bigtreetech/BIGTREETECH-OCTOPUS-V1.0/README.md

## BigTreeTech Octopus

### review
　You can find a complete review with detailed features of our electronics in [Spanish](https://3dwork.io/btt-octopus) and [English](https://3dwork.io/en/btt-octopus/) on [3dwork.io](https://3dwork.io/).
