bigtreetech/BIGTREETECH-OCTOPUS-V1.0/Hardware/readme.txt

### The latest version of the pin map
FB BTT  group provide:

https://www.facebook.com/download/526817998687953/BIGTREETECH%20Octopus%20V1.0%20%20-%20PIN.pdf

* The schematic diagrams of V1.0 & V1.1 are the same. Compared with V1.0, V1.1 only fixes the wrong silk screen(fan, spi3, uart2) on the motherboard and has changed the packaging of the power supply IC
