bigtreetech/BIGTREETECH-OCTOPUS-V1.0/Firmware/README.md

Octopus/Pro work with Firmware | Marlin | Klipper | RepRapFirmware
-- | -- | -- | -- 
STM32F446ZE | 💚good  | 💚good | ⚠️[custom by BTT](https://github.com/bigtreetech/BIGTREETECH-OCTOPUS-V1.0/tree/master/Firmware/RepRapFirmware/F446-OctoPus)
STM32F429ZG | 💚good  | 💚good  | 💚[good](https://github.com/gloomyandy/RepRapFirmware/releases)
STM32F407ZE | 💚good  | 💚good  |  :x: 512KB flash not enough & there is no customized version yet
STM32FH723ZE | 💚good  | 💚good  |  :x: 512KB flash not enough & there is no customized version yet
