bigtreetech/BIGTREETECH-OCTOPUS-V1.0/Octopus works on Voron v2.4/Firmware/Klipper/Images/menuconfig.png

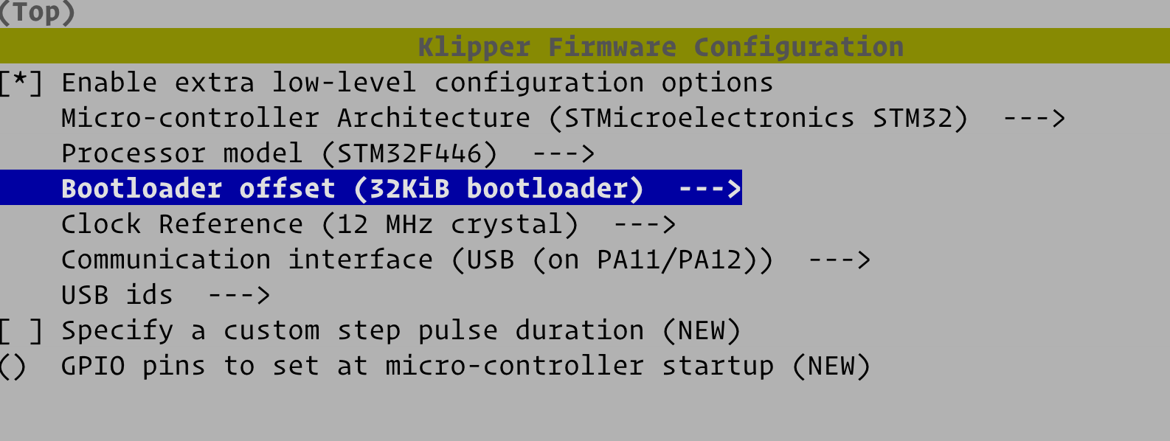
Octopus works on Voron v2.4/Firmware/Klipper/Images/menuconfig.png
