bigtreetech/BIGTREETECH-OCTOPUS-V1.0/Octopus works on Voron v2.4/Mainboard holder/Octopus stand  Horizontal.STEP

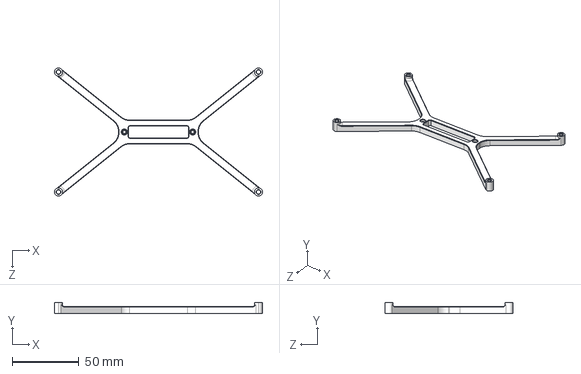
[picture p72: CAD file, 2021-07-01]
Octopus works on Voron v2.4/Mainboard holder/Octopus stand Horizontal.STEP
156.0 x 8.00 x 96.0 mm
