bigtreetech/BIGTREETECH-OCTOPUS-V1.0/Octopus works on Voron v2.4/Mainboard holder/Octopus stand   Vertical.STEP

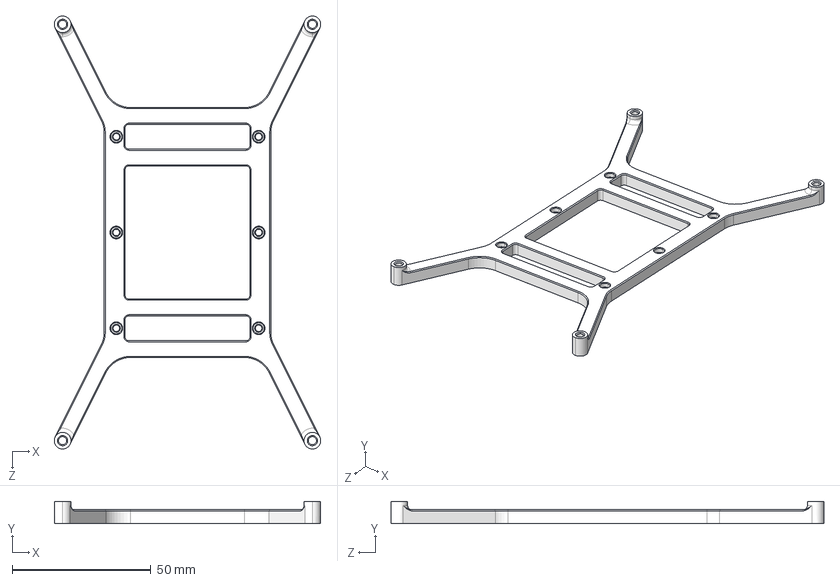
[picture p73: CAD file, 2021-07-01]
Octopus works on Voron v2.4/Mainboard holder/Octopus stand Vertical.STEP
96.0 x 8.00 x 156.0 mm
