bigtreetech/BIGTREETECH-OCTOPUS-V1.0/Octopus works on Voron v2.4/Mainboard holder/Snaps.STEP

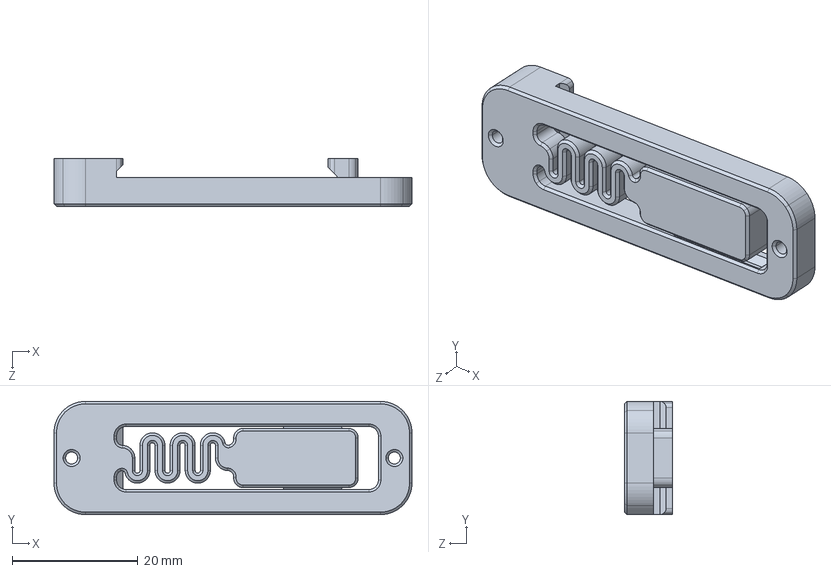
[picture p74: CAD file, 2021-07-01]
Octopus works on Voron v2.4/Mainboard holder/Snaps.STEP
56.9 x 18.0 x 7.60 mm
