bigtreetech/BIGTREETECH-OCTOPUS-V1.0/(list of files, cad)

Other CAD files:
Octopus works on Voron v2.4/Mainboard holder/Octopus stand Vertical.STL
Octopus works on Voron v2.4/Mainboard holder/Octopus stand Horizontal.STL
Octopus works on Voron v2.4/Mainboard holder/Snaps.STL
