bigtreetech/BIGTREETECH-OCTOPUS-V1.0/Firmware/RepRapFirmware/RRFBuild-SourceCode/README.md

RepRap Firmware LPC/STM32F4 Port unified build
==================================

This repository contains the build system for the LPC and STM32F4 port of RRF V3.3 and later.

To build RRF you will require additional repositories. These should be cloned into the RRFBuild directory. To create a specific version of RRF please checkout the various branches using the associated tags.
* RepRapFirmware - the main RRF source code https://github.com/gloomyandy/RepRapFirmware/tree/v3.3-dev
* RRFLibraries - Support libraries for RRF https://github.com/gloomyandy/RRFLibraries/tree/v3.3-dev
* CoreN2G - MCU specific support for LPC and STM32F4 builds https://github.com/gloomyandy/CoreN2G/tree/v3.3-dev
* FreeRTOS - RTOS support package https://github.com/gloomyandy/FreeRTOS/tree/v3.3-dev
* DuetWifiSocketServer - WiFi interface https://github.com/gloomyandy/DuetWiFiSocketServer
