bigtreetech/BIGTREETECH-OCTOPUS-V1.0/Firmware/RepRapFirmware/RRFBuild-SourceCode/CoreN2G/src/STM32F4/system/Drivers/STM32YYxx_HAL_Driver_version.md

# STM32YYxx HAL Drivers version:

  * STM32F0: 1.7.2
  * STM32F1: 1.1.4
  * STM32F2: 1.2.3
  * STM32F3: 1.5.2
  * STM32F4: 1.7.6
  * STM32F7: 1.2.7
  * STM32G0: 1.3.0
  * STM32G4: 1.1.0
  * STM32H7: 1.6.0
  * STM32L0: 1.10.2
  * STM32L1: 1.4.0
  * STM32L4: 1.10.0
  * STM32WB: 1.2.0

Release notes of each STM32YYxx HAL Drivers available here:

`system/Drivers/STM32YYxx_HAL_Driver/Release_Notes.html`

Where 'YY' is the STM32 MCU series.
