bigtreetech/BIGTREETECH-OCTOPUS-V1.0/(threads)

Thread 2 (2021-05-13):

(Q) PWM pinout

DrumClock, 2021-05-13:
Hi,
Is it possible to define PB3 and PB4 pins on J74/SPI3 conector as PWM for servo control use?

```
#define SERVO1_PIN                          PB3
#define SERVO2_PIN                          PB4
```

Thanks

bigtreetech, 2021-05-22:
Yes, you can customize

bigtreetech, 2021-05-22:
@DrumClock

Closed 2021-05-22.

Thread 4 (2021-05-16):

Motor Power in

Runklestiltskin, 2021-05-16:
Will this board support a higher voltage on motor power in?

bigtreetech, 2021-05-22:
Motor power supply is affected by capacitance, no more than 35V, main board power supply no more than 28V

bigtreetech, 2021-05-22:
@Runklestiltskin

sims-60, 2021-05-24:
@bigtreetech can i also use 12V?

looxonline, 2024-02-20:
> @bigtreetech can i also use 12V?

Yes

Thread 5 (2021-05-21):

Where is the schematic diagram?

GadgetAngel, 2021-05-21:
I hope you post the schematic diagram

cbc02009, 2021-06-19:
Please release the schematic like you have for your other boards. It's really helpful for troubleshooting issues.

HairingX, 2022-02-23:
The schematics would be very helpful indeed, please upload

GadgetAngel, 2022-02-23:
> The schematics would be very helpful indeed, please upload

The schematic has been posted.  It is just named "BIGTREETECH Octopus.pdf ". You can find it at https://github.com/bigtreetech/BIGTREETECH-OCTOPUS-V1.0/blob/master/Hardware/BIGTREETECH%20Octopus.pdf

Thread 7 (2021-05-23):

3D Step file incomplete & errors.

NAPCAL, 2021-05-23:
Step issues:
BLtouch connector has no pins.
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

5V-V_bus header; only one pin showing, and it is not through the board.
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

Also, the Daig & Boot0 connection headers are missing a pin and not through the board.
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

Power inputs and Bed output terminals are not taking up space on the board; it should start near F1 and be down to near R63.
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

Heater connections; only showing two sets of terminals when it should be four sets.
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

thisiskeithb, 2021-05-25:
Fixed in https://github.com/bigtreetech/BIGTREETECH-OCTOPUS-V1.0/commit/ec4a590edc5a7125455eeadd3bc3961491575fb9:

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

MakerJinn, 2021-06-15:
hi, I couldn't download the 3D step file listed. when I try to download it, it will open another window with codes like this
(i assume its the geometry of the parts)

how can I download this file?
Thanks a lot.

DATA;
#10=CURVE_STYLE('',#272,POSITIVE_LENGTH_MEASURE(0.1),#15793);
#11=CURVE_STYLE('',#273,POSITIVE_LENGTH_MEASURE(0.1),#17518);
#12=CURVE_STYLE('',#274,POSITIVE_LENGTH_MEASURE(0.1),#17519);
#13=CURVE_STYLE('',#275,POSITIVE_LENGTH_MEASURE(0.1),#17520);
#14=CURVE_STYLE('',#276,POSITIVE_LENGTH_MEASURE(0.1),#17521);
#15=CURVE_STYLE('',#277,POSITIVE_LENGTH_MEASURE(0.1),#42384);
#16=CURVE_STYLE('',#278,POSITIVE_LENGTH_MEASURE(0.1),#42384);
#17=CURVE_STYLE('',#279,POSITIVE_LENGTH_MEASURE(0.1),#42384);
#18=CURVE_STYLE('',#280,POSITIVE_LENGTH_MEASURE(0.1),#42384);
#19=CURVE_STYLE('',#281,POSITIVE_LENGTH_MEASURE(0.1),#42384);
#20=CURVE_STYLE('',#282,POSITIVE_LENGTH_MEASURE(0.1),#42384);
#21=CURVE_STYLE('',#283,POSITIVE_LENGTH_MEASURE(0.1),#42384);
#22=CURVE_STYLE('',#284,POSITIVE_LENGTH_MEASURE(0.1),#42384);
#23=CURVE_STYLE('',#285,POSITIVE_LENGTH_MEASURE(0.1),#42384);
#24=CURVE_STYLE('',#286,POSITIVE_LENGTH_MEASURE(0.1),#42384);
#25=CURVE_STYLE('',#287,POSITIVE_LENGTH_MEASURE(0.1),#42384);
#26=CURVE_STYLE('',#288,POSITIVE_LENGTH_MEASURE(0.1),#42384);
#27=CURVE_STYLE('',#289,POSITIVE_LENGTH_MEASURE(0.1),#42384);
#28=CURVE_STYLE('',#290,POSITIVE_LENGTH_MEASURE(0.1),#42384);
#29=CURVE_STYLE('',#291,POSITIVE_LENGTH_MEASURE(0.1),#42384);
#30=CURVE_STYLE('',#292,POSITIVE_LENGTH_MEASURE(0.1),#42384);
#31=CURVE_STYLE('',#293,POSITIVE_LENGTH_MEASURE(0.1),#42384);
#32=CURVE_STYLE('',#294,POSITIVE_LENGTH_MEASURE(0.1),#42384);

tregnier, 2021-06-22:
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

I use github desktop to download step file. There is way to do it through web interface directly, but much easier with github desktop

Pixeltrace-GER, 2021-07-16:
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

Just press the Download Button or clone the Repo

Thread 17 (2021-05-31):

Cant get Connection with USB-C

dazkit, 2021-05-31:
I can't get a connection via USB-C. If I set the jumper for Boot0, then I get the Octopus displayed as Stm32 Bootloader. The jumper next to the power LED is also set for USB-C. What can I do? Is my Board broken?

dazkit, 2021-05-31:
I solved it. My SD card reader was the problem. I used a different card reader and a different SD card to transfer the firmware.bin. And now it works.

Closed 2021-05-31.

Thread 18 (2021-05-31):

Uart / PINOUT

DJames2682, 2021-05-31:
The uart pin in klipper refers to Expansion pins in the pinout. Which is correct?

Jasonpenman, 2021-06-01:
For stepper drivers use the cs pin from the driver section of the pin diagram, I set mine up over the weekend and needed to get them working. My bad if it wasnt driver uarts you where after, if it was this should help

DJames2682, 2021-06-02:
Thank you . It was very confusing because the sample klipper config pointed
to expansion pins as uart pins for the 2208s.

Thank you.

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

Jasonpenman, 2021-06-02:
Glad to help, i was super careful setting klipper up for it. Seems a really good board so far

Thread 19 (2021-06-01):

dual z stepping motors  with Z_MULTI_ENDSTOPS,compling error

sunnypiggggy, 2021-06-01:
here is my sets in Configuration_adv.h
```
//
// For Z set the number of stepper drivers
//
#define NUM_Z_STEPPER_DRIVERS 2   // (1-4) Z options change based on how many

#if NUM_Z_STEPPER_DRIVERS > 1
  // Enable if Z motor direction signals are the opposite of Z1
  //#define INVERT_Z2_VS_Z_DIR
  //#define INVERT_Z3_VS_Z_DIR
  //#define INVERT_Z4_VS_Z_DIR

  #define Z_MULTI_ENDSTOPS
  #if ENABLED(Z_MULTI_ENDSTOPS)
    #define Z2_USE_ENDSTOP          _XMAX_
    #define Z2_ENDSTOP_ADJUSTMENT   0
    #if NUM_Z_STEPPER_DRIVERS >= 3
      #define Z3_USE_ENDSTOP        _YMAX_
      #define Z3_ENDSTOP_ADJUSTMENT 0
    #endif
    #if NUM_Z_STEPPER_DRIVERS >= 4
      #define Z4_USE_ENDSTOP        _ZMAX_
      #define Z4_ENDSTOP_ADJUSTMENT 0
    #endif
  #endif
#endif
```

stepper drivers
```/**
 * Stepper Drivers
 *
 * These settings allow Marlin to tune stepper driver timing and enable advanced options for
 * stepper drivers that support them. You may also override timing options in Configuration_adv.h.
 *
 * A4988 is assumed for unspecified drivers.
 *
 * Use TMC2208/TMC2208_STANDALONE for TMC2225 drivers and TMC2209/TMC2209_STANDALONE for TMC2226 drivers.
 *
 * Options: A4988, A5984, DRV8825, LV8729, L6470, L6474, POWERSTEP01,
 *          TB6560, TB6600, TMC2100,
 *          TMC2130, TMC2130_STANDALONE, TMC2160, TMC2160_STANDALONE,
 *          TMC2208, TMC2208_STANDALONE, TMC2209, TMC2209_STANDALONE,
 *          TMC26X,  TMC26X_STANDALONE,  TMC2660, TMC2660_STANDALONE,
 *          TMC5130, TMC5130_STANDALONE, TMC5160, TMC5160_STANDALONE
 * :['A4988', 'A5984', 'DRV8825', 'LV8729', 'L6470', 'L6474', 'POWERSTEP01', 'TB6560', 'TB6600', 'TMC2100', 'TMC2130', 'TMC2130_STANDALONE', 'TMC2160', 'TMC2160_STANDALONE', 'TMC2208', 'TMC2208_STANDALONE', 'TMC2209', 'TMC2209_STANDALONE', 'TMC26X', 'TMC26X_STANDALONE', 'TMC2660', 'TMC2660_STANDALONE', 'TMC5130', 'TMC5130_STANDALONE', 'TMC5160', 'TMC5160_STANDALONE']
 */
#define X_DRIVER_TYPE  TMC2209
#define Y_DRIVER_TYPE  TMC2209
#define Z_DRIVER_TYPE  TMC2209
//#define X2_DRIVER_TYPE TMC2209
//#define Y2_DRIVER_TYPE TMC2209
#define Z2_DRIVER_TYPE TMC2209
//#define Z3_DRIVER_TYPE TMC2209
//#define Z4_DRIVER_TYPE TMC2209
#define E0_DRIVER_TYPE TMC2209
//#define E1_DRIVER_TYPE TMC2209
//#define E2_DRIVER_TYPE TMC2209
//#define E3_DRIVER_TYPE TMC2209
//#define E4_DRIVER_TYPE TMC2209
//#define E5_DRIVER_TYPE TMC2209
//#define E6_DRIVER_TYPE TMC2209
//#define E7_DRIVER_TYPE TMC2209
```

and

`#define SENSORLESS_PROBING
`

the error messages are

`                 from Marlin\src\HAL\STM32\tft\gt911.cpp:24:
Marlin\src\HAL\STM32\tft\../../../inc/SanityCheck.h:2138:6: error: #error "Z2_USE_ENDSTOP must be set with Z_MULTI_ENDSTOPS."
 2138 |     #error "Z2_USE_ENDSTOP must be set with Z_MULTI_ENDSTOPS."
      |      ^~~~~
*** [.pio\build\BIGTREE_OCTOPUS_V1_0\src\src\HAL\STM32\tft\gt911.cpp.o] Error 1`

[configs.zip](https://github.com/bigtreetech/BIGTREETECH-OCTOPUS-V1.0/files/6577421/configs.zip)

Closed 2021-06-03.

Thread 21 (2021-06-04):

pinout description missing/wrong in Hardware/BIGTREETECH Octopus V1.0 - PIN.pdf

kw3-research, 2021-06-04:
missing description for
J16  (diag0)
J17 (diag1)
J18 (diag2)
J19 (diag3)
J20 (diag4)
J21 (diag5)
J22 (diag6)
J23 (diag7)

as indicated on user manual:
4.2STALLGUARD JUMPER SETTINGSThe  “diag” jumpers which  are  used  to  connect  the  diagnostic output  pin  to  the  endstop inputs  for drivers which  support  the  stallguard feature  (TMC2209/TMC2226)  can  be  found in the location shown in the image below.The exact diag numbering can be found by looking at the pins file or the silkscreen beneath the board.

and mention 'diag n." incorrectly assigned to endstops connectors (instead "stop n.")

jwestmoreland, 2025-01-06:
Hello,
Can you please post this:
https://www.facebook.com/download/526817998687953/BIGTREETECH%20Octopus%20V1.0%20%20-%20PIN.pdf
- somewhere besides facebook?  We all don't have facebook accounts - not a great assumption IMHO.  When I
tried to download - it said I had to have a facebook account to download - maybe that wasn't the case when this was originally posted.

Thanks,
John

Thread 22 (2021-06-08):

Octopus not detected

sims-60, 2021-06-08:
I connected the octopus to my pc and then on the octopus the leds also light up but the pc don't detect the octopus board

dazkit, 2021-06-08:
try that https://github.com/bigtreetech/BIGTREETECH-OCTOPUS-V1.0/issues/17

sims-60, 2021-06-08:
ok

dazkit, 2021-06-08:
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
you have to put this jumper to connect via usb

sims-60, 2021-06-08:
but when it is the sd card reader why the pc then can't connect to the board

dazkit, 2021-06-08:
do you use an external power supply or do you only connect it with usb? If you only connect it with USB you have to set the jumper next to the Power LED

sims-60, 2021-06-08:
i use usb and i have set the jumper and the leds also light up

dazkit, 2021-06-08:
Try to set the Jumper at Boot0. Did  you get a USB connection?

sims-60, 2021-06-08:
yes

dazkit, 2021-06-08:
I had the same Problem after i installed the firmware.bin then i get a connection. Its not a Problem from the SD Card reader. Try to reinstall the firmware.bin

sims-60, 2021-06-08:
what do you mean with reinstall the firmware.bin

dazkit, 2021-06-08:
Firmware is marlin or klipper. Which one do you want to use?

sims-60, 2021-06-08:
klipper

dazkit, 2021-06-08:
https://github.com/bigtreetech/BIGTREETECH-OCTOPUS-V1.0/blob/main/BIGTREETECH_Octopus_EN.pdf

here on page 20. You have to create a firmware.bin and insert it into the board with a MicroSD card and transfer it

sims-60, 2021-06-08:
i know

sims-60, 2021-06-08:
have you discord? because i cant send my firmware on github github not support .bin files

dazkit, 2021-06-08:
sorry i have no discord. I had the same Problem after i create the firmware.bin and transfer it with a sd card my board was not recognized with USB. Than i used a different SD Card and now it works. I think you have the Same Problem as me. If that's not the problem, then your board is probably broken

sims-60, 2021-06-08:
do you use klipper?

sims-60, 2021-06-08:
and  i have the exat same problem

sims-60, 2021-06-08:
can you send me your firmware.bin?

sims-60, 2021-06-08:
here is my email

sims-60, 2021-06-08:
fkp00065@zwoho.com
its a trash mail which only exist for 10 minutes

dazkit, 2021-06-08:
okay

sims-60, 2021-06-08:
thank you

sims-60, 2021-06-08:
I WORKS

sims-60, 2021-06-08:
i think i had an error im my firmware

dazkit, 2021-06-08:
Ok then close this thread and have fun :)

sims-60, 2021-06-08:
thank you

lowtolerance, 2021-06-13:
Can I have this magic firmware.bin? I can't seem to get this board to recognize my binary off of the SD card, and IDK if it's the binary of the board. A known-good klipper binary would be a big help, and I'm not sure why BTT doesn't give publish one themselves.

sims-60, 2021-06-13:
hi  can you send a mail to this mail : sqf86920@eoopy.com?
then i will send you the firmware

sims-60, 2021-06-13:
because i can't send a .bin file with github

lowtolerance, 2021-06-13:
I actually managed to sort this out myself, I don't think your firmware
would have helped. I jumped two of the wrong pins for sensorless homing and
I think it was putting the bootloader into an error state.

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

sims-60, 2021-06-13:
oh ok in this moment i wanted to send you the email XDDDD

Voodoobrew101, 2021-09-30:
I dont use klipper, but in Marlin these sound like the types of issues you get when you use the wrong
#define SERIAL_PORT           1  // TFT
#define SERIAL_PORT_2      -1  // USB
#define SERIAL_PORT_3       2  // RPI, Raspberry Pi
settings. In my experience the order is also important. My settings are as above, which are the defaults in this github.

drelich, 2022-09-07:
I know this is a year old topic, and I hate to resurrect it, but just was dealing with the same thing. For two hours I was pulling my hair because I couldn't see any response to either `lsusb` nor `ls /dev/serial/by-id/*`

Turned out I accidentally compiled Klipper FW with the wrong MCU frequency. My board is model 429 with MCU freq. of 8MHz but I compiled the FW for the other version with 12MHz. Once I realised my mistake and recompiled FW with the correct frequency, the board indeed came back to life and I could see meaningful output to both the `lsusb` and `ls /dev/serial/by-id/*` commands.

Just thought I'd share in case somebody made the same mistake :)

whatder1, 2025-01-01:
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

How did you get the updated firmware installed?  Using the SD?  I ask because I think I may have bricked mine but I can't seem to update the firmware using the SD card (downloaded a stock firmware file from BTT's GitHub, renamed it to firmware.bin and inserted into the Octopus).  the firmware file hasn't been renamed so I suspect that it isn't flashing...

Closed 2021-06-08.

Thread 24 (2021-06-10):

Klipper UART

DJames2682, 2021-06-10:
It appears the uart pins for 2208's are labled as expansion pins.
Is this correct ?
for example PE8 is labled as Motor uart pin but also labled as an expansion pin EXP1_1.

dazkit, 2021-06-11:
You have to adjust it. These are the uart pins. The ones marked in red. For uart you only need the #uart_pin. You can delete the #tx_pin reference.

this is from the new Pin.pdf
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

tregnier, 2021-06-22:
that worked for me like this too.

Don't follow the config file for klipper configuration from this github, just set the jumper as shown on the manual, and then set UART_pin based on CS column mention here. nothing else needed
Thanks dazkit

Thread 25 (2021-06-13):

Entering DFU mode

lowtolerance, 2021-06-13:
How do I actually  get the Octopus into DFU mode? I've tried putting a jumper on the boot pins and pressing the reset button as well as pressing and holding the reset button, but nothing I do seems to force DFU.

lowtolerance, 2021-06-14:
I had a misplaced jumper that I think was causing the bootloader to hang. With the jumper removed I was able to communicate with Octopus from STM32CubeProgrammer

Closed 2021-06-14.

Thread 27 (2021-06-19):

power in puts 5v out

luigi20000, 2021-06-19:
hello,
i run on my board klipper so I use a raspberry pi and my octopus board keeps powered on.
my power supply is activated with a relay because it has a fan.
but wat i found now is that the fan gets power from the power in this cant be normal i think?
i know about the jumper but the board need to be kept powered on for me

Thread 28 (2021-06-20):

Unknown board ID 'marlin_BigTree_octopus_v1'

user-e, 2021-06-20:
How to reproduce:

- Clone the rep
- Open it with Vs Code with PlatformIO
- Build

Result:
```

Executing task: platformio run

Processing BIGTREE_OCTOPUS_V1_0 (platform: ststm32@~12.1; board: marlin_BigTree_octopus_v1; framework: arduino)
-----------------------------------------------------------------------------------------------------------------------------------------------------------------------------
Error: Unknown board ID 'marlin_BigTree_octopus_v1'
The terminal process "platformio 'run'" terminated with exit code: 1.

Terminal will be reused by tasks, press any key to close it.
```

Default Configuration.h, default Configuration_adv.h, and default Platformio.ini

DJames2682, 2021-06-20:
Hey I just did this. Go into the boards.h file in marlin 2.0.9 highlight
the Btt_ octopus and copy the info that pops up. Exactly.

They changed the name. In 2.0.9

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

user-e, 2021-06-20:
@DJames2682
I'm not sure to had understood you. That's the popup that appear in boards.h file at the octopus declaration:

[Image](https://i.postimg.cc/TP6YDrG5/Schermata-da-2021-06-20-20-25-31.png)

bwspath, 2021-06-23:
the board name in ini/stm32f4.ini is wrong:
` -board             = marlin_BigTree_octopus_v1`
vs
`+board             = marlin_BigTree_Octopus_v1`
that  should fix it.

DJames2682, 2021-06-23:
Sorry I went back and looked. The build environment that worked or me was BTT_OCTOPUS_V1 in 2.0.9.

Also.

Octopus 1.0. thermal runaway and connection issues after bootloader and firmware update.
Almost burnt it down . Cant communicate with the pc to reload the new bootloader, flash firmware, and the mcu get so hot it resets every 15 sec. Oh and every heater turns on and stay on. Be careful.

user-e, 2021-06-23:
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

It works! Perfect!

Closed 2021-06-23.

Thread 30 (2021-06-22):

Communication Error

DJames2682, 2021-06-22:
While Flashing an updated marlin I was having difficulty maintaining communicaiton wiht the board.
The new firmare refuses to flash.
I atempted to update the bootloader but the board is recognized by the pc but not the bootloader softwear.
When hooked to pronterface. Reads connected.
When the mcu is powered it constantly drops the connection.
Please advise.

Thread 31 (2021-06-22):

Urgent issue

DJames2682, 2021-06-22:
Upon loading the new bootloader, USB Counication will not establis,
New firmware.bin files will not flash. The board constantly reboots and the MCU is extreamly hot.

More importantly.
A major issue with thermal runaway. All heaters on the board when recieving power for the main begin to heat uncontrollably.
this occurs with the Bed, Heater 0 and 1 (I note that all the indicator lights for the heaters are on.

This could have lead to a fire or metdown.
I've seen several other posets in varrious forums to this effect.

user-e, 2021-06-23:
@DJames2682
I know that this is not a forum but...
If you are no more able to flash the MCU through DFU or SD card, you can try to program it with the ST-Link Programmer and write the older bootloader.

DJames2682, 2021-06-23:
It is not but I thought the situation with the thermal runaway warented someone looking into it.
The board will connect to the pc but the software will not recognize it.

looxonline, 2021-07-03:
As far as I understand this was because of some incorrect wiring on the probe. Is that correct?

DJames2682, 2021-07-03:
Yep. Had the pins switches on the z endstop w/ a bltouch....not entirely
sure why I caused the heater issues

On Sat, Jul 3, 2021, 12:26 PM Luke Harrison ***@***.***>
wrote:

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

Thread 33 (2021-06-25):

Pin PB7 on J40 is not working

ewalbridge, 2021-06-25:
Pin PB7 on J40 (SENSOR) is not working for the inductive proximity sensor but when I connect it to PB7 J43 (BL_TOUCH) it works. The inductive proximity sensor is 24v so I need the 24v from J40 and not the 5v from J43.

Is there a setting I am missing or a jumper that I need to set to enable PB7 to work on J40?

looxonline, 2021-07-03:
There are a few options available to get this to work. You likely have an NPN style sensor which means that you will need to add an external pull up. To you this you just need to connect a 4k7 resistor between the voltage pin of the probe and the signal pin. Then you will need to configure your firmware to invert the input signal and enable the pull down, ~! in Klipper. There will be no BAT85 required with this config.

denisrohr, 2021-07-12:
If you look at https://github.com/bigtreetech/BIGTREETECH-OCTOPUS-V1.0/blob/master/Hardware/BIGTREETECH%20Octopus.pdf
you can see the pin "PROBE" on J40 is attached to an optocoupler EL357C with a 1k resistor. The optocoupler has a 1.4V forward voltage and a max current of 50mA. This means you can attach any signal to it directly without any diode, even 48V should be fine. Attach the 12V-48V signal of the probe directly to the third pin of J40. The third pin is NOT PB7, but connects to an optocoupler which sets PB7 to HIGH if PROBE has atleast 12V voltage.
DO NOT attach PROBE directly to PB7 on J43.

I use a NO inductive probe without any diodes at 12V supply voltage and connected the signal pin directly to PROBE on J40.
My klipper config is:

...
[probe]
pin: ~PB7
...

ga73, 2021-07-17:
This really needs to be resolved and poor by BTT to just not answer... Doesn't give me any reason to buy their products when others such as FYSETC actually respond to issues!

Answer please with a solution BTT!

looxonline, 2021-07-17:
> This really needs to be resolved and poor by BTT to just not answer... Doesn't give me any reason to buy their products when others such as FYSETC actually respond to issues!
>
> Answer please with a solution BTT!

There is no point for them to respond when the answer has already been given in this thread. If you took the time to read it instead of getting aggressive and threatening then you would already have your issue solved. Otherwise, there is always the Fysetc which will literally kill your LCD in a puff of smoke and a high % of the boards were suiciding on their first power up with drivers installed.

looxonline, 2021-07-17:
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

This is only true if your probe is PNP style. I.e. that it will output a high voltage when triggered (or when not triggered) and simply float when in the opposite state. If you have an NPN style probe that pulls to ground when active and floats otherwise then you'll need to add a little pull up resistor between the probe signal pin and the voltage supply to the probe. That will provide the current source for when the probe leaves the signal pin floating that will in turn drive the optocoupler.

ga73, 2021-07-17:
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

Nobody is "getting aggressive", I'm looking for an official reply from btt who seem to be happy to let their customers sort out their problems, there are 2 answers both of which aren't clear to me and I'm guessing many others who aren't as electronically minded as some.

Your reply seems a little bit pointless as it's of absolutely no benefit, maybe if you're going to reply make your replies helpful or just say nothing.

looxonline, 2021-07-17:
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

I encourage you to browse through these github issues. You should notice that BTT don't use this as a channel to provide customers with support. Their github is a repo to provide customers with info on their products. They have specific support channels which can be found on their discord server, facebook groups and websites. The issues tab is left open specifically for customers to discuss things in an open forum. Granted, it may be best for them to include that info in their readme files to make it clear.

My reply is quite helpful actually, maybe not to you but to others. Why?

1.) It should help others to see that there is actually no problem whatsoever with this input. Users simply need to connect up to it in the right way.

2.) It should help users who read your response demanding a reply from btt to clearly understand that the answer has already been provided. Twice on this thread in fact. They therefore can take the info that has already been provided and apply it instead of being left in doubt as to whether or not it will work.

3.) It should help users to be aware of the issues with the Fysetc board so that they can make an educated decision about whether or not they would be willing to take the chance with it.

Back to the point at hand. To fix your connection you need to:

> "connect a 4k7 resistor between the voltage pin of the probe and the signal pin."

In addition to the above you need to remove the BAT diode completely as it is not needed with this input. It is an optocoupler which is better than the standard inputs on other boards and has no need for a protection diode. Instead all it needs is a pull up resistor with NPN style probes which is evidently what you are using.

ga73, 2021-07-17:
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

Hi thanks for the reply which is helpful.

So in laymens terms, I simply need to solder the 4k7 resistor to both the v+ and the probe sensor wire and remove the bat85 resistor?

Many thanks
Ga

looxonline, 2021-07-17:
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

Exactly. Solder or crimp into the connector terminals for the probe. Whichever works best for you.

ga73, 2021-07-17:
Thank you very much! 😊👍

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

mj2068, 2021-07-18:
i've been combating this issue for a whole day in the office, on a Sunday. And now, it's 1 am in the morning, i'm still reading on the web trying to find answers to prepare for tomorrow. i'm so so happy i found this post, and it seems exactly like my situation, so, after reading the whole thing, i'm fairly confident, it'll be solved right after i shovel that 4.7k R in there, first thing in the morning.
people like you, @looxonline, are the unsung heroes of the internet, for that, i salute to you.

onurddd, 2021-08-04:
Can anyone share marlin config file with working probe settings please

looxonline, 2021-08-04:
> Can anyone share marlin config file with working probe settings please

What kind of a probe are you using and where have you connected it. There is not just one config file because there are hundreds of different probe permutations out there.

onurddd, 2021-08-04:
Sorry, I use NPN type capacitive sensor that connected to j40 header. I will not use  z min switch . Capacitive probe will be  used for bed leveling and  as a z min limit switch.

looxonline, 2021-08-04:
> Sorry, I use NPN type capacitive sensor that connected to j40 header. I will not use z min switch . Capacitive probe will be used for bed leveling and as a z min limit switch.

Then you will need to apply the pull up resistor mentioned earlier in this thread. You will also need to enable a software pull down on PD7 within Marlin and likely set the signal to inverting for the probe on PD7.

looxonline, 2021-08-04:
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

Unfortunately I don't but I know that it does work from having helped many others to get it to work. You may also need to check that the pin mappings in the pins file are correct too. Also remember that you can't/don't need to use a BAT85 with this board.

Teila, 2021-08-05:
While I am not using the octopus on my marlin controlled system (klipper based  for this guy) I had to use the following setup for my inductive probe.

[probe]
pin: ~PB7 #enable micro-controller pulldown

amazon.com/gp/product/B08MX6SHD4 <- Probe I am using

Aurawin, 2021-08-07:
I've just got mine working with no resistor by re-mapping the J31 diag pin PG10 -> you can re-map marlin to look there for the low voltage signal - assuming your inductive probe goes to ground when triggered.

#define Z_MIN_PROBE_PIN PG10
#define Z_STOP_PIN PG10

onurddd, 2021-08-09:
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

As Teila said, Bp7 pin needs to be pulled down. İf you look at the octopus pins you can see Probe has a optocoupler at j40 header. Then this optocoupler connected to Pb7 pin . There is an exposel Pb7 pin on j43 header if you measure  the pb7 and gnd pins with a voltmeter, you need to measure 3.3 volts. İf you trigger the probe (j40 header)  without any pull down and pull up pb7 voltage goes to 0.6-0.7 volts and signal doesn't count as 0. If you assign pull down to Pb7, when you trigger the probe Pb7 voltage goes to 0.08 and it counts as 0 signal.

Aurawin, 2021-09-22:
I wanted to try using the optocoupler.  This time I'm using a NO PR18-5DP Cylindrical Type Detector 5mm DC12-24V 3-Wire PNP NO(Normally Open) with 24V selected input wired to J40.  If I measure PB7 on J43 when the sensor is triggered I can see the 3.3V when triggered and 0.4-.7v when not triggered.

#define MOTHERBOARD BOARD_BTT_OCTOPUS_V1_1

// No combination of Endstop pulling changes the fact that marlin will not detect the probe
// #define ENDSTOPPULLUP_ZMIN_PROBE
// #define ENDSTOPPULLDOWN_ZMIN_PROBE

#define Z_MIN_PROBE_PIN PB7

But no matter what I do I can't get Marlin to detect the signal using M119 - It's always triggered for Non-Inverted signals or always open for signal inversion.

I'm using 2.0.9.1 from Marlin direct, are there any changes lately that the upstream repo doesn't have regarding this issue?

looxonline, 2021-09-22:
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

Try the latest bugfix. I've had issues with 2.0.9.1.

onurddd, 2021-09-22:
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

Try to cancell all the pull ups and activate pulldown for  Z_MIN_PROBE_PIN PB7, ZMIN_PROBE and ZMIN. I couldn't make it work untill the pull down resistors are activated.

Aurawin, 2021-09-22:
@onurddd , I tried enabling the pulldowns but got this error on building
Compiling .pio\build\BIGTREE_OCTOPUS_V1\src\src\HAL\STM32\eeprom_sdcard.cpp.o
In file included from Marlin\src\HAL\STM32\../../inc/MarlinConfig.h:49,
                 from Marlin\src\HAL\STM32\HAL.cpp:28:
Marlin\src\HAL\STM32\../../inc/SanityCheck.h:725:4: error: #error "PULLDOWN pin mode is not available on the selected board."

Aurawin, 2021-09-23:
Update:  Got it working.  Looked in Marlin Source code and the pulldown code wasn't being executed.  The reason being
Configuration.h ...

#define USE_ZMIN_PLUG
#define USES_Z_MIN_PROBE_PIN PB7

These 2 defines need to be declared in order for the ENDSTOPPULLDOWN_ZMIN_PROBE to pull the voltage down on the optocoupler.

rakeshdutta90, 2021-09-30:
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

Does that mean you are saying if I use PNP style probe and select 12v/24v from J38 and connect the signal wire from the probe directly to PB7 (J40) will get the reading from without any issue?

rakeshdutta90, 2021-09-30:
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

So if I use PNP NO
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

Thread 36 (2021-07-06):

Voron 2.4/Klipper TMC2209 Steppers off

ga73, 2021-07-06:
Hello, followed the instructions exactly, Voron starts up but motors do not move and message on LCD "Steppers OFF".

Is this a bug or a setting that needs to be updated in the config ??

Thank you.

looxonline, 2021-07-17:
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

Since there are thousands of octopus users who don't have this issue it would clearly seem to be something with your config. The best place to find support on this would be the Bigtreetech channel on the Voron discord or the VoronElectronics channel.

Thread 37 (2021-07-07):

FAN do not get full speed

fiveorders, 2021-07-07:
Hello, I am using FAN0 port for the radial blower fan but it doesn't get full speed when %100 and when %50 it stops. I am using a 5v Radial FAN. Tried with 12v radial fan by switching to 12v by jumper. It is the same. And also I used the always on fan ports but they do not go full speed as well. What am I doing wrong? Thanks

Closed 2021-07-11.

Thread 39 (2021-07-13):

no flashing

Michil783, 2021-07-13:
I have Octopus v1.1 and since today I could not flash a new firmware.bin file via SD card. firmware.bin is renamed to firmware.cur (0 bytes length) but it is not flashed. Still old firmware active and working. FUnctionality of 3D printer is normal.
I also tried to flash bootloader (which was successful) but no change in behaviour

Michil783, 2021-07-15:
Problem solved. Somehow the firmware.bin file was 0 bytes in size and I didn't recognized it.

Closed 2021-07-15.

Thread 41 (2021-07-13):

max output for neopixel port ?

DocYester, 2021-07-13:
what amount of led's can be connected to the neopixel-port ?
or what is the max output in mA on PB0 (J37) ?

Seminole81, 2021-08-12:
Did you find out? I am also wondering this.

DocYester, 2021-08-16:
No, i'll keep it as for other boards ... 30 led max -> 1,5A peak
Actually running it without problems

Seminole81, 2021-08-16:
I read somewhere last night that the max. amps this board can handle is 8. However, I have heard from BTT that it can do up to 30 without max. current. I saw someone 44 fine.

DocYester, 2021-08-16:
8A all over the 5V rails ... so you cant use it all for calculating for led's - i read it in the docs too
i think it could handle several more, but i wont test it just to fry the board

so i'm waiting for an official answer

Seminole81, 2021-08-18:
Ok, well someone else I know on Facebook is successfully running 60 LEDs with the board. BTT told me 30 via an email (guessing that's a safe one).

matthewdolman, 2021-11-03:
Oops, I didn't realise this could fry the board, I just thought it would stop working if too much power gets drawn.

I ran 144, with nothing else going, I tried to add another 72 but got a message in klipper that the max was 166.  It would be nice if there was some documentation or even a response from BTT on this.

simplified-life, 2022-12-08:
I'm just about to wire up 90 neopixel LED's, but thinking perhaps it is better to power them all from with a 24v to 5v step down and then control them with the Raspberry Pi. Or should I control them off the Bigtreetech Octopus Pro 1.0 board I've got coming?

matthewdolman, 2022-12-09:
You will need a 5v power supply that can handle the current of the LEDs the normal budget for neopixels is 0.05A so for 100 you will want 5A from your power supply, in addition you will need power for your raspberry pi.  I ended up getting a 16A one to give me plenty of room.

Thread 42 (2021-07-17):

PROBE SENSOR NOT WORKING

ga73, 2021-07-17:
Can someone advise on how to get the probe sensor working, its all wired correctly and has the bat85 installed.. Probe lights up and off when putting something metal underneath but is not sensed in the fw.

Does this need moving to another pin or ??

looxonline, 2021-07-17:
> Can someone advise on how to get the probe sensor working, its all wired correctly and has the bat85 installed.. Probe lights up and off when putting something metal underneath but is not sensed in the fw.
>
> Does this need moving to another pin or ??

The answer to this has already been provided in the other issue where you had a rant. Just read it and apply it and you will be good to go.

Aurawin, 2021-08-07:
Alternatively, I've just got mine working with no resistor by re-mapping the J31 diag pin PG10 -> you can re-map marlin to look there for the low voltage signal - assuming your inductive probe goes to ground when triggered.

#define Z_MIN_PROBE_PIN PG10
#define Z_STOP_PIN PG10

Just remove the actual pin from the 3 pin JST connector and manually put it into PG10.

Hman32, 2022-04-16:
Will be dangerous if the probe does not output 5v or less when he trigger...
The sensor port is intended to be protected with a optocoupler, just sad is not working as expected.
In my case I ended adding an external optocoupler and I've used the pin for the Z endstop.

Thread 43 (2021-07-17):

RRF SBC version

valenti1234, 2021-07-17:
Since I try to recompile, but without success, can you guys put an SBC version of RRF firmware?

wolfgangmauer, 2021-08-09:
I need this too !!!

wolfgangmauer, 2021-08-10:
And please also describe how the RPi must be connected.

jaysuk, 2021-08-10:
you would need to create a new build with SBC support enabled.
The WiFi version that BTT built it very buggy anyway so honestly, I wouldn't even bother running RRF of this board.
This is due to the MCU only have 512kb flash.
RRF is only going to require more flash going forwards.

wolfgangmauer, 2021-08-10:
What a shame, I really like RRF and the VORON-kits come with an OctoPus
and RPi....

Am 10.08.2021 um 15:13 schrieb jaysuk:
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

Thread 44 (2021-07-20):

EXP pins in diagram wrong

cmathiswausau, 2021-07-20:
According to the silk screen and the pins diagram the diagram below is incorrect, it should be PB2 for pin 6 and PB1 for pin 8.

/**
 *               ______                                              ______
 *           NC | 1  2 | GND                                     5V | 1  2 | GND
 *        RESET | 3  4 | PC15 (SD_DETECT)             (LCD_D7) PE15 | 3  4 | PE14 (LCD_D6)
 *   (MOSI) PA7 | 5  6 | <---> PB1  (BTN_EN2)               (LCD_D5) PE13 | 5  6   PE12 (LCD_D4)
 *  (SD_SS) PA4 | 7  8 | <---> PB2  (BTN_EN1)               (LCD_RS) PE10 | 7  8 | PE9  (LCD_EN)
 *    (SCK) PA5 | 9 10 | PA6  (MISO)                 (BTN_ENC)  PE7 | 9 10 | PE8  (BEEPER)
 *               ------                                               -----
 *               EXP2                                                EXP1
 */

#define EXP1_03_PIN                         PE15
#define EXP1_04_PIN                         PE14
#define EXP1_05_PIN                         PE13
#define EXP1_06_PIN                         PE12
#define EXP1_07_PIN                         PE10
#define EXP1_08_PIN                         PE9
#define EXP1_09_PIN                         PE7
#define EXP1_10_PIN                         PE8

#define EXP2_03_PIN                         -1
#define EXP2_04_PIN                         PC15
#define EXP2_05_PIN                         PA7
**--->**#define EXP2_06_PIN                         PB2
#define EXP2_07_PIN                         PA4
**--->**#define EXP2_08_PIN                         PB1
#define EXP2_09_PIN                         PA5
#define EXP2_10_PIN                         PA6

Thread 45 (2021-07-24):

Board not detected by Windows

PrideParrot, 2021-07-24:
Hi,
just got my Octopus 1.1 and try to upload Marlin on it. But after connecting board via usb device not detected by Windows (no new devices in Device Manager, any type), aslo not detected by STM32CubeProgrammer (any connection type). Tryed to power board via usb-c or via external 24v supply (without J68 jumper), but no differents.  If I understand correctly, I don't have bootloader on board. But uploading it via SD-card not working (no “FIRMWARE.CUR” on SD-card in the end).

Is it possible to alive board with USBasp or else some how?

Windows: 10 Home
Version: 20H2
OS: 19042.1110

DJames2682, 2021-07-25:
Try removing all the other connections ie stepper an fan cables etc.  That's what I had to do m theory is t was trying to feed power to the components with connected.

PrideParrot, 2021-07-25:
@DJames2682 , all discriben earlie was tested without any additional load on board. Also USB-C connection was tested via USB-C to USB-C wire and I get the same result as USB-C to USB-A that was in the box with board.

DJames2682, 2021-07-25:
It took a little persuasion to get mine to connect. On a windows computer I went under device manager and deleted all of the com ports. Took the board completely out of the printer. Installed the jumpers and uses an actual USB 3.0 cable . Had the software running when I reconnected the board. I'm not sure what of this combination worked for me but it was a little touchy getting it to connect to the pc via the bootloader software.

PrideParrot, 2021-07-28:
Cheched variant with smaller SD card - with no result.

Tryed to connect via St-Link v2 (PA13(SWDIO), PA14(SWCLK)) but St-Link don't found target (STM32 ST-LINK Utility and STM32CubeProgrammer). Seems my board is a brick.

DJames2682, 2021-07-28:
Try dissconnecting everything from the board. Worked for me

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

PrideParrot, 2021-07-28:
All described earlier was tested only with board without any additional modules. Also checked for mechanical damage or bad soldering and didn't found anything.

PrideParrot, 2021-07-28:
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

While inspect and comparing board with different sources found that I have slightly different board (red circle)  also Led (D51 - Power - Yellow circle) is disabled when power on.

Found that documentation is out of date:
BIGTREETECH Octopus - PIN.pdf
BIGTREETECH Octopus - SIZE.pdf

U8 Regulator updated(?) on my board.

PrideParrot, 2021-07-31:
Seems that don't have 3.3V on U15 regulator, just ~113mV, but 5V line is Ok.
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

PrideParrot, 2021-08-02:
U15 regulator was replaced to same one, but still no power. Also was founded that U15 pin 5 has connected to GND somehow. After checking C110 seems it's not working properly (pin 5 via C110 connectet to GND). Capacitor don't have capacity or resistance. After unsoldering C110 I check this capacitor and it's seems Ok. But U15 pin5 still connected to GND. Seems I have connection beetwen 3.3v line ang GND.
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

PrideParrot, 2021-08-04:
Also communicated with BTT support. They proposed to unsolde U15 and retest for short. Without U15: 3.3V and GND - still connected, 5V and GND - not connected. This pic is just example, 3.3V and GND connection still not founded.

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

Valerrra, 2021-09-11:
Hi faced the same problem. "Octopus" worked the day before, the board was in standby mode, suddenly found that the stepper motors began to knock. RaspberryPi stopped seeing the board. I removed it, connected it to a laptop, but the laptop did not detect the board either. I checked for overheating, found the voltage detector heated up to 80 degrees Celsius. I checked the nearby components and found a failed diode and a 100 kΩ resistor.
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

callistopili, 2021-11-13:
initeresting, I got the same issue on my Octopus v1.1.

I power up the first time from the USB-C and the board was Ok.
I them programmed the new klipper wiith TMC5160-1.2 with SPI configuration(and jumpers set as 1-2(on the MSx pins).
I then Connected the driver on X axis and powre up them with the Motor Board(12V as test and one motor), but powering the electronics at the USB-C (the 5V power jumper still set as closed).

no issues, then I started the process again with a Y Z with motors, and everything was OK.
at some point but I cannot replicate anymore I added E0 drivers and motors nd weird issues appeared.
As soon I powered the board I recognized no power LEDs on at the 3.3V rail LEDs, near to the U15 regulator.
Very hot U15 and TMC driver E0 and I switched off.
I then removed the E0 driver and even if I remove all the drivers I got the board not working.

I checked with a multimeter and I noted there is a short on the VOUT of the U15 regulator, I desoldered U15 to check clearly where the short is and the pad at Vout is still shorted (resistance about 1.1Ohm) to ground.

I powered the board to check if the 5V inpunt pad is ok and the multimeter detects 5V input(pin1) but withtout U15 of course i cannot get 3.3V.
with a short ongoing  it is a no-sense to replace the U15 due to the somewhere short on the line.

any clue?

callistopili, 2021-11-13:
from the schematic, the ..3 coming out from the regulator, powers digital side of the drivers, the endstops,buffers and the CPU.
the SLEEP pin(6) for the modded/unmodded drivers doesnt seems to be the reason for this short.
the 3.3V regulator U8, seems working ok. not U15.

callistopili, 2021-11-13:
I double checked my setup, and it is likely one new tmc5160 i fitted in E0 was faulty and leaving standalone i measured the digital power pin and ground with a multimeter and sadly it was shorted draining lot of current on the 3v3. still unsure why the CPU should be affected. still dont know why but because of that, probably the CPU is fried having a short into the +3v3 power rail. I will fix  replacing a new cpu in this case.

PrideParrot, 2021-12-06:
Forgot to add. I contacted the seller to replace the board, and he agreed to the terms of payment for the delivery. I paid for the delivery, the parcel never arrived (invalid track, no response from seller).

tinkydan, 2021-12-23:
Did any one manage get the board working again? It looks like I am having the same issue after I had the power supply plugged in to a faulty power strip.

Valerrra, 2022-05-04:
yes I removed the processor and the problem disappeared on all channels

israelsu, 2022-05-06:
this is the 2nd board running in to the same issue.
all the leds on the board are on. nothing works.
No more BTT for me - i'm done with this S***

Rincewind08, 2022-10-09:
Likewise, I wasted 44$ on this board from ali express, shelved it for a couple months, went to start it and it only powers off of usb-c and will not fucking install marlin.  For god sakes BigTreeTech, I e been a loyal customer to the brand since the skr 1.3, I have a PILE of your boards, including two burnt dead gtrs, an skr 1.4, a skr 1.4 pro, a board of your driver's, and the newest thing is always a total pile of mismarked garbage.  How the fuck do you people sleep at night?

cd85233, 2022-10-20:
Hi guys just wanted to add something I found.

I had issues with no comm and board didn't show up as a port. I was able to trace it to the 3.3 regulator u15. I lifted the Vout pad and hooked it up to a power supply. I got comms back and was able to get into dfu mode. You might have something loading down your regulator or the mcu is toast.

Also, if they are using the RT-9193 and the schematic is correct, then they did not follow the recommended layout by tying BP to gnd with a bypass cap. This might be why it seems folks are having issues. The data sheet specifically states not to leave it floating.

azytzn, 2022-10-22:
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

Hi cd85233,
I have a brand new octopus 1.1 with F446 chip. Trying to flash but pc doesn't detect it. Also cannot flash using sd card. Can u please share a photo of your card and the spot that u mod.
Thanks

cd85233, 2022-10-22:
Sure. Here it is. It's not pretty but it works.
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

Sagittariin, 2022-11-01:
@cd85233 so if i desolder the U15 and do that mod  that you did , my octupus v1.1 can be saved?

ImpulziveMyztik, 2022-11-26:
Just firing up my octopus v1.1 board after having installed it in the printer. I had loaded firmware onto it perfectly fine before, but now the thing doesn't respond. I can connect to it from my pc via usb, but the serial is just an endless loop of max3421e initialization, got 255. Anybody know if this error is related to the u15 issue here? Or am I correct in understanding that the u15 issue here is actually completely disabling boards all together, like no serial console or anything?

MichalMaRozbitouDeskuNaEnderaLol, 2024-01-25:
I think its broken.

Thread 46 (2021-07-25):

How to configure ps_on on klipper J36 / PE11

carmanuelz, 2021-07-25:
Hi, Im trying to use the ps_on pins with klipper whit the SKR Octopus 1.1, but it doesnt work.
I am using PE11 from J36 to power a Relay, but I have not been successful.
This is my config on klipper:

```
[output_pin ps_on]
pin: PE11
value: 1
```

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

wolfgangmauer, 2021-08-09:
I use a BTT Relay 1.2 and it works fine:

[output_pin power]
pin: PE11
value: 1
shutdown_value: 0

Thread 47 (2021-07-25):

Klipper can only connect when power over usb

sims-60, 2021-07-25:
Hi my raspberry pi 4 with klipper can only connect to the board when i set the jumper that the board get the power over USB.

Closed 2021-07-25.

Thread 48 (2021-07-26):

Unknown board ID 'marlin_BigTree_octopus_v1

Nikola131313, 2021-07-26:
Attempting to build throws an error:

Processing BIGTREE_OCTOPUS_V1_0 (platform: ststm32@~12.1; board: marlin_BigTree_octopus_v1; framework: arduino)
--------------------------------------------------------------------------------
Error: Unknown board ID 'marlin_BigTree_octopus_v1'

Nikola131313, 2021-07-26:
Error found: in the file stm32f4.ini , line 241 must be 'octopus' capitalized.

Closed 2021-07-26.

Thread 49 (2021-07-28):

Steppers not moving with stock firmware

PouncySilverkitten, 2021-07-28:
Connected my Octopus V1.1 to my Ender 3 Pro. Using TMC2209 steppers in standalone mode.

Steppers aren't moving when given GCODE commands via OctoPrint or via the connected LCD.

Seminole81, 2021-08-12:
I have similar issue. Extruder not working with TMC2209 in UART mode. X, Y, and Z are moving however, and when I swap them then the extruder WILL work, but the one it swapped with will not work.

Thread 51 (2021-08-07):

V1.1+BTT-TFT35+TMC2209  with SD card inserted into display causes TMC Drivers to fail homing

Aurawin, 2021-08-07:
If I leave the SD Card out of the display and home the printer all goes well.  If I insert an SD card into the screen and try to home the printer the TMC endstops don't get triggered.  If I remove the SD Card and reset the printer it works again.  I can reproduce the error every time I insert the card.  The TFT35 and Marlin gui can read the SD Card just fine.  I can print from the card but it fails at homing (obviously).

My current settings.

 #define SERIAL_PORT -1  // -1 default
#define BAUDRATE 250000
#define BAUD_RATE_GCODE     // Enable G-code M575 to set the baud rate
#define SERIAL_PORT_2 1 // usb-c = 1
#define BAUDRATE_2 250000   // Enable to override BAUDRATE
//#define SERIAL_PORT_3 3 // RPI
//#define BAUDRATE_3 250000   // Enable to override BAUDRATE

Configuration_adv.h

  #define SDCARD_CONNECTION LCD

Any ideas as to what's causing the Endstops to fail?

Aurawin, 2021-08-08:
Configuration_adv.h
#define SDCARD_CONNECTION ONBOARD

Did the trick.  The issue is solved.

Closed 2021-08-08.

Thread 54 (2021-08-12):

TMC2209 UART Extruder Not Working

Seminole81, 2021-08-12:
Running this board in UART mode with TMC2209 drivers. Tried every port after 1, 2, 3 and I can't get the extruder to work for the life of me. I can get it working by plugging it into a 1, 2, 3 config, but then obviously the other motor won't work.

https://drive.google.com/drive/folders/1O26abcTria1FimlkyYNgGnCBxTUHKMMT?usp=sharing

Seminole81, 2021-08-14:
[message (2).txt](https://github.com/bigtreetech/BIGTREETECH-OCTOPUS-V1.0/files/6987074/message.2.txt)
[message.txt](https://github.com/bigtreetech/BIGTREETECH-OCTOPUS-V1.0/files/6987075/message.txt)

Here's my code. Can't figure out why it's not working. I've plugged into motor 3 (port 4) and tried the others as well. Nothing.

Seminole81, 2021-08-16:
Solved. E0 does not work on (x2) board. Remade firmware with extruder set to E1 and works

jeffclay, 2021-08-18:
> Solved. E0 does not work on (x2) board. Remade firmware with extruder set to E1 and works

I'm new to this and looking at compiling for my first BTT board (Octopus v1.1). What do you mean by "(x2) board"? Thanks

Seminole81, 2021-08-18:
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

Sorry, I mean there I had 2 board where E0 did not work. Looks to be a problem as well as there's a few more I know of on Facebook not working.

Evildude42, 2021-09-03:
Can someone post the snippet on what exactly has to be changed - i.e. how do i get Marlin to skip e0? Are you changing the pin files to point e0 to e1 pins or what?

Seminole81, 2021-09-07:
Sorry, forgot to reply to this. You just need to comment #define E0_DRIVER_TYPE and then uncomment #define E1_DRIVER_TYPE and make sure you've got a driver on the E1 port. That's all I did and it worked.

FullTiltt, 2021-11-21:
Much thanks for this post saved me some hair pulling, had the exact same issue of e0 doing nothing regardless of stepper driver installed and only having swapped boards on a previously working setup, @Seminole81 my gratitude sir.

monsterjeepn, 2022-02-13:
The root cause to this problem is an assumption BTT made within the pins_OCTOPUS_V1_common.h file. If you look through all of the stepper pins, it appears that BTT assumes most users will be running dual z motors on separate drivers (specifically, analyze the "Z2_" pin assignments versus the schematic).

Thread 55 (2021-08-18):

Octo+Mks TFT+Marlin

Tompudex, 2021-08-18:

sysanoo, 2025-01-06:
Заменить в файле pins_BTT_OCTOPUS_PRO_V1_common.h
//
// LCD / Controller
//

#if IS_TFTGLCD_PANEL

  #if ENABLED(TFTGLCD_PANEL_SPI)
    #define TFTGLCD_CS               EXP2_03_PIN
  #endif

#elif HAS_DWIN_E3V2 || IS_DWIN_MARLINUI
  /**
   *        ------                 ------            ---
   *       | 1  2 |               | 1  2 |            1 |
   *       | 3  4 |            RX | 3  4 | TX       | 2 | RX
   *   ENT   5  6 | BEEP      ENT   5  6 | BEEP     | 3 | TX
   *     B | 7  8 | A           B | 7  8 | A        | 4 |
   *   GND | 9 10 | VCC       GND | 9 10 | VCC        5 |
   *        ------                 ------            ---
   *         EXP1                   DWIN             TFT
   *
   * DWIN pins are labeled as printed on DWIN PCB. GND, VCC, A, B, ENT & BEEP can be connected in the same
   * orientation as the existing plug/DWIN to EXP1. TX/RX need to be connected to the TFT port, with TX->RX, RX->TX.
   */

  CONTROLLER_WARNING("BTT_OCTOPUS_PRO_V1_common", "Ender-3 V2 display")

  #define BEEPER_PIN                 EXP1_06_PIN
  #define BTN_EN1                    EXP1_08_PIN
  #define BTN_EN2                    EXP1_07_PIN
  #define BTN_ENC                    EXP1_05_PIN

#elif HAS_WIRED_LCD

  #define BEEPER_PIN                 EXP1_01_PIN
  #define BTN_ENC                    EXP1_02_PIN

  #if ENABLED(CR10_STOCKDISPLAY)

    #define LCD_PINS_RS              EXP1_07_PIN

    #define BTN_EN1                  EXP1_03_PIN
    #define BTN_EN2                  EXP1_05_PIN

    #define LCD_PINS_EN              EXP1_08_PIN
    #define LCD_PINS_D4              EXP1_06_PIN

  #else

    #define LCD_PINS_RS              EXP1_04_PIN

    #define BTN_EN1                  EXP2_03_PIN
    #define BTN_EN2                  EXP2_05_PIN

    #define LCD_PINS_EN              EXP1_03_PIN
    #define LCD_PINS_D4              EXP1_05_PIN

    #if ENABLED(FYSETC_MINI_12864)
      #define DOGLCD_CS              EXP1_03_PIN
      #define DOGLCD_A0              EXP1_04_PIN
      //#define LCD_BACKLIGHT_PIN           -1
      #define LCD_RESET_PIN          EXP1_05_PIN  // Must be high or open for LCD to operate normally.
      #if ANY(FYSETC_MINI_12864_1_2, FYSETC_MINI_12864_2_0)
        #ifndef RGB_LED_R_PIN
          #define RGB_LED_R_PIN      EXP1_06_PIN
        #endif
        #ifndef RGB_LED_G_PIN
          #define RGB_LED_G_PIN      EXP1_07_PIN
        #endif
        #ifndef RGB_LED_B_PIN
          #define RGB_LED_B_PIN      EXP1_08_PIN
        #endif
      #elif ENABLED(FYSETC_MINI_12864_2_1)
        #define NEOPIXEL_PIN         EXP1_06_PIN
      #endif
    #endif // !FYSETC_MINI_12864

    #if IS_ULTIPANEL
      #define LCD_PINS_D5            EXP1_06_PIN
      #define LCD_PINS_D6            EXP1_07_PIN
      #define LCD_PINS_D7            EXP1_08_PIN

      #if ENABLED(REPRAP_DISCOUNT_FULL_GRAPHIC_SMART_CONTROLLER)
        #define BTN_ENC_EN           LCD_PINS_D7  // Detect the presence of the encoder
      #endif

    #endif

  #endif
#endif // HAS_WIRED_LCD

// Alter timing for graphical display
#if IS_U8GLIB_ST7920
  #define BOARD_ST7920_DELAY_1               120
  #define BOARD_ST7920_DELAY_2                80
  #define BOARD_ST7920_DELAY_3               580
#endif

#if HAS_SPI_TFT
  #define TFT_CS_PIN                 EXP1_07_PIN
  #define TFT_A0_PIN                 TFT_DC_PIN
  #define TFT_DC_PIN                 EXP1_08_PIN
  #define TFT_SCK_PIN                EXP2_02_PIN
  #define TFT_MISO_PIN               EXP2_01_PIN
  #define TFT_MOSI_PIN               EXP2_06_PIN

 // #define TOUCH_INT_PIN              EXP1_07_PIN
  #define TOUCH_MISO_PIN             EXP2_01_PIN
  #define TOUCH_MOSI_PIN             EXP2_06_PIN
  #define TOUCH_SCK_PIN              EXP2_02_PIN
  #define TOUCH_CS_PIN               EXP1_05_PIN

  #define BTN_EN1                    EXP2_03_PIN
  #define BTN_EN2                    EXP2_05_PIN
  #define BTN_ENC                    EXP1_02_PIN
#endif

#if ENABLED(MKS_TS35_V2_0)

    /**                      ------                                   ------
     *               BEEPER | 1  2 | BTN_ENC               SPI1_MISO | 1  2 | SPI1_SCK
     *     TFT_BKL / LCD_EN | 3  4 | TFT_RESET / LCD_RS      BTN_EN1 | 3  4 | SPI1_CS
     *    TOUCH_CS / LCD_D4 | 5  6   TOUCH_INT / LCD_D5      BTN_EN2 | 5  6   SPI1_MOSI
     *     SPI1_CS / LCD_D6 | 7  8 | SPI1_RS / LCD_D7       SPI1_RS  | 7  8 | RESET
     *                  GND | 9 10 | VCC                         GND | 9 10 | VCC
     *                       ------                                   ------
     *                        EXP1                                     EXP2
     */
    #define TFT_CS_PIN               EXP1_07_PIN  // SPI1_CS
    #define TFT_DC_PIN               EXP1_08_PIN  // SPI1_RS
    #define TFT_A0_PIN                TFT_DC_PIN

    #define TFT_RESET_PIN            EXP1_04_PIN

    #define LCD_BACKLIGHT_PIN        EXP1_03_PIN
    #define TFT_BACKLIGHT_PIN  LCD_BACKLIGHT_PIN

    #define TOUCH_BUTTONS_HW_SPI
    #define TOUCH_BUTTONS_HW_SPI_DEVICE        1

    #define TOUCH_CS_PIN             EXP1_05_PIN  // SPI1_NSS
    #define TOUCH_SCK_PIN            EXP2_02_PIN  // SPI1_SCK
    #define TOUCH_MISO_PIN           EXP2_01_PIN  // SPI1_MISO
    #define TOUCH_MOSI_PIN           EXP2_06_PIN  // SPI1_MOSI

    #define LCD_READ_ID                   0xD3
    #define LCD_USE_DMA_SPI

    #define TFT_BUFFER_WORDS               14400

    #ifndef TOUCH_CALIBRATION_X
      #define TOUCH_CALIBRATION_X         -17253
    #endif
    #ifndef TOUCH_CALIBRATION_Y
      #define TOUCH_CALIBRATION_Y          11579
    #endif
    #ifndef TOUCH_OFFSET_X
      #define TOUCH_OFFSET_X                 514
    #endif
    #ifndef TOUCH_OFFSET_Y
      #define TOUCH_OFFSET_Y                 -24
    #endif
    #ifndef TOUCH_ORIENTATION
      #define TOUCH_ORIENTATION TOUCH_LANDSCAPE
    #endif

  #endif

#if ENABLED(WIFISUPPORT)
  //
  // WIFI
  //

  /**
   *                      -------
   *            GND | 9  |       | 8 | 3.3V
   *  (ESP-CS) PB12 | 10 |       | 7 | PB15 (ESP-MOSI)
   *           3.3V | 11 |       | 6 | PB14 (ESP-MISO)
   * (ESP-IO0)  PD7 | 12 |       | 5 | PB13 (ESP-CLK)
   * (ESP-IO4) PD10 | 13 |       | 4 | --
   *             -- | 14 |       | 3 | PE15 (ESP-EN)
   *  (ESP-RX)  PD8 | 15 |       | 2 | --
   *  (ESP-TX)  PD9 | 16 |       | 1 | PE14 (ESP-RST)
   *                      -------
   *                       WIFI
   */
  #define ESP_WIFI_MODULE_COM                  3  // Must also set either SERIAL_PORT or SERIAL_PORT_2 to this
  #define ESP_WIFI_MODULE_BAUDRATE      BAUDRATE  // Must use same BAUDRATE as SERIAL_PORT & SERIAL_PORT_2
  #define ESP_WIFI_MODULE_RESET_PIN         PG7
  #define ESP_WIFI_MODULE_ENABLE_PIN        PG8
  #define ESP_WIFI_MODULE_GPIO0_PIN         PD7
  #define ESP_WIFI_MODULE_GPIO4_PIN         PD10
#endif

Thread 56 (2021-08-21):

Running 100W heater from Slice Mosquito Magnum +

arne182, 2021-08-21:
How many amps can the heater outputs handle?
Can I run both 50W heaters on out output or should I run them on seperate heater outputs?

ba186dp, 2021-08-22:
<!--
/* Font Definitions */
@font-face
	{font-family:"Cambria Math";
	panose-1:2 4 5 3 5 4 6 3 2 4;}
@font-face
	{font-family:Calibri;
	panose-1:2 15 5 2 2 2 4 3 2 4;}
/* Style Definitions */
p.MsoNormal, li.MsoNormal, div.MsoNormal
	{margin:0cm;
	font-size:11.0pt;
	font-family:"Calibri",sans-serif;}
a:link, span.MsoHyperlink
	{mso-style-priority:99;
	color:blue;
	text-decoration:underline;}
MsoChpDefault
	{mso-style-type:export-only;}
@page WordSection1
	{size:612.0pt 792.0pt;
	margin:70.85pt 70.85pt 70.85pt 70.85pt;}
div.WordSection1
	{page:WordSection1;}
-->On separate.................with External Mosfet............... Odoslané z aplikácie Pošta pre Windows Od: Arne SchwarckOdoslané: sobota 21. augusta 2021 16:50Komu: bigtreetech/BIGTREETECH-OCTOPUS-V1.0Kópia: SubscribedPredmet: [bigtreetech/BIGTREETECH-OCTOPUS-V1.0] Running 100W heater from Slice Mosquito Magnum + (#56) How many amps can the heater outputs handle?Can I run both 50W heaters on out output or should I run them on seperate heater outputs?—You are receiving this because you are subscribed to this thread.Reply to this email directly, view it on GitHub, or unsubscribe.Triage notifications on the go with GitHub Mobile for iOS or Android. 

		Bez virů. www.avast.com

Thread 57 (2021-08-24):

Dual Z with Dual Endstop

user-e, 2021-08-24:
Hello,
I've found no way to get this board working with dual Z driver and dual Z endstop.
The second Z driver (Z2) was recognized, but the endstop resource never be used.

My actual configuration on the board:
```
First driver slot: one TMC2209 for X motor
Second driver slot: one TMC2209 for Y motor
Third driver slot: one TMC2209 for Z1 motor
Fourth driver slot: one TMC2209 for Z2 motor
Fifth driver slot: one TMC2209 for E0 motor
```

Printer type: COREXY with two Z motor and two separated endstop

Startup and M119:
```
echo:V83 stored settings retrieved (653 bytes; crc 39905)
Testing X connection... OK
Testing Y connection... OK
Testing Z connection... OK
Testing Z2 connection... OK
Testing E connection... OK
Reporting endstop status
x_min: open
y_min: open
z_min: open
```

M43 motor and endstop section:
```
PIN: PF9         M42 P89          E0_STEP_PIN                            protected
PIN: PF10        M42 P90          E0_DIR_PIN                             protected
PIN: PF11        M42 P91          Z_STEP_PIN                             protected
PIN: PF12        M42 P92          X_DIR_PIN                              protected
PIN: PF13        M42 P93          X_STEP_PIN                             protected
PIN: PF14        M42 P94          X_ENABLE_PIN                           protected
PIN: PF15        M42 P95          Y_ENABLE_PIN                           protected
PIN: PG0         M42 P96          Y_STEP_PIN                             protected
PIN: PG1         M42 P97          Y_DIR_PIN                              protected
PIN: PG2         M42 P98          E0_ENABLE_PIN                          protected
PIN: PG3         M42 P99          Z_DIR_PIN                              protected
PIN: PG4         M42 P100         Z2_STEP_PIN                            protected
PIN: PG5         M42 P101         Z_ENABLE_PIN                           protected
PIN: PG6         M42 P102         X_MIN_PIN                              protected
.                                 X_DIAG_PIN                             protected
.                                 X_STOP_PIN                             protected
PIN: PG7         M42 P103         ESP_WIFI_MODULE_RESET_PIN              Output = 1
PIN: PG8         M42 P104         ESP_WIFI_MODULE_ENABLE_PIN             Output = 1
PIN: PG9         M42 P105         Y_MIN_PIN                              protected
.                                 Y_DIAG_PIN                             protected
.                                 Y_STOP_PIN                             protected
PIN: PG10        M42 P106         Z_MIN_PIN                              protected
.                                 Z_DIAG_PIN                             protected
.                                 Z_STOP_PIN                             protected
PIN: PG11        M42 P107         <unused/unknown>                       Input  = 1               
PIN: PG12        M42 P108         E0_DIAG_PIN                            Input  = 1
PIN: PG13        M42 P109         FIL_RUNOUT2_PIN                        Input  = 1
.                                 E1_DIAG_PIN                            Input  = 1
PIN: PG14        M42 P110         FIL_RUNOUT3_PIN                        Input  = 1
.                                 E2_DIAG_PIN                            Input  = 1
PIN: PG15        M42 P111         FIL_RUNOUT4_PIN                        Input  = 1
.                                 E3_DIAG_PIN                            Input  = 1

```

What i've do in the Configuration.h:

```
//===========================================================================
//============================== Endstop Settings ===========================
//===========================================================================

// @section homing

// Specify here all the endstop connectors that are connected to any endstop or probe.
// Almost all printers will be using one per axis. Probes will use one or more of the
// extra connectors. Leave undefined any used for non-endstop and non-probe purposes.
#define USE_XMIN_PLUG
#define USE_YMIN_PLUG
#define USE_ZMIN_PLUG
//#define USE_IMIN_PLUG
//#define USE_JMIN_PLUG
//#define USE_KMIN_PLUG
//#define USE_XMAX_PLUG
//#define USE_YMAX_PLUG
//#define USE_ZMAX_PLUG
//#define USE_IMAX_PLUG
//#define USE_JMAX_PLUG
//#define USE_KMAX_PLUG

// Enable pullup for all endstops to prevent a floating state
#define ENDSTOPPULLUPS
#if DISABLED(ENDSTOPPULLUPS)
  // Disable ENDSTOPPULLUPS to set pullups individually
  //#define ENDSTOPPULLUP_XMAX
  //#define ENDSTOPPULLUP_YMAX
  //#define ENDSTOPPULLUP_ZMAX
  //#define ENDSTOPPULLUP_IMAX
  //#define ENDSTOPPULLUP_JMAX
  //#define ENDSTOPPULLUP_KMAX
  //#define ENDSTOPPULLUP_XMIN
  //#define ENDSTOPPULLUP_YMIN
  //#define ENDSTOPPULLUP_ZMIN
  //#define ENDSTOPPULLUP_IMIN
  //#define ENDSTOPPULLUP_JMIN
  //#define ENDSTOPPULLUP_KMIN
  //#define ENDSTOPPULLUP_ZMIN_PROBE
#endif

// Enable pulldown for all endstops to prevent a floating state
//#define ENDSTOPPULLDOWNS
#if DISABLED(ENDSTOPPULLDOWNS)
  // Disable ENDSTOPPULLDOWNS to set pulldowns individually
  //#define ENDSTOPPULLDOWN_XMAX
  //#define ENDSTOPPULLDOWN_YMAX
  //#define ENDSTOPPULLDOWN_ZMAX
  //#define ENDSTOPPULLDOWN_IMAX
  //#define ENDSTOPPULLDOWN_JMAX
  //#define ENDSTOPPULLDOWN_KMAX
  //#define ENDSTOPPULLDOWN_XMIN
  //#define ENDSTOPPULLDOWN_YMIN
  //#define ENDSTOPPULLDOWN_ZMIN
  //#define ENDSTOPPULLDOWN_IMIN
  //#define ENDSTOPPULLDOWN_JMIN
  //#define ENDSTOPPULLDOWN_KMIN
  //#define ENDSTOPPULLDOWN_ZMIN_PROBE
#endif

// Mechanical endstop with COM to ground and NC to Signal uses "false" here (most common setup).
#define X_MIN_ENDSTOP_INVERTING false // Set to true to invert the logic of the endstop.
#define Y_MIN_ENDSTOP_INVERTING false // Set to true to invert the logic of the endstop.
#define Z_MIN_ENDSTOP_INVERTING true // Set to true to invert the logic of the endstop.
#define I_MIN_ENDSTOP_INVERTING false // Set to true to invert the logic of the endstop.
#define J_MIN_ENDSTOP_INVERTING false // Set to true to invert the logic of the endstop.
#define K_MIN_ENDSTOP_INVERTING false // Set to true to invert the logic of the endstop.
#define X_MAX_ENDSTOP_INVERTING false // Set to true to invert the logic of the endstop.
#define Y_MAX_ENDSTOP_INVERTING false // Set to true to invert the logic of the endstop.
#define Z_MAX_ENDSTOP_INVERTING false // Set to true to invert the logic of the endstop.
#define I_MAX_ENDSTOP_INVERTING false // Set to true to invert the logic of the endstop.
#define J_MAX_ENDSTOP_INVERTING false // Set to true to invert the logic of the endstop.
#define K_MAX_ENDSTOP_INVERTING false // Set to true to invert the logic of the endstop.
#define Z_MIN_PROBE_ENDSTOP_INVERTING false // Set to true to invert the logic of the probe.

/**
 * Stepper Drivers
 *
 * These settings allow Marlin to tune stepper driver timing and enable advanced options for
 * stepper drivers that support them. You may also override timing options in Configuration_adv.h.
 *
 * A4988 is assumed for unspecified drivers.
 *
 * Use TMC2208/TMC2208_STANDALONE for TMC2225 drivers and TMC2209/TMC2209_STANDALONE for TMC2226 drivers.
 *
 * Options: A4988, A5984, DRV8825, LV8729, L6470, L6474, POWERSTEP01,
 *          TB6560, TB6600, TMC2100,
 *          TMC2130, TMC2130_STANDALONE, TMC2160, TMC2160_STANDALONE,
 *          TMC2208, TMC2208_STANDALONE, TMC2209, TMC2209_STANDALONE,
 *          TMC26X,  TMC26X_STANDALONE,  TMC2660, TMC2660_STANDALONE,
 *          TMC5130, TMC5130_STANDALONE, TMC5160, TMC5160_STANDALONE
 * :['A4988', 'A5984', 'DRV8825', 'LV8729', 'L6470', 'L6474', 'POWERSTEP01', 'TB6560', 'TB6600', 'TMC2100', 'TMC2130', 'TMC2130_STANDALONE', 'TMC2160', 'TMC2160_STANDALONE', 'TMC2208', 'TMC2208_STANDALONE', 'TMC2209', 'TMC2209_STANDALONE', 'TMC26X', 'TMC26X_STANDALONE', 'TMC2660', 'TMC2660_STANDALONE', 'TMC5130', 'TMC5130_STANDALONE', 'TMC5160', 'TMC5160_STANDALONE']
 */
#define X_DRIVER_TYPE  TMC2209
#define Y_DRIVER_TYPE  TMC2209
#define Z_DRIVER_TYPE  TMC2209
//#define X2_DRIVER_TYPE A4988
//#define Y2_DRIVER_TYPE A4988
#define Z2_DRIVER_TYPE TMC2209
//#define Z3_DRIVER_TYPE A4988
//#define Z4_DRIVER_TYPE A4988
//#define I_DRIVER_TYPE  A4988
//#define J_DRIVER_TYPE  A4988
//#define K_DRIVER_TYPE  A4988
#define E0_DRIVER_TYPE TMC2209
//#define E1_DRIVER_TYPE TMC2209
//#define E2_DRIVER_TYPE TMC2209
//#define E3_DRIVER_TYPE TMC2209
//#define E4_DRIVER_TYPE A4988
//#define E5_DRIVER_TYPE A4988
//#define E6_DRIVER_TYPE A4988
//#define E7_DRIVER_TYPE A4988
```

And in Configuration_adv.h:

```
//
// For Z set the number of stepper drivers
//
#define NUM_Z_STEPPER_DRIVERS 2   // (1-4) Z options change based on how many

#if NUM_Z_STEPPER_DRIVERS > 1
  // Enable if Z motor direction signals are the opposite of Z1
  //#define INVERT_Z2_VS_Z_DIR
  //#define INVERT_Z3_VS_Z_DIR
  //#define INVERT_Z4_VS_Z_DIR

  #define Z_MULTI_ENDSTOPS
  #if ENABLED(Z_MULTI_ENDSTOPS)
    #define Z2_USE_ENDSTOP          _XMAX_
    #define Z2_ENDSTOP_ADJUSTMENT   0
    #if NUM_Z_STEPPER_DRIVERS >= 3
      #define Z3_USE_ENDSTOP        _YMAX_
      #define Z3_ENDSTOP_ADJUSTMENT 0
    #endif
    #if NUM_Z_STEPPER_DRIVERS >= 4
      #define Z4_USE_ENDSTOP        _ZMAX_
      #define Z4_ENDSTOP_ADJUSTMENT 0
    #endif
  #endif
#endif
```

I've also tried with:
`#define Z2_USE_ENDSTOP          PG11`

But this does not work anyway.

What the printer do:
With the G28 command, the printer move down both Z motor, do the home for X and Y, and then move up just one Z motor, that can be stopped with his endstop

ba186dp, 2021-08-25:
<!--
/* Font Definitions */
@font-face
	{font-family:"Cambria Math";
	panose-1:2 4 5 3 5 4 6 3 2 4;}
@font-face
	{font-family:Calibri;
	panose-1:2 15 5 2 2 2 4 3 2 4;}
/* Style Definitions */
p.MsoNormal, li.MsoNormal, div.MsoNormal
	{margin:0cm;
	font-size:11.0pt;
	font-family:"Calibri",sans-serif;}
a:link, span.MsoHyperlink
	{mso-style-priority:99;
	color:blue;
	text-decoration:underline;}
code
	{mso-style-priority:99;
	font-family:"Courier New";}
pre
	{mso-style-priority:99;
	mso-style-link:"Predform\00E1tovan\00E9 HTML Char";
	margin:0cm;
	font-size:10.0pt;
	font-family:"Courier New";}
span.PredformtovanHTMLChar
	{mso-style-name:"Predform\00E1tovan\00E9 HTML Char";
	mso-style-priority:99;
	mso-style-link:"Predform\00E1tovan\00E9 HTML";
	font-family:"Courier New";}
MsoChpDefault
	{mso-style-type:export-only;}
@page WordSection1
	{size:612.0pt 792.0pt;
	margin:70.85pt 70.85pt 70.85pt 70.85pt;}
div.WordSection1
	{page:WordSection1;}
-->Try looking in the section Marlin / src / pins / stm32f / pins_BTT_OCTOPUS_V1_common.hdo you have a well-defined Z2 axis: define Z2_STEP_PIN PG4 // ENGINE 3#define Z2_DIR_PIN PC1#define Z2_ENABLE_PIN PA0#ifndef Z2_CS_PIN#define Z2_CS_PIN PC7#endif Odoslané z aplikácie Pošta pre Windows Od: user-eOdoslané: utorok 24. augusta 2021 21:41Komu: bigtreetech/BIGTREETECH-OCTOPUS-V1.0Kópia: SubscribedPredmet: [bigtreetech/BIGTREETECH-OCTOPUS-V1.0] Dual Z with Dual Endstop (#57) Hello,I've found no way to get this board working with dual Z driver and dual Z endstop.The second Z driver (Z2) was recognized, but the endstop resource never be usedMy actual configuration on the board:First driver slot: one TMC2209 for X motorSecond driver slot: one TMC2209 for Y motorThird driver slot: one TMC2209 for Z1 motorFourth driver slot: one TMC2209 for Z2 motorFifth driver slot: one TMC2209 for E0 motorPrinter type: COREXY with two Z motor and two separated endstopStartup and M119:echo:V83 stored settings retrieved (653 bytes; crc 39905)Testing X connection... OKTesting Y connection... OKTesting Z connection... OKTesting Z2 connection... OKTesting E connection... OKReporting endstop statusx_min: openy_min: openz_min: openM43 motor and endstop section:PIN: PF9         M42 P89          E0_STEP_PIN                            protected PIN: PF10        M42 P90          E0_DIR_PIN                             protected PIN: PF11        M42 P91          Z_STEP_PIN                             protected PIN: PF12        M42 P92          X_DIR_PIN                              protected PIN: PF13        M42 P93          X_STEP_PIN                             protected PIN: PF14        M42 P94          X_ENABLE_PIN                           protected PIN: PF15        M42 P95          Y_ENABLE_PIN                           protected PIN: PG0         M42 P96          Y_STEP_PIN                             protected PIN: PG1         M42 P97          Y_DIR_PIN                              protected PIN: PG2         M42 P98          E0_ENABLE_PIN                          protected PIN: PG3         M42 P99          Z_DIR_PIN                              protected PIN: PG4         M42 P100         Z2_STEP_PIN                            protected PIN: PG5         M42 P101         Z_ENABLE_PIN                           protected PIN: PG6         M42 P102         X_MIN_PIN                              protected .                                 X_DIAG_PIN                             protected .                                 X_STOP_PIN                             protected PIN: PG7         M42 P103         ESP_WIFI_MODULE_RESET_PIN              Output = 1PIN: PG8         M42 P104         ESP_WIFI_MODULE_ENABLE_PIN             Output = 1PIN: PG9         M42 P105         Y_MIN_PIN                              protected .                                 Y_DIAG_PIN                             protected .                                 Y_STOP_PIN                             protected PIN: PG10        M42 P106         Z_MIN_PIN                              protected .                                 Z_DIAG_PIN                             protected .                                 Z_STOP_PIN                             protected PIN: PG11        M42 P107         <unused/unknown>                       Input  = 1                       PIN: PG12        M42 P108         E0_DIAG_PIN                            Input  = 1PIN: PG13        M42 P109         FIL_RUNOUT2_PIN                        Input  = 1.                                 E1_DIAG_PIN                            Input  = 1PIN: PG14        M42 P110         FIL_RUNOUT3_PIN                        Input  = 1.                                 E2_DIAG_PIN                            Input  = 1PIN: PG15        M42 P111         FIL_RUNOUT4_PIN                        Input  = 1.                                 E3_DIAG_PIN                            Input  = 1 What i've do in the Configuration.h://===========================================================================//============================== Endstop Settings ===========================//=========================================================================== // @section homing // Specify here all the endstop connectors that are connected to any endstop or probe.// Almost all printers will be using one per axis. Probes will use one or more of the// extra connectors. Leave undefined any used for non-endstop and non-probe purposes.#define USE_XMIN_PLUG#define USE_YMIN_PLUG#define USE_ZMIN_PLUG//#define USE_IMIN_PLUG//#define USE_JMIN_PLUG//#define USE_KMIN_PLUG//#define USE_XMAX_PLUG//#define USE_YMAX_PLUG//#define USE_ZMAX_PLUG//#define USE_IMAX_PLUG//#define USE_JMAX_PLUG//#define USE_KMAX_PLUG // Enable pullup for all endstops to prevent a floating state#define ENDSTOPPULLUPS#if DISABLED(ENDSTOPPULLUPS)  // Disable ENDSTOPPULLUPS to set pullups individually  //#define ENDSTOPPULLUP_XMAX  //#define ENDSTOPPULLUP_YMAX  //#define ENDSTOPPULLUP_ZMAX  //#define ENDSTOPPULLUP_IMAX  //#define ENDSTOPPULLUP_JMAX  //#define ENDSTOPPULLUP_KMAX  //#define ENDSTOPPULLUP_XMIN  //#define ENDSTOPPULLUP_YMIN  //#define ENDSTOPPULLUP_ZMIN  //#define ENDSTOPPULLUP_IMIN  //#define ENDSTOPPULLUP_JMIN  //#define ENDSTOPPULLUP_KMIN  //#define ENDSTOPPULLUP_ZMIN_PROBE#endif // Enable pulldown for all endstops to prevent a floating state//#define ENDSTOPPULLDOWNS#if DISABLED(ENDSTOPPULLDOWNS)  // Disable ENDSTOPPULLDOWNS to set pulldowns individually  //#define ENDSTOPPULLDOWN_XMAX  //#define ENDSTOPPULLDOWN_YMAX  //#define ENDSTOPPULLDOWN_ZMAX  //#define ENDSTOPPULLDOWN_IMAX  //#define ENDSTOPPULLDOWN_JMAX  //#define ENDSTOPPULLDOWN_KMAX  //#define ENDSTOPPULLDOWN_XMIN  //#define ENDSTOPPULLDOWN_YMIN  //#define ENDSTOPPULLDOWN_ZMIN  //#define ENDSTOPPULLDOWN_IMIN  //#define ENDSTOPPULLDOWN_JMIN  //#define ENDSTOPPULLDOWN_KMIN  //#define ENDSTOPPULLDOWN_ZMIN_PROBE#endif // Mechanical endstop with COM to ground and NC to Signal uses "false" here (most common setup).#define X_MIN_ENDSTOP_INVERTING false // Set to true to invert the logic of the endstop.#define Y_MIN_ENDSTOP_INVERTING false // Set to true to invert the logic of the endstop.#define Z_MIN_ENDSTOP_INVERTING true // Set to true to invert the logic of the endstop.#define I_MIN_ENDSTOP_INVERTING false // Set to true to invert the logic of the endstop.#define J_MIN_ENDSTOP_INVERTING false // Set to true to invert the logic of the endstop.#define K_MIN_ENDSTOP_INVERTING false // Set to true to invert the logic of the endstop.#define X_MAX_ENDSTOP_INVERTING false // Set to true to invert the logic of the endstop.#define Y_MAX_ENDSTOP_INVERTING false // Set to true to invert the logic of the endstop.#define Z_MAX_ENDSTOP_INVERTING false // Set to true to invert the logic of the endstop.#define I_MAX_ENDSTOP_INVERTING false // Set to true to invert the logic of the endstop.#define J_MAX_ENDSTOP_INVERTING false // Set to true to invert the logic of the endstop.#define K_MAX_ENDSTOP_INVERTING false // Set to true to invert the logic of the endstop.#define Z_MIN_PROBE_ENDSTOP_INVERTING false // Set to true to invert the logic of the probe. /** * Stepper Drivers * * These settings allow Marlin to tune stepper driver timing and enable advanced options for * stepper drivers that support them. You may also override timing options in Configuration_adv.h. * * A4988 is assumed for unspecified drivers. * * Use TMC2208/TMC2208_STANDALONE for TMC2225 drivers and TMC2209/TMC2209_STANDALONE for TMC2226 drivers. * * Options: A4988, A5984, DRV8825, LV8729, L6470, L6474, POWERSTEP01, *          TB6560, TB6600, TMC2100, *          TMC2130, TMC2130_STANDALONE, TMC2160, TMC2160_STANDALONE, *          TMC2208, TMC2208_STANDALONE, TMC2209, TMC2209_STANDALONE, *          TMC26X,  TMC26X_STANDALONE,  TMC2660, TMC2660_STANDALONE, *          TMC5130, TMC5130_STANDALONE, TMC5160, TMC5160_STANDALONE * :['A4988', 'A5984', 'DRV8825', 'LV8729', 'L6470', 'L6474', 'POWERSTEP01', 'TB6560', 'TB6600', 'TMC2100', 'TMC2130', 'TMC2130_STANDALONE', 'TMC2160', 'TMC2160_STANDALONE', 'TMC2208', 'TMC2208_STANDALONE', 'TMC2209', 'TMC2209_STANDALONE', 'TMC26X', 'TMC26X_STANDALONE', 'TMC2660', 'TMC2660_STANDALONE', 'TMC5130', 'TMC5130_STANDALONE', 'TMC5160', 'TMC5160_STANDALONE'] */#define X_DRIVER_TYPE  TMC2209#define Y_DRIVER_TYPE  TMC2209#define Z_DRIVER_TYPE  TMC2209//#define X2_DRIVER_TYPE A4988//#define Y2_DRIVER_TYPE A4988#define Z2_DRIVER_TYPE TMC2209//#define Z3_DRIVER_TYPE A4988//#define Z4_DRIVER_TYPE A4988//#define I_DRIVER_TYPE  A4988//#define J_DRIVER_TYPE  A4988//#define K_DRIVER_TYPE  A4988#define E0_DRIVER_TYPE TMC2209//#define E1_DRIVER_TYPE TMC2209//#define E2_DRIVER_TYPE TMC2209//#define E3_DRIVER_TYPE TMC2209//#define E4_DRIVER_TYPE A4988//#define E5_DRIVER_TYPE A4988//#define E6_DRIVER_TYPE A4988//#define E7_DRIVER_TYPE A4988And in Configuration_adv.h://// For Z set the number of stepper drivers//#define NUM_Z_STEPPER_DRIVERS 2   // (1-4) Z options change based on how many #if NUM_Z_STEPPER_DRIVERS > 1  // Enable if Z motor direction signals are the opposite of Z1  //#define INVERT_Z2_VS_Z_DIR  //#define INVERT_Z3_VS_Z_DIR  //#define INVERT_Z4_VS_Z_DIR   #define Z_MULTI_ENDSTOPS  #if ENABLED(Z_MULTI_ENDSTOPS)    #define Z2_USE_ENDSTOP          _XMAX_    #define Z2_ENDSTOP_ADJUSTMENT   0    #if NUM_Z_STEPPER_DRIVERS >= 3      #define Z3_USE_ENDSTOP        _YMAX_      #define Z3_ENDSTOP_ADJUSTMENT 0    #endif    #if NUM_Z_STEPPER_DRIVERS >= 4      #define Z4_USE_ENDSTOP        _ZMAX_      #define Z4_ENDSTOP_ADJUSTMENT 0    #endif  #endif#endifI've also tried with:#define Z2_USE_ENDSTOP PG11But this does not work anyway.What the printer do:With the G28 command, the printer move down both Z motor, do the home for X and Y, and then move up just one Z motor, that can be stopped with his endstop—You are receiving this because you are subscribed to this thread.Reply to this email directly, view it on GitHub, or unsubscribe.Triage notifications on the go with GitHub Mobile for iOS or Android. 

		Bez virů. www.avast.com

user-e, 2021-08-25:
Thanks @ba186dp,
your comment cleaned:

```
Try looking in the section Marlin / src / pins / stm32f / pins_BTT_OCTOPUS_V1_common.h
do you have a well-defined Z2 axis:
#define Z2_STEP_PIN PG4 // ENGINE 3
#define Z2_DIR_PIN PC1
#define Z2_ENABLE_PIN PA0
#ifndef Z2_CS_PIN
#define Z2_CS_PIN PC7
#endif
```

Yes, in the "Marlin/src/pins/**stm32f4**/pins_BTT_OCTOPUS_V1_common.h" i got:

```
//
// Steppers
//

#define Z2_STEP_PIN                         PG4   // MOTOR 3
#define Z2_DIR_PIN                          PC1
#define Z2_ENABLE_PIN                       PA0
#ifndef Z2_CS_PIN
  #define Z2_CS_PIN                         PC7
#endif

[...]

//
// Trinamic Stallguard pins
//
#define X_DIAG_PIN                          PG6   // X-STOP
#define Y_DIAG_PIN                          PG9   // Y-STOP
#define Z_DIAG_PIN                          PG10  // Z-STOP
#define Z2_DIAG_PIN                         PG11  // Z2-STOP
#define E0_DIAG_PIN                         PG12  // E0DET
#define E1_DIAG_PIN                         PG13  // E1DET
#define E2_DIAG_PIN                         PG14  // E2DET
#define E3_DIAG_PIN                         PG15  // E3DET

```

In fact the endstop are physically connected to PG11, but it never recognize it

ba186dp, 2021-08-25:
<!--
/* Font Definitions */
@font-face
	{font-family:"Cambria Math";
	panose-1:2 4 5 3 5 4 6 3 2 4;}
@font-face
	{font-family:Calibri;
	panose-1:2 15 5 2 2 2 4 3 2 4;}
/* Style Definitions */
p.MsoNormal, li.MsoNormal, div.MsoNormal
	{margin:0cm;
	font-size:11.0pt;
	font-family:"Calibri",sans-serif;}
a:link, span.MsoHyperlink
	{mso-style-priority:99;
	color:blue;
	text-decoration:underline;}
code
	{mso-style-priority:99;
	font-family:"Courier New";}
pre
	{mso-style-priority:99;
	mso-style-link:"Predform\00E1tovan\00E9 HTML Char";
	margin:0cm;
	font-size:10.0pt;
	font-family:"Courier New";}
span.PredformtovanHTMLChar
	{mso-style-name:"Predform\00E1tovan\00E9 HTML Char";
	mso-style-priority:99;
	mso-style-link:"Predform\00E1tovan\00E9 HTML";
	font-family:"Courier New";}
MsoChpDefault
	{mso-style-type:export-only;}
@page WordSection1
	{size:612.0pt 792.0pt;
	margin:70.85pt 70.85pt 70.85pt 70.85pt;}
div.WordSection1
	{page:WordSection1;}
-->Well, I don't have physical, end stops, I'm going without them, so I have software, I'm going sensor lees. you have to play with it. And do you have the limit switch in the connector that belongs to the given stepper connected correctly? Check the connection with the PIN table again.OK let me know. Odoslané z aplikácie Pošta pre Windows Od: user-eOdoslané: streda 25. augusta 2021 9:21Komu: bigtreetech/BIGTREETECH-OCTOPUS-V1.0Kópia: ba186dp; MentionPredmet: Re: [bigtreetech/BIGTREETECH-OCTOPUS-V1.0] Dual Z with Dual Endstop (#57) Thanks @ba186dp,your comment cleaned:Try looking in the section Marlin / src / pins / stm32f / pins_BTT_OCTOPUS_V1_common.hdo you have a well-defined Z2 axis: #define Z2_STEP_PIN PG4 // ENGINE 3#define Z2_DIR_PIN PC1#define Z2_ENABLE_PIN PA0#ifndef Z2_CS_PIN#define Z2_CS_PIN PC7#endif Yes, in the "Marlin/src/pins/stm32f4/pins_BTT_OCTOPUS_V1_common.h" i got://// Steppers// #define Z2_STEP_PIN                         PG4   // MOTOR 3#define Z2_DIR_PIN                          PC1#define Z2_ENABLE_PIN                       PA0#ifndef Z2_CS_PIN  #define Z2_CS_PIN                         PC7#endif  [...]  //// Trinamic Stallguard pins//#define X_DIAG_PIN                          PG6   // X-STOP#define Y_DIAG_PIN                          PG9   // Y-STOP#define Z_DIAG_PIN                          PG10  // Z-STOP#define Z2_DIAG_PIN                         PG11  // Z2-STOP#define E0_DIAG_PIN                         PG12  // E0DET#define E1_DIAG_PIN                         PG13  // E1DET#define E2_DIAG_PIN                         PG14  // E2DET#define E3_DIAG_PIN                         PG15  // E3DET In fact the endstop are physically connected to PG11, but it never recognize it—You are receiving this because you were mentioned.Reply to this email directly, view it on GitHub, or unsubscribe.Triage notifications on the go with GitHub Mobile for iOS or Android. 

		Bez virů. www.avast.com

Voodoobrew101, 2021-10-02:
uncomment INVERT_Z2_VS_Z_DIR in Configuration_adv.h

```
//
// For Z set the number of stepper drivers
//
#define NUM_Z_STEPPER_DRIVERS 2   // (1-4) Z options change based on how many

#if NUM_Z_STEPPER_DRIVERS > 1
  // Enable if Z motor direction signals are the opposite of Z1
  //#define INVERT_Z2_VS_Z_DIR
  //#define INVERT_Z3_VS_Z_DIR
  //#define INVERT_Z4_VS_Z_DIR

  #define Z_MULTI_ENDSTOPS
  #if ENABLED(Z_MULTI_ENDSTOPS)
    #define Z2_USE_ENDSTOP          _ZMAX_
    #define Z2_ENDSTOP_ADJUSTMENT   0
    #if NUM_Z_STEPPER_DRIVERS >= 3
      #define Z3_USE_ENDSTOP        _YMAX_
      #define Z3_ENDSTOP_ADJUSTMENT 0
    #endif
    #if NUM_Z_STEPPER_DRIVERS >= 4
      #define Z4_USE_ENDSTOP        _ZMAX_
      #define Z4_ENDSTOP_ADJUSTMENT 0
    #endif
  #endif
#endif
```

Arnie3d, 2023-01-17:
i have same problems nothing seems to work z1 and z2 are parallel ( inner connected) it works without a second driver in z2 but can not change direction no z2 i have noticed that TMC2209 drivers do not work there is something wrong with this board  if i want to have z2 or y2 i define it but doesnt find the driver its a crap board only for klipper no  documents how to use marlin i,j--v.w crap doesnt work with tmc2209 someone started to mes up version 2.0.9.3 ---2.1.2 with removing num z steppers in config adv setting spend hours with this bug version drank too much coffee  blodd shot eyes maybe you can give me hope

Thread 59 (2021-08-26):

Problem with BIGTREETECH Relay V1.2

alxxxx, 2021-08-26:
There is a problem with the BIGTREETECH Relay V1.2.
After turning on the printer, it takes 10 seconds and it turns off.
I checked the signal on PS_ON_PIN and it is because of it that the power is turned off. After turning on the printer, after 10 seconds, the signal disappears on it.
If you exclude the relay and apply power directly, the printer works fine.

Marlin version: 2.0.9.1

```
#define PSU_CONTROL
#define PSU_NAME "Power Supply"

#if ENABLED(PSU_CONTROL)
  #define PSU_ACTIVE_STATE HIGH      // Set 'LOW' for ATX, 'HIGH' for X-Box

  //#define PSU_DEFAULT_OFF         // Keep power off until enabled directly with M80
  //#define PSU_POWERUP_DELAY 250   // (ms) Delay for the PSU to warm up to full power

  //#define PSU_POWERUP_GCODE  "M355 S1"  // G-code to run after power-on (e.g., case light on)
  //#define PSU_POWEROFF_GCODE "M355 S0"  // G-code to run before power-off (e.g., case light off)

  //#define AUTO_POWER_CONTROL      // Enable automatic control of the PS_ON pin
  #if ENABLED(AUTO_POWER_CONTROL)
    #define AUTO_POWER_FANS         // Turn on PSU if fans need power
    #define AUTO_POWER_E_FANS
    #define AUTO_POWER_CONTROLLERFAN
    #define AUTO_POWER_CHAMBER_FAN
    #define AUTO_POWER_COOLER_FAN
    #define AUTO_POWER_E_TEMP        50 // (°C) Turn on PSU if any extruder is over this temperature
    //#define AUTO_POWER_CHAMBER_TEMP  30 // (°C) Turn on PSU if the chamber is over this temperature
    //#define AUTO_POWER_COOLER_TEMP   26 // (°C) Turn on PSU if the cooler is over this temperature
    #define POWER_TIMEOUT              1200 // (s) Turn off power if the machine is idle for this duration
    #define POWER_OFF_DELAY          300 // (s) Delay of poweroff after M81 command. Useful to let fans run for extra time.
  #endif
#endif
```

alxxxx, 2021-09-01:
So the problem turned out to be a defective relay.
I have another printer with the same relay, I removed the relay from it and connected it to a new printer.
Everything works fine.

alxxxx, 2021-09-01:
It's a pity that BTT has such shitty support, 6 days have passed and no one has answered (

Closed 2021-09-01.

Thread 60 (2021-08-29):

bonjour je recherche les drivers pour connecté ma carte a mon pc svp merci

Kongozion, 2021-08-29:
bonjour je recherche les drivers
BIGTREETECH-OCTOPUS-V1.1 pour connecté ma carte mère a mon pc svp merci

NeoMod, 2021-10-01:
sur Windows et Linux, vous ne devriez pas avoir besoin de pilotes spéciaux.
Cependant, la carte n'est détectée que comme PORT SERIE COM pour le contrôle de l'impression (par exemple avec pronterface).
La microSD n'est pas exposée correctement, je soupçonne qu'il s'agit d'un problème de bootloader. Tu vois #74

Remarque : Postez automatiquement traduit par Google Traduction. Je m'excuse pour les erreurs.

Thread 62 (2021-09-07):

error

fiorettone, 2021-09-07:
hello i have a error for compile firmware on octopus with marlin and software visual studio the error is:
"TFT_CS_PIN was not declared in this scope;did you mean TFT_SPI?"

NeoMod, 2021-10-01:
sur Windows et Linux, vous ne devriez pas avoir besoin de pilotes spéciaux.
Cependant, la carte n'est détectée que comme PORT SERIE COM pour le contrôle de l'impression (par exemple avec pronterface).
La microSD n'est pas exposée correctement, je soupçonne qu'il s'agit d'un problème de bootloader. Tu vois #74

Remarque : Postez automatiquement traduit par Google Traduction. Je m'excuse pour les erreurs.

fiorettone, 2021-10-04:
hello i have buy btt esp07s module with octopus board but dont work ! is probably to programmer? or is ready to use? if yes can you give how must configure on octopus board?Il 1 ott 2021 13:11, NeoMod ***@***.***> ha scritto:

sur Windows et Linux, vous ne devriez pas avoir besoin de pilotes spéciaux.

Cependant, la carte n'est détectée que comme PORT SERIE COM pour le contrôle de l'impression (par exemple avec pronterface).

La microSD n'est pas exposée correctement, je soupçonne qu'il s'agit d'un problème de bootloader. Tu vois #74

Remarque : Postez automatiquement traduit par Google Traduction. Je m'excuse pour les erreurs.

—You are receiving this because you authored the thread.Reply to this email directly, view it on GitHub, or unsubscribe.Triage notifications on the go with GitHub Mobile for iOS or Android.

Thread 64 (2021-09-11):

Inductor Probe now working for either SENSOR or with Diode setup

msteele999, 2021-09-11:
I have a BTT Octopus I'm putting into my V2.4 - I have completed all my testing up to the Inductive Probe tests. I am not able to get the probe to work - it is perpetually open or closed, depending on the pin setting in printer.cfg - I have replace the probe and am having the exact same issue.

First attempts were with a PL-05N2 NPN NC probe. I tried wiring it direct to the SENSOR Port (Black=SIG, Blue=GND, Brown=+V). I then added a pull-up 4.7K ohm resistor across SIG and +V. The LED would illuminate but the probe would not trigger. I then wired it as +V and GND on SENSOR, and SIG on pin PG15, DIAG7 with BAT85 diode in circuit, band facing the PROBE - the LED would not illuminate at all and the probe would not trigger.

I then got a PL-05N NPN NO probe.  I repeated all the steps above, however this time, even when wired to SENSOR, the LED never illuminated and all my tests were negative.

I have measured the voltage across +V and GND at the board and it is +23.3 VDC. I have measured the voltage across +V and GND at the probe connections and it is also +23.3 VDC.

I don't know where to go from here - is there a different type of probe I should try or some other wiring I need to use? Is it possible the SENSOR port is bad somehow?

Oh - just a note - when running with the diode, I changed the pin: PG15, when running SIG on the Sensor, I changed the pin: ~PB7 in printer.cfg

To recap: no LED light on probe now (I did at first, now nothing), 23.3 VDC across the SENSOR port on Octopus 1.1, tested both diode to PG15 and a 4.7K resistor across the octocoupler - no joy.

msteele999, 2021-09-11:
One other note (not sure if it means anything):

- when I measure the voltage of +V and GND with the probe out of circuit, I measure 23.3VDC. When I put the probe in circuit, voltage across +V and GND drops to 1.1VDC - regardless if there is metal in front of the probe or not.

msteele999, 2021-09-11:
Additional information:

When I connect the probe +V and GND directly to the Meanwell PSU, the LED illuminates and the probe triggers in proximity to metal.

When plugged into the SENSOR pins it does not.

I have measured the voltage across +V and GND on the SENSOR pins and it is +23.3VDC

It's acting like there is some circuitry at the SENSOR pins that is not working

msteele999, 2021-09-11:
OK - my tests:

- Probe wired directly to +V and GND on PSU
- SIG wired to pin PG15 of DIAG7 block , J34
- printer.cfg pin changed to ^PG15

Probe works!

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

Using SENSOR port in any configuration results in NO LED, NO probe state change.

Please advise.

msteele999, 2021-09-11:
One last note (hopefully) - I have been able to successfully run it on a fan port as well

3Dgraf64, 2021-10-29:
If your probe is connected to J40 you have to select the proper voltage with the jumper J38.

rmilyard, 2021-11-26:
I am having this issue.  I have my probe J38 jumper for 24v.  I have sensor on PB7 pin but always shows OPEN.

thaers3d, 2021-12-12:
i have the same problem ,
when i disconnect the signal wire from the board the sensor work normal but when i connect again it will not work.
please any body have solution for this problem?

deece, 2021-12-15:
I also have the same problem, V+ drops to 5V when the probe is connected, 24V when it's not. Moving the 24V line to one of the fan headers fixes the problem.

jpyflight, 2021-12-19:
Hi all, was experiencing same issues with PL-05N. I am using the Hartk 4.0 PCB, so V+ and ground are routed somewhere else already. Diode is soldered on at the tool head. Signal pin was connected to J40, pin PB7; no results. Lights on, metal close to the sensor triggers it physically, but nothing on mainsail.  2nd try, signal pin was connected to J33, pin PG11; again same results, physically works but nothing on mainsail. 3rd and successful configuration, signal pin connected to J34, pin PG15. Light stays on when open, shuts off when triggered. Works and shows in mainsail.

## For the spare endstop port; use this with the Fotek PL-05N (or generic) inductive probe
pin: ^PG15

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

martynov-ss, 2022-09-14:
Simply connect the sensor to the J40 connector normally, and move the signal wire from the sensor to the PB7 of the J43 connector (bltouch). It works.

tweakstar, 2022-10-18:
> Simply connect the sensor to the J40 connector normally, and move the signal wire from the sensor to the PB7 of the J43 connector (bltouch). It works.

do you need a pull up resistor for this connection method?

erycstrife, 2023-01-10:
Hi did that work?

Thread 65 (2021-09-12):

EXTRUDER E0

fiorettone, 2021-09-12:
Hello i have a big broblem dont work motor extruder mounted on the motor3 pin do you know if thereis a setting on marlin (i have set 1 extruder ,prevent cold extrusion 170) to change for turn on extruder? thank you

1979mgb, 2021-09-26:
I'm no expert but: Looking in Marlin at Marlin-bugfix-2.0.x\Marlin-bugfix-2.0.x\Marlin\src\pins\stm32f4\pins_BTT_OCTOPUS_V1_common.h
According to the pins list E0 should be Motor 4.
Hope this helps.

NeoMod, 2021-10-01:
I can confirm: **MOTOR_4 is defined as EXTRUDER_0.**

Thread 66 (2021-09-16):

Problems with Thermistor Outputs

MtPegasus, 2021-09-16:
Hello, I use an octopus with 104nt-4 thermistor for hotend. The heater is off and the temperature is going up and down around 130 to 150°C. I also tried an other port and an 104GT-2 Thermistor direct to the port. It's always the same problem. The Board is new. I just put the Klipperfirmware for voron on it. Everything else works very well.

Closed 2021-09-17.

Thread 67 (2021-09-18):

Under-Voltage Detected

Lino77, 2021-09-18:
I connected my pi via USART2 as in the instructions, but the pi is only supplied with 4.9 V, so I always get the Under-Voltage Detected message, can it be remedied somehow, or is my board broken

peter-neu, 2021-09-21:
Check the voltage with unconnected pi, if the voltage is fine then your cables are too thin.

Printhing3d, 2022-01-18:
Change your wires ! too small diameter.

Thread 68 (2021-09-20):

Connecting Raspberry Pi 4B directly to Octopus v1.1 J26 pins

amv101, 2021-09-20:
I want to connect the Raspberry Pi to the Octopus board via USB for the data, but I wanted to use the 5V output pins (J26) on the Octopus board to run power to the Pi.

My question is, can the Octopus board handle the needed 2.5A current to run the Pi? There are two 5V outputs on the J26 connecter, and 6 grounds. Both 5V seem to be on the same trace, so could I just connect to a single 5V pin and one to the ground? I dont want to run data through the J26, just use the power.

There really isnt much info on connecting the Pi to these connections. Maybe someone has a writeup somewhere?

peter-neu, 2021-09-21:
From the documentation the board can handle this: 12V (4A), 5V (8A) and 3.3V (1A)
So yes, you can connect the raspberry there, just connect it, when the diameter of your cable is too small you need to connect two wires.

Closed 2021-09-27.

Thread 69 (2021-09-22):

Component damage.

sta0003, 2021-09-22:
I have a Octopus V1.1 which let out smoke and now heaters are shorted on.
is there a circuit schematic or part number for this component to replace?

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

one of the pins where shorted during assembly any help would be appreciated -thank you

sta0003, 2021-09-22:
the closest i have been able to find visually is
SN74LVC1G125DBVR SOT - 23-5 single bus tri-state output buffer brake

Thread 70 (2021-09-25):

MKS_MINI_12864 not configured in pins_BTT_OCTOPUS_V1_common.h

Gleb1982, 2021-09-25:
This leads to compiling error.

NeoMod, 2021-09-29:
+1 this issue renders unusable the  12864A/B LCD

Gleb1982, 2021-09-29:
I solved the problem by adding

```
 #elif ENABLED(MKS_MINI_12864)

    #define DOGLCD_A0                EXP1_04_PIN
    #define DOGLCD_CS                EXP1_05_PIN
    #define BTN_EN1                  EXP2_08_PIN
    #define BTN_EN2                  EXP2_06_PIN
```

And rotating EXP1 and EXP2 180 degree (I just cut the key on one side of both wires).

DrakulaRS, 2021-09-30:
Где это прописать? подскажите!

NeoMod, 2021-10-01:
@Gleb1982 thanks for the quick tip. It's working, but I hate having to meddle with PINS definition just because devs are not paying attention. I guess this will be another "shelf purchase".

@DrakulaRS locate the file `pins_BTT_OCTOPUS_V1_common-h` in `Marlin/scr/pins/stm32f4` ad and proceed adding the section mentioned early.  Look around line 444 for the right spot to insert those new lines.

Also, reading the PINS is useful to learn about the "peculiar" - to say the least - way the assigned names and positions: it will come in handy when compiling your own firmware since you can't freely define assignments based on "PIN ID" inside configuration.

NeoMod, 2021-10-01:
I've made a pull request with the quick fix integrated. #75

Thread 73 (2021-09-29):

BLTouch not working on Octopus V1.1

To0wnn, 2021-09-29:
Hi,

Trying to get my Ender 5 Plus to work with the octopus V1.1 with marlin_bugfix (from marlin site)
But somehow the BLtouch is not working.
When startup the pin comes out and retracts again.
But when I try to manually deploy the pin through the screen it is not working. (When homing it is also not working).
Wiring is correct and also tried with a different BLtouch also not working, looked also for the wiring in the manual.
BLtouch is working with a different board(SKR PRO V1.1).
Also tried to connect to the Z_MIN_ENDSTOP_PIN (PG10) not working (with the changes is the marlin code).
Any suggestions?

Wiring (other BLTouch also not working)
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
The BLTouch interface is present in the screen but I can not control the normal pop-up and retraction of BLTouch
If I send the commands  M280 P0 S120, M280 P0 S10, M280 P0 S90 it is not working
M119 command says Z probe is open
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

See my configuration files
[Configuration.zip](https://github.com/bigtreetech/BIGTREETECH-OCTOPUS-V1.0/files/7255276/Configuration.zip)

ba186dp, 2021-09-30:
Hi,
I have the same problem with BLTOUCH, if I give it firmware that is set to basic data only, BLTOUCH goes as I suddenly compile what I need for my machine (dual X, dual Z, dual extruder, stealt shop and other necessary things), BL TOUCH doesn't work for the world either, I've already tried almost everything I could think of. The connection to the Z_MIN slot (firmware change) does not work, yes in the original BLTOUCH slot from the manufacturer. I am clueless and frustrated with what is happening with this board or firmware. Please advise.

iworld4us, 2021-09-30:
Try my version:
https://github.com/iworld4us/RepRapFirmware-OCTOPUS-V1.1

ba186dp, 2021-09-30:
Thanks, but the RepRAP firmware is a big unknown to me, but I'll probably have to start getting to know each other, because MARLIN is one big mess. THANK YOU

NeoMod, 2021-10-01:
That's strange: on my v1.1 the BLTouch is working as expected. Have you tried enabling the `#define EDITABLE_SERVO_ANGLES` ?

ba186dp, 2021-10-01:
YES I tried, it doesn't work, after the reset it flashes blue, when trying to level it it only lights up red. I don't know what's wrong with that. If it works for you, what you set in Marlin, and where you have it involved, I'm in the original slot on BL TOUCH, no Z_MIN.

NeoMod, 2021-10-01:
I'm connected to the same port _(the dedicated one, let's call by name J43  so anyone reading can't be confused)_ the only difference I could think of, with your config, is that I don't have a TFT connected to the board, so the adjacent port J70 is empty.

Nothing peculiar in my config either, just the classic:

`#define BLTOUCH`

`#define BLTOUCH_SET_5V_MODE`

I'm not specifying a `BLTOUCH_DELAY` since the board treats the J43 port as the sole `SERVO_PORT` so the delay should be applied from the `#define SERVO_DELAY` line in _Configuration.h_.

_(In the official documentation the servo delay is set to 300, you might want to try with this value removing the dedicated BLTOUCH_DELAY.)_

One thing that gives me some thoughts is the behaviour you described: in my experience, that pattern of LED behaviour indicates a missing and/or irregular signal/ground connection.

I can imagine you've already tried it, but did you check that little JST-like connector on the back of the BLTouch? It has a very brittle retention system and I've seen it - on some units - getting loose on one end, leaving the connector a few millimetres out of the socket.

Also - that's the OCD in me speaking - have you considered re-making the terminal plug with a proper JST plug? I have terrible experiences when it comes to dupoint connectors, especially those of 3rd party origin.

Although since the same BLTouch is working with another board, these two suggestions might well be automatically excluded.

On the other hand, have you tried providing the board with an external power supply? (12V or 24V) Just as a "last chance" scenario.

ba186dp, 2021-10-01:
The power supply is 24 V 500 w, I have another BLTOUCH, which is not firmly connected to the printer and the connecting wires do not go through the JST connector, but are firmly soldered to BL TOUCH, I will try BLTOUCH 5V. I'll see I'll try.
Marlin latest clean version, compiled once.
I can attach both config files, and if I can ask, check them out for me, because I'm already crazy about it. Thank you in advance
[Configuration_advh.txt](https://github.com/bigtreetech/BIGTREETECH-OCTOPUS-V1.0/files/7267833/Configuration_advh.txt)
[Configurationh.txt](https://github.com/bigtreetech/BIGTREETECH-OCTOPUS-V1.0/files/7267834/Configurationh.txt)
.

To0wnn, 2021-10-01:
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

Nope not working for me as wel.
Increased `BLTOUCH_DELAY` to 600 also tried with `SERVO_DELAY` to 600 still not responding
But is doing something additional during startup
The LED is steady red not blinking

> Try my version: https://github.com/iworld4us/RepRapFirmware-OCTOPUS-V1.1

Did take the compiled version from BTT
BLTouch also working and responding to the commands awsome!!!
But my TMC5160 are not working :(
Any suggestions?

[board.txt](https://github.com/bigtreetech/BIGTREETECH-OCTOPUS-V1.0/files/7267764/board.txt)
[config.g.txt](https://github.com/bigtreetech/BIGTREETECH-OCTOPUS-V1.0/files/7267772/config.g.txt)

NeoMod, 2021-10-01:
> The power supply is 24 V 500 w, I have another BLTOUCH, which is not firmly connected to the printer and the connecting wires do not go through the JST connector, but are firmly soldered to BL TOUCH, I will try BLTOUCH 5V. I'll see I'll try. Marlin latest clean version, compiled once. I can attach both config files, and if I can ask, check them out for me, because I'm already crazy about it. Thank you in advance [Configuration_advh.txt](https://github.com/bigtreetech/BIGTREETECH-OCTOPUS-V1.0/files/7267833/Configuration_advh.txt) [Configurationh.txt](https://github.com/bigtreetech/BIGTREETECH-OCTOPUS-V1.0/files/7267834/Configurationh.txt) .

I have a bit of time, I'll try and compare the files.

At quick glance, I noticed you have enabled:

`#define ENDSTOPPULLUP_ZMIN_PROBE`

I'm not using this feature with my BLTouch. Are sure about it?

ba186dp, 2021-10-01:
I'm not sure about anything anymore, I'm connecting the output from M119, the voltage is at pin 4.997 V. I'll try the Probe pullu
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
p.

NeoMod, 2021-10-01:
BTW, it seems that there is something more customized than PINS and Config in the Marlin release from BTT on this GIT _(*)_. The latest official release from Marlin won't run properly on the board and drives the BLTouch crazy.

Probably I'm missing something but I can't seep through all the files to identify the changes, so for now I would advice compiling and testing with the provided Marlin folder (_Firmware/Marlin-bugfix-2.0.x/_)

***=** (If that's the case, I really don't like it. BTT should PULL their changes into Marlin official)

To0wnn, 2021-10-01:
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

Nope same issue..
Can you maybe give your firmware.bin?
I get the idea that my vscode is doing something strange.

NeoMod, 2021-10-01:
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

Sure, here it is: [firmware.bin](https://drive.google.com/file/d/10WhOnH8JkmQ0I1lGrY4yScdeZAm9T_-i/view?usp=sharing)

It's compiled for my printer, so without LCD/TFT support (I'm still waiting on that delivery) and it uses some spare ports (J30/J32/J34) for a single RGB Led with PRINTER_EVENT_LEDS active. But for just testing the BLTouch it should be fine.

Also, I compiled yours using the two files you shared early: [firmwareTEST.bin](https://drive.google.com/file/d/1v3-Pem6rfWO9A_M733V7qTd-6ZByBtOP/view?usp=sharing) Please note that _**I haven't checked anything, I just compiled based on your Configuration and Configuration_adv files.**_

ba186dp, 2021-10-01:
Guys, you're very golden that you showed a big heart and helped me, everything works as it should, the problem is the poor quality of the BLTOUCH product, the cold connections on the PCB, I normally threw it in the recycling bin and used it from the second BLTOUCH printer, which goes 100%. Thank you and I appreciate it. There are social and professional networks for this, HELP if you can't advise.

To0wnn, 2021-10-01:
Thanks for al the help!! It was firmware related. Thank you for the bin file it really helped me! I switched in the pin config the BED and FAN2 pin because i have an external mosfet. When I comment out FAN2 en give the BED the pin of  FAN2 everything is working!!

Also my suspicion but not sure if it was the issue was but I deleted the folders ".pio" and ".vscode" from the folder where Marlin is standing. Normally I always pressed clean in VScode

NorbertRoller, 2022-03-02:
With the BTT Firmware (BIGTREETECH-OCTOPUS-V1.0-master.zip) and the changes recommended above,  I had to connect the black & white BLTouch cable to the z-endstop instead of the J43 to make it work.

Closed 2021-10-01.

Thread 74 (2021-10-01):

Brand new Octopus v1.1 - microSD detection over USB not working

NeoMod, 2021-10-01:
I'm reporting a pretty annoying bug, not seeing it explicitly mentioned in any other issue.

On a brand new motherboard, the microSD card is not made available via USB (USB-C) to the host thus forcing the user to physically take out the card every time a firmware update is needed.

Things I've tried with no success:

1. changing microSD card
2. changing USB-C cable, including the one provided in the package
3. changing USB port
4. changing host (two windows hosts shows the same problem)
5. changing host and OS: tested on Raspberry Pi 4 with Debian, microSD is not available.
6. testing with dfu-utils on Raspberry: same result, board is not available.
7. checking all the required drivers are installed: motherboard shows up correctly as a "COM PORT" and can be controlled via Pronterface. But microSD card is not available.
8. updating bootloader, as per instructions provided here

Seems definitely an issue with the motherboard, probably with the bootloader (?) since I even tried two different models of the same: one coming from Aliexpress and one from Amazon. They both behave in the very same way.

Just a few more clarifications:

- board is "vanilla" out of the box: no component added, no jumper moved, no firmware loaded
- on a second board I tried loading the provided Marlin firmware from GitHub to see if it would make a difference: no difference at all in behaviour.
-  tried with both USB Power and External Power (24V)
- tried with and without "power jumpercap" when using external power
- as far as I can tell, all other aspects of the board are working as intended. no visible components damaged nor soldering issues visible on both the boards tested.
- the microSD cards used have been formatted multiple times according to standard and they have been checked for consistency.

It's quite an annoying bug for a 50€+ board, especially considering low-end boards (8bit MCU even) are perfectly capable of this feature.
I do want to believe this is a bug and not an "intended feature"...if so I missed the explicit warning/disclosure about it.

iworld4us, 2021-10-01:
Try fat16 or fat32 or format it in Windows

NeoMod, 2021-10-01:
Thanks, but I've already made sure of it. I even used SDCardFormatter.

Thread 77 (2021-10-11):

Unable to read tmc uart 'stepper_z1' register IFCNT

Dedelkov, 2021-10-11:
I keep getting this error on Klipper, and can't figure out why.

I'm using the default .cfg file for the Voron 2.4

It only happens on the 4th driver position (the default for the Z1 motor) on the Octopus Board.

I have another six TMC2209 stepper drivers configured with uart working without issues in the same board.

matticustard, 2021-10-13:
Is it possible you skipped a driver slot and put one in the top slot instead? This can be a little confusing since you are supposed to skip a motor connection, but not a driver connection. The drivers should all be positioned side-by-side as they are in this picture.

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

chefguevara, 2021-10-31:
I have the same issue currently, same board, it started all of the sudden, it was printing just fine. Drivers are in the right positions and wires too skipping the z1-motor 2 output as intended.

The only difference with the previous time it worked is that I wired the controller fan and LCD. If it works for something when the error pops up when I send the printer to home any axis, the LCD screen goes blank and all fans goes to 100%.

My next steps will be disconnect the fan and screen and try again, I'll update if I see any change.

dspublic, 2021-12-13:
Hi,
Same proble here. When I apply [display] parameters in klipper , then I get "Unable to read tmc uart 'stepper_xxx' register IFCNT" error. But, the 12864 mini display isn't attached, only configured. So, I think it's probably a klipper issue...

@chefguevara Did you solve the problem?

dspublic, 2021-12-13:
@chefguevara Finally, I have found the mistake. I left TCM jumpers in SPI mode, instead of UART!

chefguevara, 2022-01-13:
Solve!

Ok. At first I was like "naaah I have a bag full of jumpers to remind me that I have all the drivers in the right position, that's not my case".

But it seems that you're absolutely correct @dspublic! I missed one jumper. Is hard to see the current setup with all the drivers plugged in so I only noticed the mistake after removing all of them to triple check. Interesting enough, the printer works just fine with only one driver misconfigured with all the jumpers in place. It just interferes with the screen apparently.

TommySchwartz, 2022-10-26:
I have this " Unable to read tmc uart 'stepper_a' register IFCNT" only after homing to quickly after aborting a print. Not always stepper_a, but it is the most common.

Have a delta printer, so I have stepper_a, stepper_b and stepper_c.

Otherwise the printer works great.

torwag, 2023-06-08:
Just to leave a message here for people as stupid as me:
The error message also pops up, if you haven't powered up the printers main supply, but only connected via USB for example with klipper and mainsail. Being able to "remote control" the printer, it might not be all that obvious that the printer runs out of power, trying to home.

Thread 78 (2021-10-15):

Analog Input

jasonhamilton, 2021-10-15:
I’d like to connect my E3D PT100 amplifier board to an analog input.  The documentation indicates:

Temperature sensor interfaces: TB, T0, T1, T2, T3 (With direct inputs available that bypass the protection circuit for alternate use).

How can I access the direct input? Does this disable to voltage divider?

Thanks!

c3charvat, 2021-10-31:
Pin header J47 (see schematics) it's just below the others. Is labeled pt100 and is connected to that circuit though there is no reference if it's a direct connection or not. (But by contrast there is for every other one of the sensor interface you mentioned)

jasonhamilton, 2021-11-09:
@c3charvat the pin J47 is connected to the amplifier circuit where you can solder an surface mount INA826 AIDR amplifier and not accessible via any of the headers.  I was able to get this to work but I had to tap into one of the solder pads connected directly to the controller's J47 pin.

I'll leave some additional information in case anyone else may need it.  Here is the pad that's connected to the ADC pin J47.

### J47 Pin

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
This is a 3.3V ADC, so make sure you set this in the firmware accordingly.

### Using a Thermistor Port

The other option is to use a thermistor pin but this requires some soldering work.  I've mapped out the thermistor circuit below.

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

Each thermistor has its own circuit.  Because this is a voltage divider circuit for use with thermistors you will need to remove it to get a proper reading.  In order to do this you would need to remove the 5 components below and then put a junction between the TH and THERM pins.

c3charvat, 2021-11-09:
Glad I was able to help some what!

Closed 2021-11-09.

Thread 81 (2021-10-24):

Had to double rotation distance. Is this safe?

FlatEarthDave, 2021-10-24:
For whatever reason, I can't figure out, I have to double all of my stepper motor rotation distances for X, Y, Z, and E0 in Klipper from the values that worked just before changing my board to a BTT Octopus V1.1, and are in the config file provided on Github, ie X,Y from 40 to 80, Z from 8 to 16, and E0 from 22.857 to 45.714. I made zero changes other than the board. For proof, here is the section from my config that is working perfectly:

`[stepper_x]
step_pin: PG0
dir_pin: !PG1
enable_pin: !PF15
microsteps: 16
rotation_distance: 80
endstop_pin: PG6
position_endstop: 260
position_max: 260
homing_speed: 50

[stepper_y]
step_pin: PF13
dir_pin: PF12
enable_pin: !PF14
microsteps: 16
rotation_distance: 80
endstop_pin: PG9
position_endstop: 260
position_max: 260
homing_speed: 50

[stepper_z]
step_pin: PF11
dir_pin: !PG3
enable_pin: !PG5
microsteps: 16
rotation_distance: 16
endstop_pin: PG10
position_endstop: 0.5
position_max: 400`

I don't really like that I have to remember to double those values, but I guess I can live with it, as long as it's safe to continue using this way. Is there something wrong with the drivers?

c3charvat, 2021-10-31:
It sounds like your jumpers on the octopus are set to a different mirco stepping value then you are specifying. Try 2* your Mirostepping and and retuning your code back to the old set up. See if that works ..

FlatEarthDave, 2021-11-01:
Still not sure what happened, but I changed the voltage on one fan to 12v from 24v, and the board popped and smoked. Bought another board and configured the same as the previous one, I reverted all values back to their originals and now it works. Just wish I would've bought the pro with the integrated chip for a PT100.

Thanks for your help,

Dave

Get Outlook for Android<https://aka.ms/AAb9ysg>
________________________________
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

Closed 2021-11-12.

Thread 82 (2021-11-02):

BTT Octopus V1.1 G34(Auto Z Align) Probe Failure

CVRIV, 2021-11-02:
I bought 4 of these control boards to build 4 CoreXY machines and 3 of the 4 boards work just fine. The one control board will not G34(Auto Z Align). When I send the G34 code via my BTT TFT35 V2.0, it immediately tells me probing failure and aborts the G34. All of the machines are using a BLTouch connected to the dedicated BL Touch port. Here's the thing... the BLTouch works just fine when homing and leveling the bed. All of the machines are absolutely identical, same firmware and everything. I just don't understand why this one board will not do a G34. I don't want to buy a new board if I don't have too.

Any ideas would be greatly appreciated.
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
e
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

Thread 83 (2021-11-04):

Can't compile BIGTREE_OCTOPUS_V1_USB

hololight, 2021-11-04:
I can compile BIGTREEE_OCTOPUS_V1 but not the ...USB version. I believe the first error is:

C:\Users\holol\.platformio\packages\framework-arduinoststm32@src-37335c727965154be67d1d5ed653b9c6\cores\arduino\stm32\usb\usbd_desc.c:146:23: error: redefinition of 'USBD_Class_DeviceDesc'

But prior to that, I get a ton of Warnings, which I dont get with the non-USB build. Since I thought it might be something I had done, I downloaded a fresh copy from the repo and attempted to compile... same situation... non-usb compiles fine, usb has ton of warnings, and eventually errors out.

Am I doing something wrong?

the USB version IS required to be able to connect up my Pi and use octoprint, correct?

exxosuk, 2021-11-05:
I can't get it to compile either, but the other one does (but doesn't actually work in the board)

` V:\BIGTREETECH-OCTOPUS-V1.0-master\Firmware\Marlin-bugfix-2.0.x> Environment             Status    Duration
The term 'Environment' is not recognized as the name of a cmdlet, function, script file, or operable program. Check the spelling of the n
ame, or if a path was included, verify that the path is correct and try again.
At line:1 char:12
+ Environment <<<<              Status    Duration
    + CategoryInfo          : ObjectNotFound: (Environment:String) [], CommandNotFoundException
    + FullyQualifiedErrorId : CommandNotFoundException

PS V:\BIGTREETECH-OCTOPUS-V1.0-master\Firmware\Marlin-bugfix-2.0.x> ----------------------  --------  ------------
>> BIGTREE_OCTOPUS_V1_USB  FAILED    00:00:13.993
>> ================================================= 1 failed, 0 succeeded in 00:00:13.993 =================================================
>> PS V:\BIGTREETECH-OCTOPUS-V1.0-master\Firmware\Marlin-bugfix-2.0.x>`

hololight, 2021-11-05:
Well I don't know what the deal is now.... Since I had no better options, I loaded up the first firmware build and my board seems to be working (at least its responding properly in pronterface over USB (com port)). But that tells

exxosuk, 2021-11-05:
Same here, no idea what the USB one is for. There never seems to be any proper guides explaining what all this stuff is for.  I'm still trying to work out why the other firmware compiles but doesn't work.

hololight, 2021-11-05:
I'm thinking the ...USB build target is perhaps related to the onboard USB-A port? Maybe having to do with either allowing Flash Drives, or perhaps USB-OTG... regardless, if the first build target allows the board to communicate over USB (as evidenced by Pronterface), then I would think I'm good to go with Octoprint working now. What do you mean by 'doesn't work'? I'm just wondering if despite the Pronterface responses from the board, it wont actually work once I put it in my printer and hook everything up. Do you want me to give you my config file?

exxosuk, 2021-11-05:
I opened up a new topic for my issue  https://github.com/bigtreetech/BIGTREETECH-OCTOPUS-V1.0/issues/85

I am using the files as in the repo. I would have thought it would all be setup to compile to the firmware.bin as also included. But my file ends up at 159K not 480K.

hololight, 2021-11-05:
Mine is 211K, and there were a lot of changes I had to make

hololight, 2021-11-05:
@exxosuk The firmware that got you running was mine? Do note, that my bed is 400x400mm, so thats what's coded in the firmware.

exxosuk, 2021-11-05:
It was mine. I've not set the bed area up yet. Just got homing XYZ to work which is  a big step in the right direction!

I have no idea what the USB file is for. Maybe it's not supposed to be there.. ?

hololight, 2021-11-05:
Which config file? A fresh one you made, or one based off mine? (basically i'm looking for how close I will be when I try my board out)

exxosuk, 2021-11-05:
It's the one in the default repo files. It does compile and work without changes afterall.

The only changes I have made so far are inverting the end stop switches, and changing the homing direction. But this is specific for my printer anyway.

Thread 84 (2021-11-04):

Board bricked ?

exxosuk, 2021-11-04:
I followed the instructions to flash the bootloader as included in the repo. All seem to go well and verified fine. However the board seems now bricked as I can no longer access it with pronterface. It used to show up as COM3 in device manager but nothing is there now. Unplugging the board and plugging it back in does not cause Windows to recognise the board any more.

I mistakenly thought this was how to flash Marlin, which I did first, obviously this would not work ( which I now know is actually the boot loader) . When I first connected the board I clicked download as I thought it meant download to the STM32 data to the programme, not "upload" the firmware to the board :-\ I wanted to do this because I wanted to back up the current contents before messing with anything.

So does anyone have the boot.hex file  for the 446 ?  I have been trying the OctoPus-F446-bootloader-32KB.hex board still does not function. So I have no idea where to go from here :(

exxosuk, 2021-11-04:
It seems I had corrupted Marlin firmware somehow. Putting firmware.bin onto the SD card and it flashed a LED , now windows finds the board again!

Closed 2021-11-04.

Thread 85 (2021-11-05):

Compiling works but board does not function

exxosuk, 2021-11-05:
The BG file size is 480K, but when I compile, it comes out as 159K ?? If I flash to the board and send M115..

`SENDING:M115
FIRMWARE_NAME:Marlin bugfix-2.0.x (Nov  4 2021 22:39:38) SOURCE_CODE_URL:github.com/MarlinFirmware/Marlin PROTOCOL_VERSION:1.0 MACHINE_TYPE:3D Printer EXTRUDER_COUNT:4 UUID:cede2a2f-41a2-4748-9b12-c55c62f367ff`

It has loaded the new file. But the printer is otherwise "dead". Trying to move the motors does nothing at all.

I am using VScode on windows.. is there some trick to getting it to compile or something ? Or should I be using the USB version (which doesn't compile at all) .

hololight, 2021-11-05:
The steppers aren't setup by default, you've made those changes in the config?

exxosuk, 2021-11-05:
I've not made any changes. I've no idea what I am supposed to be doing. I wish creators would just upload a "ready to compile" set of files, so we can just make the changes we need without having to mess about for endless hours trying to figure out why nothing works :(

exxosuk, 2021-11-05:
ahh so assume this is part of my problem ?

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

hololight, 2021-11-05:
good catch (I didn't have that line set like I should have), lol. I've forked the repo from BTT and in the firmware folder I've uploaded my configuration.h and configuration_adv.h. Do you know how to compare two files in VSCode? (that way you can compare my files with the defaults to see the changes I've made)

Can you see if you can talk to the board over USB (like with pronterface)?

exxosuk, 2021-11-05:
It will connect and respond to command M115 as stated in my first post. The time stamp shows it has been updated with my compiled firmware. But other than that no movement commands work.

It does however work fine if I use the firmware.bin (480K file size)  . So you would think the files in the repo would compile directly to that file size and all be set up for the octopus board.

I don't know how to file compare, but I know how to do it in winhex.

hololight, 2021-11-05:
In VSCode press <F1> to bring up the 'command window', then start typing "Compare active file with" and it'll give you like 3 options, the first should be the one you want. You need to have had both versions open in the same Code window.

Where did you find the precompiled version of the firmware? I didn't notice it in the repo.

exxosuk, 2021-11-05:
The second one down I used.

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

exxosuk, 2021-11-05:
Now putting the 480K one in doesn't work anymore :(

`Connecting...
Unable to read board configuration: 0:/sys/board.txt...
Unable to read board configuration: 0:/sys/board.txt...
Unable to read board configuration: 0:/sys/board.txt...
Unable to read board configuration: 0:/sys/board.txt...
Unable to read board configuration: 0:/sys/board.txt...
Unable to read board configuration: 0:/sys/board.txt...
Unable to read board configuration: 0:/sys/board.txt...
`

hololight, 2021-11-05:
Maybe I was confused, but the firmware you're trying to load (that worked before... that firmware.bin) is RepRap firmware, not Marlin... that's why its such a different size

exxosuk, 2021-11-05:
I've lost the plot. I even put the 480K one on the SD card folder as "OK" folder as I was sure it worked. So no idea what I actually had in the board now. I've tried both the 480K ones and neither work.

Maybe the only one which would work is the firmware-F446-USB.bin one, that's 20K.. this is just madness.

exxosuk, 2021-11-05:
That firmware does even less. Windows won't even install the driver now.

I don't suppose you have the original firmware.bin which was shipped with the board ?

hololight, 2021-11-05:
The firmware file that is in "...Octopus works on Voron v2.4\Firmware\RRF" is actually RepRapFirmware not Marlin. Its just another firmware alternative, just like Klipper.... but I dont know anything about either of those two... and I'm still at the beginning of my 'journey' with Marlin... I see no precompiled version of Marlin based firmware in the repo... And so far as I know, the board shipped blank (I never tried powering it till I put in my SD card with my compiled firmware image). I can put my firmware file up on my repo, just for you to be able to test things. I was just playing with it (still not in my machine) and its working with a BTT TFT50 touchscreen connected. It is turning a fan on and off, as well as reading from a thermistor...

exxosuk, 2021-11-05:
The board was shipped with some firmware. I hooked up the stepper motors and then stop switches which was all working. But I needed to invert the switch in the firmware as open and closed is backwards. Hence the total dilemma. Because I am converting a flash forge printer, and trying to reuse as much of the existing stuff as possible. So physically changing the switch not so simple without changing even more boards and cables. As I've been at this for almost 3 months now I thought it would just be easier to do it in firmware.

I was previously using a smoothie board where all the settings were configurable in a single file which was great. Unfortunately that board had some bizarre faults where ultimately I gave up with it and brought the BTT one. This one worked great out of the box. Only now my board is basically bricked :(

It would be appreciated if you have a firmware which could get me back up and running again least. I still need to wire up the heated bed and yet so I cannot even do that currently while puzzling over the firmware compiling problems.

hololight, 2021-11-05:
I dont know that this will work for you in any way.... I dont even know that this will move my steppers once I hook it up. I just know it at least paritally works...
https://github.com/hololight/Pre-compiled-Marlin-firmware-for-my-Octopus-v1.1-Mainboard

exxosuk, 2021-11-05:
Thanks, I tried your firmware file, and it does exactly the same as mine does :(

hololight, 2021-11-05:
Just isn't running the steppers, or no longer any response at all?

exxosuk, 2021-11-05:
I think it was just not responding to the steppers. I am trying to compile again but VScode just seems to be stuck in some loop now.

I have tried to use the Arduino compiler but that does does not work either and complains about stuff I have no idea how to fix either.

exxosuk, 2021-11-05:
So with my 159K file..

Connecting...
Printer is now online.
Using tool 0.
echo:Active Extruder: 0

>>> M115
SENDING:M115
FIRMWARE_NAME:Marlin bugfix-2.0.x (Nov  5 2021 15:40:43) SOURCE_CODE_URL:github.com/MarlinFirmware/Marlin PROTOCOL_VERSION:1.0 MACHINE_TYPE:3D Printer EXTRUDER_COUNT:4 UUID:cede2a2f-41a2-4748-9b12-c55c62f367ff
Cap:SERIAL_XON_XOFF:0
Cap:BINARY_FILE_TRANSFER:0
Cap:EEPROM:1
Cap:VOLUMETRIC:1
Cap:AUTOREPORT_POS:0
Cap:AUTOREPORT_TEMP:1
Cap:PROGRESS:0
Cap:PRINT_JOB:1
Cap:AUTOLEVEL:0
Cap:RUNOUT:0
Cap:Z_PROBE:0
Cap:LEVELING_DATA:0
Cap:BUILD_PERCENT:0
Cap:SOFTWARE_POWER:0
Cap:TOGGLE_LIGHTS:0
Cap:CASE_LIGHT_BRIGHTNESS:0
Cap:EMERGENCY_PARSER:0
Cap:HOST_ACTION_COMMANDS:0
Cap:PROMPT_SUPPORT:0
Cap:SDCARD:1
Cap:REPEAT:0
Cap:SD_WRITE:1
Cap:AUTOREPORT_SD_STATUS:0
Cap:LONG_FILENAME:0
Cap:THERMAL_PROTECTION:1
Cap:MOTION_MODES:0
Cap:ARCS:1
Cap:BABYSTEPPING:0
Cap:CHAMBER_TEMPERATURE:0
Cap:COOLER_TEMPERATURE:0
Cap:MEATPACK:0

So the stepper motors are not working. But it is still odd that the LED on the board is flashing when it was not originally.

exxosuk, 2021-11-05:
This is what I get when trying to compile the USB version.

Windows PowerShell
Copyright (C) 2009 Microsoft Corporation. All rights reserved.

PS V:\BIGTREETECH-OCTOPUS-V1.0-master\Firmware\Marlin-bugfix-2.0.x> platformio run -e BIGTREE_OCTOPUS_V1_USB
Processing BIGTREE_OCTOPUS_V1_USB (platform: ststm32@~12.1; board: marlin_BigTree_Octopus_v1; framework: arduino)
------------------------------------------------------------------------------------------------------------------------------------------------------------
Verbose mode can be enabled via `-v, --verbose` option
CONFIGURATION: https://docs.platformio.org/page/boards/ststm32/marlin_BigTree_Octopus_v1.html
PLATFORM: ST STM32 (12.1.1) > STM32F446ZE (128k RAM. 512k Flash)
HARDWARE: STM32F446ZET6 180MHz, 128KB RAM, 512KB Flash
DEBUG: Current (blackmagic) External (blackmagic, jlink, stlink)
PACKAGES:
 - framework-arduinoststm32 0.0.0
 - framework-cmsis 2.50501.200527 (5.5.1)
 - toolchain-gccarmnoneeabi 1.90201.191206 (9.2.1)
Converting Marlin.ino
LDF: Library Dependency Finder -> http://bit.ly/configure-pio-ldf
LDF Modes: Finder ~ chain, Compatibility ~ soft
Found 11 compatible libraries
Scanning dependencies...
Dependency Graph
|-- <U8glib-HAL> 0.4.5
|   |-- <Wire> 1.0
|   |-- <SPI> 1.0
|-- <SPI> 1.0
|-- <Servo> 1.1.2
|-- <EEPROM> 2.0.1
|-- <SoftwareSerial> 1.0
|-- <IWatchdog> 1.0.0
|-- <Wire> 1.0
Building in release mode
Compiling .pio\build\BIGTREE_OCTOPUS_V1_USB\FrameworkArduino\stm32\usb\usbd_desc.c.o
Compiling .pio\build\BIGTREE_OCTOPUS_V1_USB\FrameworkArduino\stm32\usb\usbd_ep_conf.c.o
Compiling .pio\build\BIGTREE_OCTOPUS_V1_USB\FrameworkArduino\stm32\usb\usbd_if.c.o
Compiling .pio\build\BIGTREE_OCTOPUS_V1_USB\FrameworkArduino\stm32\usb_host\hid\usb_host_hid.c.o
Compiling .pio\build\BIGTREE_OCTOPUS_V1_USB\FrameworkArduino\stm32\usb_host\hid\usb_host_hid_keybd.c.o
Compiling .pio\build\BIGTREE_OCTOPUS_V1_USB\FrameworkArduino\stm32\usb_host\hid\usb_host_hid_mouse.c.o
Compiling .pio\build\BIGTREE_OCTOPUS_V1_USB\FrameworkArduino\stm32\usb_host\hid\usb_host_hid_parser.c.o
Compiling .pio\build\BIGTREE_OCTOPUS_V1_USB\FrameworkArduino\stm32\usb_host\msc\usb_host_msc.c.o
C:\Users\chris\.platformio\packages\framework-arduinoststm32@src-37335c727965154be67d1d5ed653b9c6\cores\arduino\stm32\usb\usbd_desc.c:146:23: error: redefinition of 'USBD_Class_DeviceDesc'
  146 | __ALIGN_BEGIN uint8_t USBD_Class_DeviceDesc[USB_LEN_DEV_DESC] __ALIGN_END = { \
      |                       ^~~~~~~~~~~~~~~~~~~~~
C:\Users\chris\.platformio\packages\framework-arduinoststm32@src-37335c727965154be67d1d5ed653b9c6\cores\arduino\stm32\usb\usbd_desc.c:176:3: note: in expansion of macro 'USBD_CLASS_DEVICE_DESCRIPTOR'
  176 |   USBD_CLASS_DEVICE_DESCRIPTOR(USB_CDC_CLASS_MULTI, CDC_SUBCLASS_ACM, CDC_PROTOCOL_V25TER);
      |   ^~~~~~~~~~~~~~~~~~~~~~~~~~~~
C:\Users\chris\.platformio\packages\framework-arduinoststm32@src-37335c727965154be67d1d5ed653b9c6\cores\arduino\stm32\usb\usbd_desc.c:146:23: note: previous definition of 'USBD_Class_DeviceDesc' was here
  146 | __ALIGN_BEGIN uint8_t USBD_Class_DeviceDesc[USB_LEN_DEV_DESC] __ALIGN_END = { \
      |                       ^~~~~~~~~~~~~~~~~~~~~
C:\Users\chris\.platformio\packages\framework-arduinoststm32@src-37335c727965154be67d1d5ed653b9c6\cores\arduino\stm32\usb\usbd_desc.c:172:3: note: in expansion of macro 'USBD_CLASS_DEVICE_DESCRIPTOR'
  172 |   USBD_CLASS_DEVICE_DESCRIPTOR(0x02, 0x02, 0x00);
      |   ^~~~~~~~~~~~~~~~~~~~~~~~~~~~
*** [.pio\build\BIGTREE_OCTOPUS_V1_USB\FrameworkArduino\stm32\usb\usbd_desc.c.o] Error 1
In file included from C:\Users\chris\.platformio\packages\framework-arduinoststm32@src-37335c727965154be67d1d5ed653b9c6\cores\arduino\stm32\usb\usbd_ep_conf.c:20:
C:\Users\chris\.platformio\packages\framework-arduinoststm32@src-37335c727965154be67d1d5ed653b9c6\cores\arduino\stm32\usb\usbd_ep_conf.h:72: warning: "CDC_IN_EP" redefined
   72 |   #define CDC_IN_EP                     0x81U /*  EP1 for CDC data IN */
      |
C:\Users\chris\.platformio\packages\framework-arduinoststm32@src-37335c727965154be67d1d5ed653b9c6\cores\arduino\stm32\usb\usbd_ep_conf.h:43: note: this is the location of the previous definition
   43 |   #define CDC_IN_EP                     0x82U  /* EP1 for data IN */
      |
C:\Users\chris\.platformio\packages\framework-arduinoststm32@src-37335c727965154be67d1d5ed653b9c6\cores\arduino\stm32\usb\usbd_ep_conf.h:73: warning: "CDC_CMD_EP" redefined
   73 |   #define CDC_CMD_EP                    0x82U /*  EP2 for CDC commands */
      |
C:\Users\chris\.platformio\packages\framework-arduinoststm32@src-37335c727965154be67d1d5ed653b9c6\cores\arduino\stm32\usb\usbd_ep_conf.h:44: note: this is the location of the previous definition
   44 |   #define CDC_CMD_EP                    0x83U  /* EP2 for CDC commands */
      |
C:\Users\chris\.platformio\packages\framework-arduinoststm32@src-37335c727965154be67d1d5ed653b9c6\cores\arduino\stm32\usb\usbd_ep_conf.h:78: warning: "DEV_NUM_EP" redefined
   78 |   #define DEV_NUM_EP                    0x06U   /* Device Endpoints number including EP0 */
      |
C:\Users\chris\.platformio\packages\framework-arduinoststm32@src-37335c727965154be67d1d5ed653b9c6\cores\arduino\stm32\usb\usbd_ep_conf.h:46: note: this is the location of the previous definition
   46 |   #define DEV_NUM_EP                    0x04U   /* Device Endpoints number including EP0 */
      |
C:\Users\chris\.platformio\packages\framework-arduinoststm32@src-37335c727965154be67d1d5ed653b9c6\cores\arduino\stm32\usb\usbd_ep_conf.c:77:19: error: redefinition of 'ep_def'
   77 |   const ep_desc_t ep_def[] = {
      |                   ^~~~~~
C:\Users\chris\.platformio\packages\framework-arduinoststm32@src-37335c727965154be67d1d5ed653b9c6\cores\arduino\stm32\usb\usbd_ep_conf.c:38:19: note: previous definition of 'ep_def' was here
   38 |   const ep_desc_t ep_def[] = {
      |                   ^~~~~~
*** [.pio\build\BIGTREE_OCTOPUS_V1_USB\FrameworkArduino\stm32\usb\usbd_ep_conf.c.o] Error 1
================================================================ [FAILED] Took 9.69 seconds ================================================================

Environment             Status    Duration
----------------------  --------  ------------
BIGTREE_OCTOPUS_V1_USB  FAILED    00:00:09.690
========================================================== 1 failed, 0 succeeded in 00:00:09.690 ==========================================================
PS V:\BIGTREETECH-OCTOPUS-V1.0-master\Firmware\Marlin-bugfix-2.0.x> echo "done" >"C:\Users\chris\AppData\Local\Temp\ipc"
PS V:\BIGTREETECH-OCTOPUS-V1.0-master\Firmware\Marlin-bugfix-2.0.x>

hololight, 2021-11-05:
So it could be a hardware problem, or it could be my config (a real possibility... this is only the second board I've tried to compile Marlin for).

Yeah, you're trying to compile the 'BIGTREE_OCTOPUS_V1_USB' build target?.... I've never managed to get that one to build.

exxosuk, 2021-11-05:
The partly working one compiles as shown above, the USB one fails to compile at all.

It is not a hardware problem because as I said before, I had the switches and motors all running when I use the board out of the box. The problem started when I tried to change the firmware to invert the end stop switches. Now the motors do not function at all.

hololight, 2021-11-05:
By hardware problem, I more meant since you started working with it. Static discharge, etc... But its more likely that its my config. BTW, my light blinks as well, I wasn't terribly worried about it though...

Once I get home and get the board hooked up to my printer (I only have the board, LCD and thermistors/fans with me), I'll test, then if I'm getting same result as you, I'll try and figure out what could be missing in the config...

exxosuk, 2021-11-05:
So this is some progress now, Z and Y actually work but X does not, and X was what I was clicking on to test :-\  So not sure what is going on there, but obviously this firmware does actually work it seems..

Hecke-r, 2023-05-14:
I know I am 2 years or so late but my problem was that I hadn't connected the jumper pins to enable the uart

Closed 2021-11-05.

Thread 86 (2021-11-08):

No coling fan

GUZIKEUN, 2021-11-08:
Hello, I have a problem with the control of fans, they do not react, only the first 2 are constantly spinning, the rest of the LEDs do not light up

GUZIKEUN, 2021-11-08:
https://github.com/GUZIKEUN/GUZIKEUN/commit/b18ef87bfaae933dc6b8b6d2716522e23e626dd6

Thread 87 (2021-11-13):

Only first 3 stepper drivers working

Rneil-ca, 2021-11-13:
Hi,

I can only my first 3 stepper drivers to work on my Octopus v1.1.   I am running the latest version of Klipper (v0.1.0-122) and running BTT TMC2209s.  I have no problems with making the first 3 steppers work (x,y,z) but cannot get any of the stepper drivers working after that.  If I swap the stepper and config of the ones that are not working to any of the first 3 stepper drivers they work fine.  If I move any of the first 3 working steppers to a higher number they will not work.  I have checked jumpers and the config many times and can not make this work.  I also swapped the 2209's and that did not make any difference.

Has anyone else seen this issue before?  How did you fix it or did I get a bad board?

Thanks,
Ryan

Rneil-ca, 2021-11-14:
My stupid mistake, forgot about the motor2_2 connector, so I was plugged into the wrong port :(

Closed 2021-11-14.

Thread 88 (2021-11-22):

E0 Not functioning

FullTiltt, 2021-11-22:
The issue I've had was after swapping in the octopus board on a previously working system was that the extruder did not extrude when it was plugged into e0
#define E0_DRIVER_TYPE TMC2209
was set and plugged into board in the correct pins on the board right jumpers selected etc. In the display ui under tmc settings for voltage or mode i could see it as available and could select it to extrude under move. But obviously it did nothing. If i uncommented the E1 as above and commented out E0 the options stated above disappeared and i was left with only X,Z,Y. Basically long story short is that the solution ended up being that i had to have E0 uncommented as above but it has to be plugged into the pins for motor 4(I have a X, Y, (Z1, Z2 these being split among a single driver as i understand) and a single extruder motor) and it shows up as E1 i guess correctly but has to be set as e0? Can anyone make sense of this?

radek8, 2021-11-28:
By pin file:
X  -axis - Motor 0
Y  -axis - Motor 1
Z  -axis - Motor 2
Z2-axis - Motor 3
E0-axis - Motor 4

radek8, 2021-12-02:
Are you involved like this?

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

FullTiltt, 2021-12-05:
Sorry for late reply, the issue has been resolved by accident. Also after reading through 3dwork.io 's article on the board i saw mention of it there, this being the fact that as well as 2_1- 2_2  motor3 is reserved for second driver for z axis's. I see no mention of it in the documentation, seems like it'd be a good idea for it to be referenced there, as it overly obvious although after seeing the reasoning it does make good sense..

radek8, 2021-12-05:
Wasn't that clear from my answers?

radek8, 2021-12-05:
Close the ticket

RadicalxEdward, 2023-05-23:
This solved my issue trying to get a BTT Octopus V1.1 to work with Marlin on an Ender 3. Couldn't get the extruder to move but it turned out I had to have it configured as:
Driver 0 / Motor 0 = X0
Driver 1 / Motor 1 = Y0
Driver 2 / Motor 2_1 = Z0
Driver 2 / Motor 2_2 = [N/A]
Driver 3 / Motor 3 = [N/A]
Driver 4 / Motor 4 = E0

Which makes absolutely no sense to me. I'd think it would be drivers 0-3 as X, Y, Z, E with driver 2 just driving 2 outputs, so there'd be 1 empty motor output if you didn't have dual z axis motors.

I did see in the configuration somewhere that there's an option for dual Z *drivers*, but I had that disabled, so i don't understand why it would still reserve driver 3 / motor 3 for another Z axis. And i didn't find any other documentation anywhere that says that's the case including the BTT Octopus manual, install guides, etc. Really should be documented in the manual.

radek8, 2023-05-23:
It doesn't matter what you have defined in your configuration.
What is important is what is defined in the present pin file. And that hasn't changed.

Sangra69, 2024-02-03:
So what if you want to add another extruder to the board? How would you accomplish that?

Closed 2022-05-07.

Thread 89 (2021-11-28):

BTT Octopus V1.1 Running TMC2209 in UART mode and cannot get my dual Z steppers and E0 to run independently

jmarkscnc, 2021-11-28:
I have been working on this issue for way to long, but I have 2- Z motors and the E0 all move at the same time? I have check everything I can think of, config.h, config_adv_h, along with the pins file along with watching about 40 hours of videos that have nothing to do with this board with no success. I have uploaded my Marlin build to my shared folder on One Drive if anyone can look it over or make some suggestion, I would be very much appreciated.

https://1drv.ms/u/s!An3HLl2sqsgkiGBMwvWDTJpdLMDs?e=rRv7Om

radek8, 2021-11-28:
How are you physically involved?
X-axis - Engine 0
Y-axis - Motor 1
Z-axis - Engine 2
Z2 axis - Engine 3
E0 axis - Motor 4

If so, please try.
1. if you move the Z axis, both Z motors and also E0 will move?
2. if you move the E0 axis, do both Z motors or only one move?

jmarkscnc, 2021-11-28:
My apologies for not quit understanding your first question. I am configuring this board in Marlin.

X-axis - Engine 0 --------- X-axis - Motor 0
Y-axis - Motor 1 --------- Y-axis - Motor 1
Z-axis - Engine 2 --------- Z-axis - Motor 2
Z2 axis - Engine 3 --------- Z-axis - Motor 3
E0 axis - Motor 4 --------- E0-axis - Motor 4

I am not sure were to change this if that is what you are saying. Is this something you what me to change? if so were?

Q: if you move the Z axis, both Z motors and also E0 will move?

Yes, all of the motors turn at the same rate. I will try and attach a video link if that would help.
https://1drv.ms/u/s!Ale6SI7zYAvsbx51jUrkgCDS2bM?e=eVzpEy

Thank you for taking the time to help on this matter.

radek8, 2021-11-28:
If you eject the filament (activate motor E0) the motors Z will move? One, both mebo none?

jmarkscnc, 2021-11-28:
When selecting unload, All of the motors move Z, Z2, and E0.

radek8, 2021-11-28:
I did not notice any errors in the configuration that would cause this problem.
You can take a good look at the board, if there is no short circuit on it?
I don't know, but I'd say it may be a HW board problem.

radek8, 2021-11-28:
If position motor 4 were shorted to the Z axis, you could remap the extruder to position motor5 in the pin set and use this position for the extruder....

jmarkscnc, 2021-11-28:
The Z and Z2 will not run independently of each other either, This is a new board and I have not been able to get this to work even when I was bench testing.

The Pin file looks good according to the documentation?

// Steppers
//
#define X_STEP_PIN                          PF13  // MOTOR 0
#define X_DIR_PIN                           PF12
#define X_ENABLE_PIN                        PF14
#ifndef X_CS_PIN
  #define X_CS_PIN                          PC4
#endif

#define Y_STEP_PIN                          PG0   // MOTOR 1
#define Y_DIR_PIN                           PG1
#define Y_ENABLE_PIN                        PF15
#ifndef Y_CS_PIN
  #define Y_CS_PIN                          PD11
#endif

#define Z_STEP_PIN                          PF11  // MOTOR 2
#define Z_DIR_PIN                           PG3
#define Z_ENABLE_PIN                        PG5
#ifndef Z_CS_PIN
  #define Z_CS_PIN                          PC6
#endif

#define Z2_STEP_PIN                         PG4   // MOTOR 3
#define Z2_DIR_PIN                          PC1
#define Z2_ENABLE_PIN                       PA0
#ifndef Z2_CS_PIN
  #define Z2_CS_PIN                         PC7
#endif

#define E0_STEP_PIN                         PF9   // MOTOR 4
#define E0_DIR_PIN                          PF10
#define E0_ENABLE_PIN                       PG2
#ifndef E0_CS_PIN
  #define E0_CS_PIN                         PF2
#endif

    Is there anything else I can try before returning this Octopus board. I really am starting with an old just frame and bulding and adding for testing for a new design and I needed the functionality of this Octopus board? Just frustrated I usually can figure these types of things out but I am stumped.
    If the Motor 4 is shorted and I move it to Motor 5 that still is not fixing the issue with motors 2 and 3. They will not run independently for Z leveling either?

jmarkscnc, 2021-11-29:
Well I just bought 2 more BTT-Octopus V1.1 boards. I still think that there is something wrong with this one I got. I have never had this many issues with any BigTreeTech products so I am throwing in the towel as we say on this one. I do not see anything as far as solder bridging or anything burnt or looks shorted out. I did move and remapped the pins and I will give that a try but I'm not sure if the driver is bad and shorting something on the main board  or it's the main octopus board? Thank you for all of you assistance. I will get the new ones in a couple of days so I will reach back if this continues.

radek8, 2021-11-29:
See #54

radek8, 2021-11-29:
Send the photo plugged in.
Have you used the right connectors?

jmarkscnc, 2021-12-02:
So like I said I thought it may be a bad board. Now loading my same build of marlin that I shared 3 days ago that was somewhat working with the uart mode. I have another new board delivered today and all new TMC2209s I get no communication with the drivers??? I downloaded the marlin build from the BigTreeTech repository for the octopus v1.1 and that would not build. I was just going to test your test build on a new board with new drivers bench test. Nothing but errors. I have again exhausted researching on line with no solution. May I ask using bigtree Octopus board with Bigtree TMC drivers do I need to solder jumpers or cut pins?? The first board is now giving me eeprom errors so I think I killed that one. I don't think I have ever had so much troubleshooting on new equipment like this.

SENDING:M122
axis:pwm_scale/curr_scale/mech_load|flags|warncount
		X	Y	Z	Z2	E
Address		0	0	0	0	0
Enabled		false	false	false	false	false
Set current	800	800	650	650	800
RMS current	1436	1436	1160	1160	1436
MAX current	2025	2025	1636	1636	2025
Run current	25/31	25/31	20/31	20/31	25/31
Hold current	12/31	12/31	10/31	10/31	12/31
CS actual	0/31	0/31	0/31	0/31	0/31
PWM scale
vsense		0=.325	0=.325	0=.325	0=.325	0=.325
stealthChop	false	false	false	false	false
msteps		256	256	256	256	256
interp		false	false	false	false	false
tstep		0	0	0	0	0
PWM thresh.
[mm/s]
OT prewarn	false	false	false	false	false
triggered
 OTP		false	false	false	false	false
pwm scale sum	0	0	0	0	0
pwm scale auto	0	0	0	0	0
pwm offset auto	0	0	0	0	0
pwm grad auto	0	0	0	0	0
off time	0	0	0	0	0
blank time	16	16	16	16	16
hysteresis
 -end		-3	-3	-3	-3	-3
 -start		1	1	1	1	1
Stallguard thrs	0	0	0	0	0
uStep count	0	0	0	0	0
DRVSTATUS	X	Y	Z	Z2	E
sg_result	0	0	0	0	0
stst		*	*	*	*	*
olb
ola
s2gb
s2ga
otpw
ot
157C
150C
143C
120C
s2vsa
s2vsb
Driver registers:
		X	0x00:00:00:00	 Bad response!
		Y	0x00:00:00:00	 Bad response!
		Z	0x00:00:00:00	 Bad response!
		Z2	0x00:00:00:00	 Bad response!
		E	0x00:00:00:00	 Bad response!
Testing X connection... Error: All LOW
Testing Y connection... Error: All LOW
Testing Z connection... Error: All LOW
Testing Z2 connection... Error: All LOW
Testing E connection... Error: All LOW

HELP PLEASE....

radek8, 2021-12-02:
Send a photo of the wired board. Send a photo of tmc2209 from the side of the pins

radek8, 2021-12-02:
Check if the pins for UART mod are connected

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

jmarkscnc, 2021-12-02:
Sorry I figured it out. Very rookie mistake, I have several power leads to supply power on my bench and I had the circuit supplying 24v DC to the steppers was but not switched on. my apologies.
 Driver registers:
		X	0xC0:0C:00:00
		Y	0xC0:0C:00:00
		Z	0xC0:0A:00:00
		Z2	0xC0:0A:00:00
		E	0xC0:0C:00:00
Testing X connection... OK
Testing Y connection... OK
Testing Z connection... OK
Testing Z2 connection... OK
Testing E connection... OK

Now I just can not figure out the Error: Line number is not last Line Number+1 last line 0. I think is is a high low report but I can not find the issue.
I think it may be in the thermistors settings for the bed?
if I switch my screen to Marlin mode I can see that the Hot End shows 0degrees and 0degrees. However the bed shows 0 degrees and err. However I get E0 showing 0 degrees and 0 degrees and the bed showing 0 degrees and 0 degrees between the warning messages.
Just to be clear these settings are all being tested on the new 2nd octopus board.

jmarkscnc, 2021-12-02:
I switch my screen to Marlin mode I can see that the Hot End shows 0degrees and 0degrees. However the bed shows 0 degrees and err.

I get E0 showing 0 degrees and 0 degrees and the bed showing 0 degrees and 0 degrees between the warning messages on the touch screen mode.

jmarkscnc, 2021-12-03:
First thing is I want to thank you for your assistance. I do really appreciate all of you help.

   Ok now that  I am back where I started with the first board before it went to heck. Board 2 is now up and running but the Z  and Z2 will not work exacting a G34 Z align. Also I am back to the problem with the E0 moving in sink with the Z axis. This is what I the first board went crazy and lit up all of the heater mosfets like a Christmas Tree.. I guess no refund or replacement on that board.....

   In Marlin I commented out E0 and uncommented E1. I then moved E0 stepper to motor 5 and also Moved Z2 to motor 4 leaving motor 3 open. Wow everything seems to be working.  Same build except for the TFT rebuild with the fixes from yesterday seems to have done the trick.

   One thing now is the tft70 when loading filament in touch mode, the stepper runs the unload and then a warning comes up waiting for user input. you can click ok forever and this alarm does go away. Should this not say load or purge more? I just uploaded the latest build to the tft70 and compiled. I also got a language file error to load the language in my case English?

   I will recompile and see if that fixes the errors with the load/unload. I will let you know. If anyone has any suggestions on this it would help me a lot.  It is late here so I'm calling it a night for today.  Thanks again!

radek8, 2021-12-03:
I hope you noticed that the connector for the Z motor is duplicated?

jmarkscnc, 2021-12-03:
My apologies I miss typed the Motor locations. Yes this is my current connections on the board.

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

I read on other posts that if moving the E0 to motor 4 you would need to label this E1 in Marlin. I am trying to follow the mapping of the Marlin code but I am just a rookie when I get in too deep in the logic. Could that be the issue with the load/unload?

radek8, 2021-12-03:
If you want to use a different default connector, just edit the pin file for your board.

monsterjeepn, 2022-02-10:
> If you want to use a different default connector, just edit the pin file for your board.

This is the right answer. To expand a bit, there are two spots to modify/verify in the "pins_BTT_OCTOPUS_V1_common.h" file. Search for "X_STEP_PIN" and modify the step/dir/en/cs pin settings according to your hardware configuration. Also search for "X_SERIAL_TX_PIN" and modify the TX/RX pin settings for the TMC drivers in your hardware configuration. The schematic and the board layout (*PINS.pdf) are invaluable to figure this out.

Thread 90 (2021-12-05):

Cant control any other fans than single part cooling fan

hololight, 2021-12-05:
Whenever I try to use m106 p* s255, I can only control the part cooling fan (pin 0). Pin 1 is assigned to auto extruder cooling (and kicks on fine above the set 50C). But when I plug a fan into any of the other PWM fan outputs, I can't control them (they never turn on with any value of P* with my M106 command. I'm eventually going to be controlling a Laser, but in the meantime I was testing with just another blower fan.

radek8, 2021-12-05:
You can only control ventilators that you define in FW

hololight, 2021-12-05:
Can you point me to the correct area for me to take a look? I'm just not seeing it... in fans.h there is already 3 fans listed:
#define FAN_PIN                             PE5   // Fan0
#define FAN1_PIN                            PE6   // Fan1
#define FAN2_PIN                            PC8   // Fan2

in configuration.h I'm not seeing where I would define it other than the following (which the comment claims by leaving the line commented out, enables all fans:

// Set number of user-controlled fans. Disable to use all board-defined fans.
// :[1,2,3,4,5,6,7,8]
//#define NUM_M106_FANS 1

hololight, 2021-12-05:
So I got it working. I made two changes (not sure which [or both?] made the difference):

In configuration_adv.h:
I commented out the controller cooling fan (I dont need it since I use an always on fan connected two one of the two ports used for that purpose). My logic was that the cooling fan was defined as using FAN2_PIN, so I could use that pin perhaps, if I stopped it from being used by the cooling fan...

// #define USE_CONTROLLER_FAN

Then in configuration.h:
This is the more likely culprit... I removed the comment and set the number of fans to 4.... according to the documentation I shouldn't' have had to do this, but I think its what got it working.

Now on to hooking up the laser to this new 'dedicated' port

Closed 2021-12-05.

Thread 91 (2021-12-13):

USB thumb drive support, Marlin, Octopus 1.1

roschme, 2021-12-13:
Hi,

i'm in trouble compiling Marlin-bugfix-2.0.x with activated " #define USB_FLASH_DRIVE_SUPPORT " and " #define USE_OTG_USB_HOST "for an Octopus 1.1 under VSC Platformio. What i'm doing wrong? Would be very grateful for your hints and help.
(USB Host Support/Pronterface works as everthing else but the support for usb thumbs fails)

thx bob

compilerlog:

C:/users/xyz/.platformio/paCkages/toolChain-gCCarmnoneeabi/bin/../lib/gCC/arm-none-eabi/9.2.1/../../../../arm-none-eabi/bin/ld.exe: .pio/build/BIGTREE_OCTOPUS_V1/srC/srC/sd/usb_flashdrive/Sd2Card_FlashDrive.Cpp.o: in funCtion `DiskIODriver_USBFlash::isReady()':
C:\BIGTREETECH-OCTOPUS-V1.0-master\Firmware\Marlin-bugfix-2.0.x/Marlin\srC\sd\usb_flashdrive/Sd2Card_FlashDrive.Cpp:266: undefined referenCe to `USBHost::getUsbTaskState()'
C:/users/xyz/.platformio/paCkages/toolChain-gCCarmnoneeabi/bin/../lib/gCC/arm-none-eabi/9.2.1/../../../../arm-none-eabi/bin/ld.exe: C:\BIGTREETECH-OCTOPUS-V1.0-master\Firmware\Marlin-bugfix-2.0.x/Marlin\srC\sd\usb_flashdrive/Sd2Card_FlashDrive.Cpp:266: undefined referenCe to `usb'
C:/users/xyz/.platformio/paCkages/toolChain-gCCarmnoneeabi/bin/../lib/gCC/arm-none-eabi/9.2.1/../../../../arm-none-eabi/bin/ld.exe: .pio/build/BIGTREE_OCTOPUS_V1/srC/srC/sd/usb_flashdrive/Sd2Card_FlashDrive.Cpp.o: in funCtion `DiskIODriver_USBFlash::CardSize()':
C:\BIGTREETECH-OCTOPUS-V1.0-master\Firmware\Marlin-bugfix-2.0.x/Marlin\srC\sd\usb_flashdrive/Sd2Card_FlashDrive.Cpp:296: undefined referenCe to `bulk'
C:/users/xyz/.platformio/paCkages/toolChain-gCCarmnoneeabi/bin/../lib/gCC/arm-none-eabi/9.2.1/../../../../arm-none-eabi/bin/ld.exe: C:\BIGTREETECH-OCTOPUS-V1.0-master\Firmware\Marlin-bugfix-2.0.x/Marlin\srC\sd\usb_flashdrive/Sd2Card_FlashDrive.Cpp:294: undefined referenCe to `BulkStorage::GetCapaCity(unsigned Char)'
C:/users/xyz/.platformio/paCkages/toolChain-gCCarmnoneeabi/bin/../lib/gCC/arm-none-eabi/9.2.1/../../../../arm-none-eabi/bin/ld.exe: .pio/build/BIGTREE_OCTOPUS_V1/srC/srC/sd/usb_flashdrive/Sd2Card_FlashDrive.Cpp.o: in funCtion `DiskIODriver_USBFlash::readBloCk(unsigned long, unsigned Char*)':
C:\BIGTREETECH-OCTOPUS-V1.0-master\Firmware\Marlin-bugfix-2.0.x/Marlin\srC\sd\usb_flashdrive/Sd2Card_FlashDrive.Cpp:309: undefined referenCe to `BulkStorage::Read(unsigned Char, unsigned long, unsigned short, unsigned Char, unsigned Char*)'
C:/users/xyz/.platformio/paCkages/toolChain-gCCarmnoneeabi/bin/../lib/gCC/arm-none-eabi/9.2.1/../../../../arm-none-eabi/bin/ld.exe: C:\BIGTREETECH-OCTOPUS-V1.0-master\Firmware\Marlin-bugfix-2.0.x/Marlin\srC\sd\usb_flashdrive/Sd2Card_FlashDrive.Cpp:299: undefined referenCe to `bulk'
C:/users/xyz/.platformio/paCkages/toolChain-gCCarmnoneeabi/bin/../lib/gCC/arm-none-eabi/9.2.1/../../../../arm-none-eabi/bin/ld.exe: .pio/build/BIGTREE_OCTOPUS_V1/srC/srC/sd/usb_flashdrive/Sd2Card_FlashDrive.Cpp.o: in funCtion `DiskIODriver_USBFlash::writeBloCk(unsigned long, unsigned Char Const*)':
C:\BIGTREETECH-OCTOPUS-V1.0-master\Firmware\Marlin-bugfix-2.0.x/Marlin\srC\sd\usb_flashdrive/Sd2Card_FlashDrive.Cpp:323: undefined referenCe to `BulkStorage::Write(unsigned Char, unsigned long, unsigned short, unsigned Char, unsigned Char Const*)'
C:/users/xyz/.platformio/paCkages/toolChain-gCCarmnoneeabi/bin/../lib/gCC/arm-none-eabi/9.2.1/../../../../arm-none-eabi/bin/ld.exe: C:\BIGTREETECH-OCTOPUS-V1.0-master\Firmware\Marlin-bugfix-2.0.x/Marlin\srC\sd\usb_flashdrive/Sd2Card_FlashDrive.Cpp:313: undefined referenCe to `bulk'
C:/users/xyz/.platformio/paCkages/toolChain-gCCarmnoneeabi/bin/../lib/gCC/arm-none-eabi/9.2.1/../../../../arm-none-eabi/bin/ld.exe: .pio/build/BIGTREE_OCTOPUS_V1/srC/srC/sd/usb_flashdrive/Sd2Card_FlashDrive.Cpp.o: in funCtion `DiskIODriver_USBFlash::usbStartup()':
C:\BIGTREETECH-OCTOPUS-V1.0-master\Firmware\Marlin-bugfix-2.0.x/Marlin\srC\sd\usb_flashdrive/Sd2Card_FlashDrive.Cpp:127: undefined referenCe to `USBHost::start()'
C:/users/xyz/.platformio/paCkages/toolChain-gCCarmnoneeabi/bin/../lib/gCC/arm-none-eabi/9.2.1/../../../../arm-none-eabi/bin/ld.exe: C:\BIGTREETECH-OCTOPUS-V1.0-master\Firmware\Marlin-bugfix-2.0.x/Marlin\srC\sd\usb_flashdrive/Sd2Card_FlashDrive.Cpp:142: undefined referenCe to `usb'
C:/users/xyz/.platformio/paCkages/toolChain-gCCarmnoneeabi/bin/../lib/gCC/arm-none-eabi/9.2.1/../../../../arm-none-eabi/bin/ld.exe: .pio/build/BIGTREE_OCTOPUS_V1/srC/srC/sd/usb_flashdrive/Sd2Card_FlashDrive.Cpp.o: in funCtion `DiskIODriver_USBFlash::idle()':
C:\BIGTREETECH-OCTOPUS-V1.0-master\Firmware\Marlin-bugfix-2.0.x/Marlin\srC\sd\usb_flashdrive/Sd2Card_FlashDrive.Cpp:151: undefined referenCe to `USBHost::Task()'
C:/users/xyz/.platformio/paCkages/toolChain-gCCarmnoneeabi/bin/../lib/gCC/arm-none-eabi/9.2.1/../../../../arm-none-eabi/bin/ld.exe: C:\BIGTREETECH-OCTOPUS-V1.0-master\Firmware\Marlin-bugfix-2.0.x/Marlin\srC\sd\usb_flashdrive/Sd2Card_FlashDrive.Cpp:153: undefined referenCe to `USBHost::getUsbTaskState()'
C:/users/xyz/.platformio/paCkages/toolChain-gCCarmnoneeabi/bin/../lib/gCC/arm-none-eabi/9.2.1/../../../../arm-none-eabi/bin/ld.exe: C:\BIGTREETECH-OCTOPUS-V1.0-master\Firmware\Marlin-bugfix-2.0.x/Marlin\srC\sd\usb_flashdrive/Sd2Card_FlashDrive.Cpp:209: undefined referenCe to `BulkStorage::LUNIsGood(unsigned Char)'
C:/users/xyz/.platformio/paCkages/toolChain-gCCarmnoneeabi/bin/../lib/gCC/arm-none-eabi/9.2.1/../../../../arm-none-eabi/bin/ld.exe: C:\BIGTREETECH-OCTOPUS-V1.0-master\Firmware\Marlin-bugfix-2.0.x/Marlin\srC\sd\usb_flashdrive/Sd2Card_FlashDrive.Cpp:243: undefined referenCe to `BulkStorage::LUNIsGood(unsigned Char)'
C:/users/xyz/.platformio/paCkages/toolChain-gCCarmnoneeabi/bin/../lib/gCC/arm-none-eabi/9.2.1/../../../../arm-none-eabi/bin/ld.exe: C:\BIGTREETECH-OCTOPUS-V1.0-master\Firmware\Marlin-bugfix-2.0.x/Marlin\srC\sd\usb_flashdrive/Sd2Card_FlashDrive.Cpp:254: undefined referenCe to `usb'
C:/users/xyz/.platformio/paCkages/toolChain-gCCarmnoneeabi/bin/../lib/gCC/arm-none-eabi/9.2.1/../../../../arm-none-eabi/bin/ld.exe: C:\BIGTREETECH-OCTOPUS-V1.0-master\Firmware\Marlin-bugfix-2.0.x/Marlin\srC\sd\usb_flashdrive/Sd2Card_FlashDrive.Cpp:254: undefined referenCe to `bulk'
C:/users/xyz/.platformio/paCkages/toolChain-gCCarmnoneeabi/bin/../lib/gCC/arm-none-eabi/9.2.1/../../../../arm-none-eabi/bin/ld.exe: .pio/build/BIGTREE_OCTOPUS_V1/srC/srC/sd/usb_flashdrive/Sd2Card_FlashDrive.Cpp.o: in funCtion `DiskIODriver_USBFlash::init(unsigned Char, short)':
C:\BIGTREETECH-OCTOPUS-V1.0-master\Firmware\Marlin-bugfix-2.0.x/Marlin\srC\sd\usb_flashdrive/Sd2Card_FlashDrive.Cpp:274: undefined referenCe to `BulkStorage::GetSeCtorSize(unsigned Char)'
C:/users/xyz/.platformio/paCkages/toolChain-gCCarmnoneeabi/bin/../lib/gCC/arm-none-eabi/9.2.1/../../../../arm-none-eabi/bin/ld.exe: C:\BIGTREETECH-OCTOPUS-V1.0-master\Firmware\Marlin-bugfix-2.0.x/Marlin\srC\sd\usb_flashdrive/Sd2Card_FlashDrive.Cpp:285: undefined referenCe to `bulk'

roschme, 2021-12-15:
USB Flash Disk finally working on the Octopus V1.1:
Just use the ORIGINAL! https://github.com/MarlinFirmware/Marlin/archive/2.0.x.zip

platformio.ini:
...
[platformio]
src_dir      = Marlin
boards_dir   = buildroot/share/PlatformIO/boards
default_envs = BIGTREE_OCTOPUS_V1_USB
include_dir  = Marlin
...

configuration.h:
...
#define CONFIGURATION_H_VERSION 02000902
...
#define MOTHERBOARD BOARD_BTT_OCTOPUS_V1_1
...
#define SDSUPPORT
...

configuration_adv.h :
...
#define USB_FLASH_DRIVE_SUPPORT //bob
...
#define USE_OTG_USB_HOST
...
#define NO_SD_HOST_DRIVE   //Disable SD Card access over USB (for security). (otherwise problems with pronterface under win)

usama0300854, 2024-02-09:
i downloaded Marlin-bugfix-2.1.x.. remember to download bugfix..this file will be larger than the rest.

[platformio]
src_dir      = Marlin
boards_dir   = buildroot/share/PlatformIO/boards
default_envs = STM32F446ZE_btt_usb_flash_drive
include_dir  = Marlin

>>>>> in Configuration.h :

#ifndef MOTHERBOARD
  #define MOTHERBOARD BOARD_BTT_OCTOPUS_V1_1
#endif

#define SERIAL_PORT -1
#define SERIAL_PORT_2 1

#ifndef MOTHERBOARD
  #define MOTHERBOARD BOARD_BTT_OCTOPUS_V1_1
#endif

#define SDSUPPORT

>>>  configuration_adv.h :
...
#define USB_FLASH_DRIVE_SUPPORT
...
#define USE_OTG_USB_HOST
...
#define NO_SD_HOST_DRIVE //Disable SD Card access over USB (for security). (otherwise problems with pronterface under win)

Thread 92 (2022-01-01):

Error while compiling Marlin for Octopus v1.0

Hyphie, 2022-01-01:
Within - buildroot/share/PlatformIO/scripts/signature.py
You need to Fix UTF-8 error in configuration.

Within signature.py
Line 15 has the following:
f = open(filepath).read().split("\n")

Should be updated to be as follows:
f = open(filepath, encoding="utf8").read().split("\n")

Drewadc, 2022-01-04:
Thank you!  I've been having issues also and was struggling where to find the missing encoding string.  I second that this needs added and it was able to compile afterwards.

Thread 94 (2022-01-14):

HE0-HE3 are always on

Wukii2012, 2022-01-14:
So I have a new board that I setup with the firmware powered via USB.  When I changed over to normal power (took out the jumper) the board powers on and seems to be working fine however the HE0-HE3 are also powered on and showing a green light next to them. They started to heat up my bed and hotend. Should this be happening??

qcgilbert, 2022-02-05:
I am experiencing the same issue

jjkrygsman, 2022-10-08:
I'm experiencing the same issue on multiple boards, even with Klipper firmware.  HE0-HE3 eventually turn off, but not sure why they are on the begin with.

the1snm, 2022-10-29:
I've got 2 octopus pro boards and 1 does not have this problem and the other does. Nothing seems to turn off these heaters. I've swapped out my steppers, reflashed the board, removed all the wires from the board just 24v hooked up and still the heaters turn on. Aside from the heaters on, everything else works perfectly, all motors move, endstops, fans etc. I'm still inside my return window so I've got a replacement on it's way, don't know what else to test.

ajenkuhnabat, 2024-03-06:
Did you see the pin changes here: https://github.com/bigtreetech/BIGTREETECH-OCTOPUS-Pro
They swapped Motor4 ENable and HE0, would would case this issue. I ran ito this by myself and solved it by correcting the klipper config pins.

Thread 96 (2022-01-16):

X driver error detected: 0xC0120004 Recv: coil short circuit - Marlin on Octopus-V1.1, TMC2209 UART mode

FriedrichUthe, 2022-01-16:
### Problem: When I try to move the printer's X-Axis, the axis does not move. With around 5-10 sec delay the printer crashes.

The Octoprint-Terminals says:
...
Recv: X driver error detected: 0xC0120004
Recv: coil short circuit
Recv: 		X	Y	Z	E
Recv: Address		0	0	0	0
Recv: Enabled		true	true	true	false
Recv: Set current	800	800	800	800
Recv: RMS current	795	795	795	795
Recv: MAX current	1121	1121	1121	1121"

...and...

Recv: echo:Driver error
Recv: Error:Printer halted. kill() called!
Changing monitoring state from "Operational" to "Error"

other Axis and E work fine.
full output:

[TerminalOutput.txt](https://github.com/bigtreetech/BIGTREETECH-OCTOPUS-V1.0/files/7877553/TerminalOutput.txt)

What I tried:
- plugged x axis motort into y-axis driver and moved the axis --> motor and cables OK.
- switched x- and y- stepper motor drivers. Same phenotype, Y-Achsis works fine, X-Achsis movement leads to crash --> stepper motor driver is OK.

- Switched X-Motor to spreadcycle mode with  M569 X S0. --> Stepper moves as expected!. Hovever Marlin crashes with the same error.
[TerminalOutputSreadcycle.txt](https://github.com/bigtreetech/BIGTREETECH-OCTOPUS-V1.0/files/7877552/TerminalOutputSreadcycle.txt)

 -visually inspected board for soldering flaws or anything that would short the port anywhere --> nothing obvious.

other info: I switched to the bugfix version of Marlin because I was not able to connect Octoprint to the board through USB on the non-bugfix verison of Marlin. Testing the bugfix-version was part of my troubleshooting efforts and helped.

These are my Marlin Config-Files:
[Configuration.txt](https://github.com/bigtreetech/BIGTREETECH-OCTOPUS-V1.0/files/7877556/Configuration.txt)
[Configuration_adv.txt](https://github.com/bigtreetech/BIGTREETECH-OCTOPUS-V1.0/files/7877557/Configuration_adv.txt)

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

Any ideas anyone? Thanks!!

FriedrichUthe, 2022-01-29:
Acquired ample of evidence now that the board is simply faulty. Closing the issue.

Closed 2022-01-29.

Thread 97 (2022-01-29):

12v LED Case Light

alexcua, 2022-01-29:
How do I set up the board to work with a 2 wire, 12v LED case light?
I have it wired to an unused fan port and it works with M106 but not with M355.
My BTT is also connected to a mini 12864.

I've enabled #define CASE_LIGHT_ENABLE but don't know how to set #define CASE_LIGHT_PIN 4

Thread 98 (2022-01-29):

Photo for the Raspberry Pi power connection has an error

NAPCAL, 2022-01-29:
BIGTREETECH-OCTOPUS-V1.0/Firmware/Klipper/Images/rpi_pinout.jpg is showing connecting 3.3V & 5V; this will cause issues with both boards. Ground, TX, RX is only needed, and 5V if the Octopus will be the only supply connected to the Raspberry Pi.

Thread 99 (2022-02-05):

Error compiling Marlin Bugfix 2.0.9.2 on a Bigteeetech Octopus V1.1

Delanjp949, 2022-02-05:
Getting the following error con compile,
Whta am I doing wrong. Cannot see the error.
Compiling using Visual Studio.

help apprectated.

James

> Executing task in folder Marlin-bugfix-2.0.9.2.x: C:\Users\james\.platformio\penv\Scripts\platformio.exe run <

Processing BIGTREE_OCTOPUS_V1 (platform: ststm32@~12.1; board: marlin_BigTree_Octopus_v1; framework: arduino)
---------------------------------------------------------------------------------------------------------------------------------------------------------------------------------------------------------Verbose mode can be enabled via `-v, --verbose` option
UnicodeDecodeError: 'charmap' codec can't decode byte 0x90 in position 79486: character maps to <undefined>:
  File "C:\Users\james\.platformio\penv\lib\site-packages\platformio\builder\main.py", line 179:
    env.SConscript(item, exports="env")
  File "C:\Users\james\.platformio\packages\tool-scons\scons-local-4.3.0\SCons\Script\SConscript.py", line 597:
    return _SConscript(self.fs, *files, **subst_kw)
  File "C:\Users\james\.platformio\packages\tool-scons\scons-local-4.3.0\SCons\Script\SConscript.py", line 285:
    exec(compile(scriptdata, scriptname, 'exec'), call_stack[-1].globals)
  File "C:\Users\james\Download\BIGTREETECH-OCTOPUS-V1.0-master\BIGTREETECH-OCTOPUS-V1.0-master\Firmware\Marlin-bugfix-2.0.9.2.x\buildroot\share\PlatformIO\scripts\common-dependencies.py", line 253:
    compute_build_signature(env)
  File "C:\Users\james\Download\BIGTREETECH-OCTOPUS-V1.0-master\BIGTREETECH-OCTOPUS-V1.0-master\Firmware\Marlin-bugfix-2.0.9.2.x\buildroot\share\PlatformIO\scripts\signature.py", line 83:
    defines = extract_defines(header)
  File "C:\Users\james\Download\BIGTREETECH-OCTOPUS-V1.0-master\BIGTREETECH-OCTOPUS-V1.0-master\Firmware\Marlin-bugfix-2.0.9.2.x\buildroot\share\PlatformIO\scripts\signature.py", line 15:
    f = open(filepath).read().split("\n")
  File "C:\Users\james\.platformio\python3\lib\encodings\cp1252.py", line 23:
    return codecs.charmap_decode(input,self.errors,decoding_table)[0]
====================================================================================== [FAILED] Took 1.32 seconds ======================================================================================

Environment         Status    Duration
------------------  --------  ------------
BIGTREE_OCTOPUS_V1  FAILED    00:00:01.320
================================================================================= 1 failed, 0 succeeded in 00:00:01.320 =================================================================================The terminal process "C:\Users\james\.platformio\penv\Scripts\platformio.exe 'run'" terminated with exit code: 1.

Terminal will be reused by tasks, press any key to close it.

monsterjeepn, 2022-02-08:
I encountered this as well. [Marlin fix #23303](https://github.com/MarlinFirmware/Marlin/pull/23303/files) worked for me.

Delanjp949, 2022-02-08:
All fixed thanks.  Deleted the .Plantformio folder under the user profile.  Force a reintsll on PIO and all worked afterwards

Closed 2022-02-08.

Thread 100 (2022-02-06):

Nema 23 wiring/coding

luca920, 2022-02-06:
Hi all,
I would like to run Nema 23 4.2ah stepper motor with the octopus, but their are not movign at all...

Unfortunately I have not found any specific instruction on the wiring nor the coding part (except from changing the driver definition in the configuration.h file)

For the wiring I tryied different ways also for the jumpers but nothing happened so far.

I am using as external driver a TB6560.

Is there anyone who tryed and did it?

monsterjeepn, 2022-02-13:
I assume you are trying to use one of the existing driver sockets on the Octopus to control the external driver? What are your jumper settings for the driver socket you are using to control the external TB6560? I would assume all jumpers for the socket you're using need to be removed, as you'll be using the TB6560 in Step/Dir mode. Reference the Octopus PINs document and the Schematic for the proper pins to connect to on the driver socket (Step, Direction, Enable).

If you are confident in the wiring, then your issue is likely in the firmware. I can think of three ways this could be happening:

1. Is your drive enable pin active high or active low? There is a setting for that in Marlin.
2. There might be a configuration setting for Step/Dir mode on a particular stepper driver. I am not sure about this, as I use TMC2209 drivers.
3. The pins_BTT_Octopus_V1_common.h file has some assumptions made, and you might want to check the Step/Dir/En pins for the socket you wish to use. Reference the schematic, as it seems to be accurate.

Thread 101 (2022-02-07):

error while compiling

Tim9557, 2022-02-07:
[{
	"resource": "/c:/Users/Tim/Downloads/BIGTREETECH-OCTOPUS-V1.0-master/BIGTREETECH-OCTOPUS-V1.0-master/Firmware/Marlin-bugfix-2.0.9.2.x/.vscode/c_cpp_properties.json",
	"owner": "c:\\Users\\Tim\\Downloads\\BIGTREETECH-OCTOPUS-V1.0-master\\BIGTREETECH-OCTOPUS-V1.0-master\\Firmware\\Marlin-bugfix-2.0.9.2.x",
	"severity": 4,
	"message": "Cannot find \"C:\\Users\\Tim\\.platformio\\packages\\framework-arduinoststm32\\variants\\MARLIN_BIGTREE_OCTOPUS_V1\".",
	"startLineNumber": 39,
	"startColumn": 17,
	"endLineNumber": 39,
	"endColumn": 112
},{
	"resource": "/c:/Users/Tim/Downloads/BIGTREETECH-OCTOPUS-V1.0-master/BIGTREETECH-OCTOPUS-V1.0-master/Firmware/Marlin-bugfix-2.0.9.2.x/.vscode/c_cpp_properties.json",
	"owner": "c:\\Users\\Tim\\Downloads\\BIGTREETECH-OCTOPUS-V1.0-master\\BIGTREETECH-OCTOPUS-V1.0-master\\Firmware\\Marlin-bugfix-2.0.9.2.x",
	"severity": 4,
	"message": "Cannot find \"C:\\Users\\Tim\\.platformio\\packages\\framework-arduinoststm32\\variants\\MARLIN_BIGTREE_OCTOPUS_V1\".",
	"startLineNumber": 77,
	"startColumn": 21,
	"endLineNumber": 77,
	"endColumn": 116
},{
	"resource": "/c:/Users/Tim/Downloads/BIGTREETECH-OCTOPUS-V1.0-master/BIGTREETECH-OCTOPUS-V1.0-master/Firmware/Marlin-bugfix-2.0.9.2.x/.vscode/c_cpp_properties.json",
	"owner": "c:\\Users\\Tim\\Downloads\\BIGTREETECH-OCTOPUS-V1.0-master\\BIGTREETECH-OCTOPUS-V1.0-master\\Firmware\\Marlin-bugfix-2.0.9.2.x",
	"severity": 4,
	"message": "Cannot find \"arm-none-eabi-gcc\".",
	"startLineNumber": 107,
	"startColumn": 29,
	"endLineNumber": 107,
	"endColumn": 48
}]

pilgerone, 2022-02-27:
Same thing here. Can't compile. Have you manage to find a workaround?

Hman32, 2022-03-27:
@pilgerone  can you try to remove the .vscode folder and start again your VS Code?
Normally they should not include the .vscode folder into the repository :/

pilgerone, 2022-04-03:
> @pilgerone can you try to remove the .vscode folder and start again your VS Code? Normally they should not include the .vscode folder into the repository :/

I actually ended up taking the vanilla Marlin from the original repo and adjusting it to the octopus. I took the config files from this one and compared with the original stuff, changing what needed to be changed. Took quite some work, but it's working flawlessly.

Thread 102 (2022-02-11):

Status LED permanently light

exxosuk, 2022-02-11:
My first octopus board seem to have a driver board failure which seemed to kill the board totally :(

So I connected up a new board where I tried to write my current firmware and it just continuously said they could not write to EEPROM. I remember I had this same issue originally with the previous board but I am not sure what I did to correct it.

But the problem is now a status LED is just permanently let read and I cannot connect to the board at all. It did briefly connect to the STM software package and I read the data but when I disconnected the LED remained permanently red.

Incidentally I had the faulty driver board plugged into this board ( I did not know it was faulty but it was getting red-hot and the 24V main power was even turned off) so I fear I have managed to kill two boards now :(

So does anyone know if this board is recoverable as my PC does not even see the USB connection any more :(

exxosuk, 2022-02-11:
Seems 2 of the TMC2226 drivers had failed. Now I have removed them, the red status light is flashing again! These things are WAY to fragile !

Closed 2022-02-11.

Thread 103 (2022-02-16):

Board not working when Jumpers were not kept

selvakumaran2016, 2022-02-16:
Hi all,

We are using the Octopus V1.1 board. We have already used 2-3 boards and all are working properly.

In one board, while keeping the jumpers for the Motor 7 Stepper driver, we forget to keep any jumpers. (All other 6 motors are properly connected with Jumpers). Without any jumper, we inserted A4988.

A small burning smell came and the board became dead.

The marked chip in the below image looks burnt. The main processor is not showing any signs of burning.

Please suggest whether we can change this? and what is that IC name?

Now when connecting to PC, it is not showing any port. And even no LED is glowing.

Thanks in advance

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

radek8, 2022-02-20:
It should be a 3.3V VCC voltage regulator

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

radek8, 2022-02-20:
These should be two matched voltage regulators.

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

radek8, 2022-02-20:
RT9193-33GB

radek8, 2022-02-20:
https://de.aliexpress.com/item/4000387137481.html?product_id=4000387137481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

selvakumaran2016, 2022-02-21:
@radek8 Great. Thanks for the support. Will order this...

Closed 2022-02-21.

Thread 104 (2022-02-18):

E0 marlin extruder problem 2.0.9.3

stampa3d, 2022-02-18:
E0 marlin extruder problem 2.0.9.3
Guys, I installed 4 zeta motors, everything works but installing the E0 extruder in Motor 6 does not work for me. Are there any problems with this card and additional motors?
Do I need to change any pins for the E0 motor?
The strange thing is that in the display E0 is replaced by E1 but still does not spin.

Closed 2022-02-19.

Thread 105 (2022-02-20):

DIAG0 to DIAG7 provide 5V, not 3.3V

bubnikv, 2022-02-20:
Published schematic and pins description define 3.3V at the end stop connectors, while the Octopus board I have received from Formbot  provdes 5V at these pins. Please provide an up to date schematic and pins description for the current Octopus board revision.

Thread 106 (2022-02-22):

FSMC display support

mkornmue, 2022-02-22:
I want to use an FSMC touch display with an ILI9486 Driver but there is no information how to connect the display for that.

Is FSMC supported for the Octopus V1.1?

I can find FSMC ports for the STM32F446 on EXP1 so it should be possible. Am I right?

TheCount2255, 2022-02-22:
You would need to trace out the EXP1 pins to the pins on the back of the display. Once you have the cabling correct you should be good to go.

mkornmue, 2022-02-23:
The thing is why I'am struggeling is that on the STM website there is no information regarding FSMC for this specific controller (STM32F446 ). The earliest version with FSMC is STM32F429.

So could it be that STM32F446 is really not supporting it?

Thread 107 (2022-02-22):

Z2 stepper not responding - Octopus Pro V1.0 - Marlin 2.0.9.3

TheCount2255, 2022-02-22:
Having an issue getting Z2 to respond to M122 command. I have tried a lot of diagnostics on this and can't find a proper solution.

Physical board setup as follows:
Stepper X,Y,Z(1),Z2,E0 are setup in Motor 0-4 plugs.

Marlin setup:
- Conf.h
```
#define X_DRIVER_TYPE  TMC2209
#define Y_DRIVER_TYPE  TMC2209
#define Z_DRIVER_TYPE  TMC2209
#define Z2_DRIVER_TYPE TMC2209
#define E0_DRIVER_TYPE TMC2209
```

-Conf_adv.h
```
//
// For Z set the number of stepper drivers
//
#define NUM_Z_STEPPER_DRIVERS 2   // (1-4) Z options change based on how many

#if NUM_Z_STEPPER_DRIVERS > 1
  // Enable if Z motor direction signals are the opposite of Z1
  //#define INVERT_Z2_VS_Z_DIR
  //#define INVERT_Z3_VS_Z_DIR
  //#define INVERT_Z4_VS_Z_DIR
```

- ...Octopus_V1_common.h (pins file)
```
//
// Steppers
//
#define X_STEP_PIN                          PF13  // MOTOR 0
#define X_DIR_PIN                            PF12
#define X_ENABLE_PIN                     PF14
#ifndef X_CS_PIN
  #define X_CS_PIN                           PC4
#endif

#define Y_STEP_PIN                         PG0   // MOTOR 1
#define Y_DIR_PIN                           PG1
#define Y_ENABLE_PIN                    PF15
#ifndef Y_CS_PIN
  #define Y_CS_PIN                          PD11
#endif

#define Z_STEP_PIN                         PF11  // MOTOR 2
#define Z_DIR_PIN                           PG3
#define Z_ENABLE_PIN                    PG5
#ifndef Z_CS_PIN
  #define Z_CS_PIN                          PC6
#endif

#define Z2_STEP_PIN                       PG4   // MOTOR 3
#define Z2_DIR_PIN                         PC1
#define Z2_ENABLE_PIN                  PA0
#ifndef Z2_CS_PIN
  #define Z2_CS_PIN                        PC7
#endif

#define E0_STEP_PIN                       PF9   // MOTOR 4
#define E0_DIR_PIN                         PF10
#define E0_ENABLE_PIN                  PG2
#ifndef E0_CS_PIN
  #define E0_CS_PIN                         PF2
#endif
```

After hooking the board up to power and usb I send a M122 command and receive the following reply (truncated for brevity)
```
READ: Driver registers:
READ: 		X	0xC0:1F:00:00
READ: 		Y	0xC0:1E:00:00
READ: 		Z	0xC0:1F:00:00
READ: 		Z2	0x00:00:00:00	 Bad response!
READ: 		E	0xC0:1F:00:00
READ:
READ:
READ: Testing X connection... OK
READ: Testing Y connection... OK
READ: Testing Z connection... OK
READ: Testing Z2 connection... Error: All LOW
READ: Testing E connection... OK
```
After this I have tried moving motor 3 stepper to a different location (motor 5-8) on the board with no luck as expected. I tried a different/new stepper driver(s) to see if this was an issue (No change).
Thinking that the plug on the board for the stepper might be dead I changed the ...Common.h pins file to reflect a different location (motor 5) and moved the driver to that location. This yielded the same result as above. The last thing that I tried was reversing the dual Z steppers to just 1:
`#define NUM_Z_STEPPER_DRIVERS 1   // (1-4) Z options change based on how many`
and assigned dual E drivers
`#define EXTRUDERS 2`
and assign the pins from Z2 to E1
```
#define E1_STEP_PIN                         PG4   // MOTOR 5
#define E1_DIR_PIN                          PC1
#define E1_ENABLE_PIN                       PA0
#ifndef E1_CS_PIN
#define E1_CS_PIN                         PC7
#endif
```
 with the following results: (Physical the board is setup to motor 0-2,4-5)
```
READ: Driver registers:
READ: 		X	0xC0:0C:00:00
READ: 		Y	0xC0:0C:00:00
READ: 		Z	0xC0:0C:00:00
READ: 		E	0xC0:0C:00:00
READ: 		E1	0xC0:0C:00:00
READ:
READ:
READ: Testing X connection... OK
READ: Testing Y connection... OK
READ: Testing Z connection... OK
READ: Testing E connection... OK
READ: Testing E1 connection... OK
```
I left the stepper in motor 5 plug reassigned the pins to the normal Z2 pins and got the following error again:
```
READ: 		Z2	0x00:00:00:00	 Bad response!
READ: Testing Z2 connection... Error: All LOW
```

I moved the motor 5 stepper to motor 3 and retested and got the error again.

Things I can safely assume at this point:
- All steppers are working and will report w/ M122
- plugs 0-2,4-5 work w/ steppers plugged in

Things I question:
- Does plug 3 (motor 3) on the board work at? Not sure how to test for this now.
- How/why does using normal Z2 pin definition work on motor 5 when defined as an extruder motor *only*?
- Code issue NOT H/W?

I think* that I can assume that the board is fine, but the motor 3 plug is not addressed correctly/at all. Trying to trace the pins through the code and the automatic pin assignment code is a nightmare for me (not a gooder coder), so would LOVE any and all help.
I'm open to any and all suggestions on a solution (even that I might have a bad board).

ANT-NONIUS, 2022-04-04:
Cleaning driver's pins and sockets with contact cleaner did the trick for me.

kursorlinde, 2022-05-04:
Hi just wanted to tell you i am having the same issue on BTT Octopus Pro V1.0 with TMC2209
tried the same steps as you described with the same results then discovered this thread and the one on reddit

my uneducated guess is that the issue comes from BTT actually paralleling Z0 and Z2 so that "NUM_Z_STEPPER_DRIVERS 1" basically already is equal to 2 however this seems to be a marlin issue after all that you and i have tried, can't think of anything else to try to fix this at this moment.

kursorlinde, 2022-05-07:
looks like i found the mistake for my part
G34 does work now without errors
MOTOR2 ("THE" Z-Axis Driver) simply has two JST connectors -_-
its not "THE" Z2 thats where i made my initial false assumption

if you want to use Z2 for actually having one individual driver for each motor you have to plug your second Z stepper motor plug into the MOTOR3 (DRIVER3) connector not the MOTOR2_2 one ( MOTOR 2_1 and MOTOR2_2 are both using the DRIVER2 (see PINS pdf file from BTT and pins config file in marlin )

if you try to use dual z with MOTOR2_1 and MOTOR2_2 it doesnt work because for marlin it's only one MOTOR and it is missing the second Z motor
also i cleaned the connectors because of what ANT-NONIUS suggested on April 4th and March 31st

Shamoon78, 2022-05-16:
Marlin can use many z many y and many x and many extruders as much as you want limited only by what number of drivers motherboard can offer, Iam not following up for the last year and half and forget marlin compyling but i remember I configured marlin to run 3 z stepper indvidually to level the bed and swap x driver for extruder and vice versa but there is configuration how to assign every driver of motor to certain function ,even i had part fan mosfet died so i configured e1 hotend fan connector to run as part fan( hotend fan is fixed speed fan while part fan is controllable speed fan), I think is id number for certain pin connector that the mcu handle have to be changed to the new function(other pin on the board ), I am trying to refresh my information and will be back to explain when i remember.

Shamoon78, 2022-05-16:
Mcu have many data pin numbers are assigned on the board to certain connectors but you can assign these numbers to different connectors or swap between each others.

Arnie3d, 2023-01-15:
what happend can some give me a good solution to Z2 and Y2 not working but M122 wth Pronterface telling me eveything is ok x,y,y2,z,z2 and e0 read OK but no movementon y2 and z2

badonj001, 2023-03-19:
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

Same here on that second Z-JST connector. Had me scratching my head until I saw your post, lol

Thanks, lol

Thread 108 (2022-02-23):

Unable to connect to octopus pro board

stewcop23, 2022-02-23:
I'm using Octopus pro v1.0, Marlin 2.0.9.3, and windows. I have been successful in uploading firmware but when it comes to connecting the board to my computer (I'm using pronterface) it won't connect. Before you give me the same responses that I've been getting from everyone on the internet.

Yes I have set serial port 2 to be -1
Yes I have tried to update drivers (couldn't really find them though)
Nothing shows up on the device manager

I'm probably doing one small thing wrong, but any help is appreciated

stewcop23, 2022-02-24:
My configuration.h is [Here](https://drive.google.com/file/d/1ARPrd58psREHDHCngPR04Sn8ix2347EH/view?usp=sharing)

Nico4589, 2022-04-15:
I have the same problem

Royalblu, 2022-06-06:
I’ve the same issue. I don’t see a COM port at all in Windows 10 so not selectable in Pronterface. Has anyone resolve this promblem?

BOARD is an Octopus Pro with Marlin 2.1 and 2 x serial ports enabled as follows;

Serial 1 = 1
Serial 2 = -1

Sheridan-Tech, 2022-10-11:
Same issue here

stewcop23, 2022-10-11:
I would recommend contacting BIQU's customer support. There is a significant amount of hoops to jump through, but you may be able to get some sort of refund or discount on your next purchase.

I apparently missed my warranty period and was only able to get 10% off my next purchase, so i encourage you to email them earlier than i did

Sheridan-Tech, 2022-10-11:
With a lot of debugging effort I was able to get it working. Apparently it was throwing a min temp error code that caused it to halt, thus disabling serial. They should really have beep or flash codes to report board errors back to the user.

Ciceronic, 2023-03-11:
> With a lot of debugging effort I was able to get it working. Apparently it was throwing a min temp error code that caused it to halt, thus disabling serial. They should really have beep or flash codes to report board errors back to the user.

Interesting.
I have the same problem, what did you do to solve the temp error code?

Sheridan-Tech, 2023-04-03:
It was too far back for me to remember exactly, but based on my commits
around that time I think it was related to using the wrong
thermistor definition. I am using a PT100, so it was out of the expected
range.

I changed
#define TEMP_SENSOR_0 1
to
#define TEMP_SENSOR_0 -5

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

filsh, 2024-05-15:
Some problem, how to fix it?

looxonline, 2024-05-16:
> Some problem, how to fix it?

This is almost 100% not a hardware issue and rather an issue with your firmware config or the config of the serial link on your communication device. I would recommend asking on a discord group such as the Voron group or on the BTT official facebook group where you will find many who can assist you with the firmware and serial config.

Closed 2024-05-16.

Thread 109 (2022-02-25):

ESP8266, ESP-07S Setup Instructions For Marlin Needed

Aurawin, 2022-02-25:
Can someone point me to the instructions to setup my ESP8266 ESP-07S with my V1.1 board?

WesMcGee68, 2022-07-21:
install of the BTT ESP32 install on Octopus v1.1 needed also....

lukasloetkolben, 2022-09-03:
have you found a way to use  WiFi ESP8266 ESP-07S with the V1.1 board?

lukasloetkolben, 2022-09-04:
Ok ESP3D is working for me.
- Connect the ESP07S to a USB to TTL Adapter:
```
TXD0 -> RX
RXD0 -> TX
VCC -> 3.3V
GND -> GND
RST -> 3.3V
EN -> 3.3V
IO0 -> GND
IO2 -> 3.3V
IO15 -> GND
```

Download VS Code and install PlatformIO compile it and flash it to the ESP07S.
If its not possible to flash with PlatformIO use ESP8266 DOWNLOAD TOOL with this config:
```
CrystalFeq: 24M
SPI SPEED: 40MHz
SPI MODE: QIO
FLASH SIZE: 32Mbit
```

follow the instructions: https://github.com/luc-github/ESP3D

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

Aurawin, 2022-09-04:
The module needs to be flashed before you can use it.  And before you can flash it you need to configure it.  The WiFi is too slow to use for uploading large prints.  Consider all the new options like Manta 4/8P with CB1.

lukasloetkolben, 2022-09-05:
> The module needs to be flashed before you can use it. And before you can flash it you need to configure it. The WiFi is too slow to use for uploading large prints. Consider all the new options like Manta 4/8P with CB1.

The upload is not slow because of the wifi, it is because of the communication between ESP and Marlin.

WesMcGee68, 2022-10-10:
Yes I did get it worked out..

Sent from Mail<https://go.microsoft.com/fwlink/?LinkId=550986> for Windows

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

Erfan017, 2023-09-29:
you can use this for esp32u also
i used arduino uno as a programmer and programmed my esp32u for my octopus pro

Thread 111 (2022-02-28):

Marlin\src\HAL\shared\HAL.cpp - MarlinHAL does not name a type - PlatformIO

NorbertRoller, 2022-02-28:
D:\xxx\Marlin\src\HAL\shared\HAL.cpp

I fixed it by adding a #define in front of it.
The line reads: #define MarlinHAL hal;

Still strange is, that I get this error only on the BIGTREETECH-OCTOPUS-V1.0-master and not on the original Marlin-bugfix-2.0.x

Details: Win10 / German / PlatformIO

gdumont2211, 2022-05-23:
hi, i don't see where i can add the #define, can u help me?

Closed 2022-03-02.

Thread 112 (2022-03-09):

BTT Ocotopus v1.1 - Noctua NF-A6x25 FLX Fan Don't spin!

MihaiCiornei, 2022-03-09:
I recently upgraded the CR-10S with Octopus v1.1., Due to the fact that the old board made the engines make a hell of a noise. Everything is perfect. I also installed some NTC 3950 100 K ohm, to make a fan start when the Stepper Drive Y reaches a temperature of 40, one on the power supply for rasbery Pi, everything works with Noctua NF-A4x20 FLX fans. They turn on and off exactly as they should ... but when I wanted to replace these fans with a Noctua NF-A6x25 FLX, it didn't spin. I'm sure it works, I checked it by replacing the power supply fan. Do you have any idea what the problem is?

This is my cfg:

```
# This file contains common pin mappings for the BigTreeTech Octopus.

# To use this config, the firmware should be compiled for the

# STM32F446 with a "32KiB bootloader" and a "12MHz crystal" clock reference.

# See docs/Config_Reference.md for a description of parameters.

# Driver0

[stepper_x]

step_pin: PF13

dir_pin: !PF12

enable_pin: !PF14

microsteps: 16

rotation_distance: 40

endstop_pin: PG6

position_endstop: 0

position_max: 280

homing_speed: 50

# Driver1

[stepper_y]

step_pin: PG0

dir_pin: !PG1

enable_pin: !PF15

microsteps: 16

rotation_distance: 40

endstop_pin: PG9

position_endstop: 0

position_max: 280

homing_speed: 50

# Driver2

[stepper_z]

step_pin: PF11

dir_pin: PG3

enable_pin: !PG5

microsteps: 16

rotation_distance: 8

endstop_pin: PG10

position_endstop: 0.5

position_max: 300

# Driver4

[extruder]

step_pin: PF9

dir_pin: !PF10

enable_pin: !PG2

microsteps: 16

rotation_distance: 29.7

nozzle_diameter: 0.400

pressure_advance = 0.560

filament_diameter: 1.750

heater_pin: PA2 # HE0

sensor_pin: PF4 # T0

sensor_type: Generic 3950

min_temp: 0

max_temp: 220

[heater_bed]

heater_pin: PA1

sensor_pin: PF3 # TB

sensor_type: Generic 3950

min_temp: 0

max_temp: 130

[fan]

pin: PA8

kick_start_time: 0.5

off_below: 0.10

[heater_fan hotend_fan]

pin: PE5

max_power: 1.0

kick_start_time: 0.5

heater: extruder

heater_temp: 50.0

[temperature_fan fan_Stepper_Drivers_Y]

pin: PD12

max_power: 1.0

sensor_type: Generic 3950

sensor_pin: PF5

min_temp: 0

max_temp: 60

target_temp: 40.0

max_speed: 1.0

min_speed: 0.3

control: watermark

gcode_id: stepper_y

[temperature_fan fan_CASE]

pin: PD13

max_power: 1.0

sensor_type: Generic 3950

sensor_pin: PF6

min_temp: 0

max_temp: 60

target_temp:40.0

max_speed: 1.0

min_speed: 0.3

control: watermark

gcode_id: alim_rasbery

[mcu]

serial: /dev/serial/by-id/usb-Klipper_stm32f446xx_200004000450534E4E313120-if00

[printer]

kinematics: cartesian

max_velocity: 300

max_accel: 3000

max_z_velocity: 5

max_z_accel: 100

########################################

# TMC2209 configuration

########################################

[tmc2209 stepper_x]

uart_pin: PC4

diag_pin: PG6

run_current: 0.800

stealthchop_threshold: 999999

[tmc2209 stepper_y]

uart_pin: PD11

diag_pin: PG9

run_current: 0.800

stealthchop_threshold: 999999

[tmc2209 stepper_z]

uart_pin: PC6

diag_pin: PG10

run_current: 0.650

stealthchop_threshold: 999999

[tmc2209 extruder]

uart_pin: PF2

run_current: 0.800

stealthchop_threshold: 999999

[board_pins]

aliases:

# EXP1 header

EXP1_1=PE8, EXP1_2=PE7,

EXP1_3=PE9, EXP1_4=PE10,

EXP1_5=PE12, EXP1_6=PE13, # Slot in the socket on this side

EXP1_7=PE14, EXP1_8=PE15,

EXP1_9=<GND>, EXP1_10=<5V>,

# EXP2 header

EXP2_1=PA6, EXP2_2=PA5,

EXP2_3=PB1, EXP2_4=PA4,

EXP2_5=PB2, EXP2_6=PA7, # Slot in the socket on this side

EXP2_7=PC15, EXP2_8=<RST>,

EXP2_9=<GND>, EXP2_10=PC5

#*# <---------------------- SAVE_CONFIG ---------------------->

#*# DO NOT EDIT THIS BLOCK OR BELOW. The contents are auto-generated.

#*#

#*# [extruder]

#*# control = pid

#*# pid_kp = 24.604

#*# pid_ki = 1.233

#*# pid_kd = 122.713

#*#

#*# [heater_bed]

#*# control = pid

#*# pid_kp = 71.732

#*# pid_ki = 0.968

#*# pid_kd = 1328.834
```

MihaiCiornei, 2022-03-13:
Rly .... no response :(

Hman32, 2022-04-16:
Did you check the voltage output and the polarity on the fan?
You could try to invert the Gnd/V+ pin from the fan and check if it's the issue.

MihaiCiornei, 2022-04-17:
Thank you very much, I will try, at the first opportunity when I disassemble the printer, it is not a bad idea.

Thread 113 (2022-03-26):

Raspberry 4 configuration settings for UART

giorgakos, 2022-03-26:
Please provide the configuration settings for using UART with Raspberry 4. Current documentation seems to work only for Raspberry 3.

Closed 2022-03-28.

Thread 114 (2022-04-03):

Octopus v1.1 major hardware issue consistent across both boards causing frequent motor malfunctions

zvonka, 2022-04-03:
I have been a fan of BTT products for many years, everything I owned that was BTT before worked flawlessly but after now three seperate boards im realizing there is a grave problem with the board design at a hardware level

thankfully it is something that is very easily fixed!

While this might not fix your motor issues, it worked for all three of my boards after I applied this fix & I've been satisfied since with the performance.

My suspicion is that the stepper driver sockets are slightly too close together, causing somehow voltage to stray from one driver to the next causing all kinds of problems. I put a thin sheet of kapton tape in between each stepper driver before plugging into the socket all the way to isolate them from each other & surprise the motor issues all went away.

Worth a shot if anyone is having problems still, good luck all.

ANT-NONIUS, 2022-04-03:
Hi, having similar problems with steper drivers. Your "theory" has a lot of sense.
I worked around the issue not fully pushing the drivers on the sockets.
I was blamming flux contamination on the sockets. But a closser look, after reading your comment, make me realize that I was putting them at slightly different heights, therefor not making contact between circuits.

ANT-NONIUS, 2022-04-04:
Cleaning all the pins and sockets with contact cleaner did the trick for me.

tanguy-lq, 2022-04-28:
Hi, i can confirm the issue. My drivers were touching eachother and my motors were doing weid stuff. The kapton fix works perfectly.
Many thanks to you zvonka, i was searching for quite a while now !

zvonka, 2022-07-21:
Pin extensions might work but I can imagine there would be some miniscule voltage drop due to additional number of interconnections that electricity would have to travel through.

If you don't have kapton tape, you could easily use just a very thin sheet of card stock. Like index-card paper cut down small enough to fit in between each of the stepper drivers. I have TMC2209 and they never get even warm when printing on my second printer with the same board & I used just a piece of paper on that one instead of kapton tape & it resolved the abnormal movement issues I was having.

CircuitSetup, 2022-08-03:
Interesting. This must be happening because of excessive ESD/crosstalk coming from the drivers. I wonder if the Octopus or step stick pcb's need some more decoupling caps to gnd. Are the wires for the motors physically close to one another? Are they twisted together at all?

In the [tmc2209 datasheet (page 14)](https://www.trinamic.com/fileadmin/assets/Products/ICs_Documents/TMC2209_Datasheet_V103.pdf), it mentions 2 methods for handling ESD. The [step sticks do not have either](https://github.com/bigtreetech/BIGTREETECH-TMC2209-V1.2/blob/master/Schematic/TMC2209-V1.2.pdf). [Nor does the Octopus.](https://github.com/bigtreetech/BIGTREETECH-OCTOPUS-V1.0/blob/master/Hardware/BIGTREETECH%20Octopus.pdf)

Simply grounding the stepper motors individually to DC gnd may have the same effect of discharging ESD.

ArianNasser, 2025-06-27:
Hey I know this thread is old, but do you or anyone have an image of the setup with the tape?

Thread 116 (2022-05-04):

Octopus v1.1 cannot find MCU in Klipper

ROADwarrior82, 2022-05-04:
Board flashed firmware fine. I connected 24v power, and all of the stepper/fan/endstops, and now it will not connect again. I have reflashed, I have remade my RaspPi's os. I have tried every usb port on the pi, I have tried every cable I have. Nothing.

SMTDesigns, 2022-05-04:
I have the same issue. The Octopus USB-C is recognized as a enumerated serial port in klipper (I installed fluiddPi for the os and connections), Of note, the Pi USB-C will not work and enumerate the controller port. The 2.0 and 3.0 ports at least get a port folder created in Pi. The only thing I note is that I get ttyACM0 for the OS port name instead of ttyS0 or ttyAMA0. If I plug the Octopus into a PC, I get a USB serial connection at probably 250000 which I can't get clear messages from (yet).

Thread 117 (2022-05-06):

power led and status led not working, port not shown. help me out of this

titansmu2, 2022-05-06:

titansmu2, 2022-05-06:
Everything looking good, nothing look like burnt. If i try power chip externally power led and status led are working but port not shown. And while powering the chip by external, chip become get hot. Help me out of this problem
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

antwal, 2022-10-16:
i have a similar problem, the card worked smoothly for 15 days, then it died giving me the same problem.

The status led is on but power is always off, it does not work with the USB-C power supply nor with the external power supply.

In the end I checked and it does not deliver 3.3v, but only 5v. In the end I bought a new card hoping it will last longer than the first one

Thread 118 (2022-06-09):

Octopus support for phase angle control of bed heater with 120V mains to eliminate lights flickering Voron 2.4

to-the-nth, 2022-06-09:
The standard Klipper/Octopus bed heater control Voron 2.4 with a zero crossing SSR results in flickering room lights that are on the same wall outlet circuit. In this klipper issues post: https://github.com/Klipper3d/klipper/issues/1641

 a solution is discussed that uses an inexpensive common 3Amp 220V phase control module available on Amazon and Aliexpress that responds to a a pwm input.  The idea is the bed pwm frequency would be increased in the klipper/octopus config and used to drive the phase  control module.  This is a very viable solution for low to medium power bed heaters, below 660W @220V (with a tail wind).  However it is not a universal solution because it doesn't provide sufficient power running on a 120V mains.  Surveying inexpensive modules, the 8Amp and above class offerings have a Zero Crossing Detect/PWM (phased) interface and expect and external controller like an Arduino or RPi.    The Zero Crossing Detect is an input to the external controller and is expected to trigger an interrupt.  The ISR sets a timer to trigger the output PWM at the desired phase angle.

Examples of higher powered modules:  https://www.aliexpress.com/item/2251832615710334.html

A trivial quick and dirty but universal hack would be to add an Arduino or Digispark:
https://www.aliexpress.com/item/2251801854001459.html

to take the existing PWM bed output and ZCD and generate the PWM phase control to the power module.  The cleaner solution is to have Octopus implement the function inputting ZCD and outputting phase PWM based on commanded bed power.

Does Octopus already support power control using ZCD/PWM (phased)?  If not, how big of a deal would it be to support it?

Thoughts?

Thread 120 (2022-06-15):

More problems than its worth!!

Cabinfourus, 2022-06-15:
The firmware BTT provides is not working anymore.
I downloaded the firmware-F446-USB.bin, renamed it to firmware.bin and flashed my Octopus 1.0 board but Klipper keeps telling me I must be running an old version of firmware and I need to reflash my board.
Has Klipper updated their side and BTT didn't?

Cabinfourus, 2022-06-18:
Klipper has been updated. So this means the pre-configured firmware BTT provides in this repository is no longer working.

Hman32, 2022-11-18:
@zvonka what issue did you get with Marlin? I've moved from the BTT 2.0.9 to the official marlin bugfix and got no issue.
Just needed to merge my previous config foles with the new structure/change on Marlin 2.1

Thread 121 (2022-07-17):

how/where to connect hall filament width sensor from klipper

seebaer1976, 2022-07-17:
Hi,
got the octopus v1.1.

now I have recreated the hall filament width sensor([link to hall filament width sensor](https://www.klipper3d.org/Hall_Filament_Width_Sensor.html)) and would like to connect it.
unfortunately I can't find anything to which pins I have to/can connect it.

does anyone have an idea?

Kind regards
mark

DaLiV, 2022-10-31:
You need one/two of ADC-s : PA0-PA7 PB0-PB1 PC0-PC5 PF3-PF10
if not 1284 display - can try take a look on EXP2 -  there is PB1+PA4 /Direct pins/
or on WiFi -> SPI2_MISO SPI2_MOSI = PC2+PC3 /direct pins/
or may be thermal inputs T2/3/4 - if they not used - PF5/6/7 / here not sure about schematic ... /

Thread 122 (2022-07-21):

Octopus v1.1 not responding to usb-c

12Testing3, 2022-07-21:
Im using klipper to run my octopus v1.1.

I updated the firmware and all of sudden the board stopped responding to the raspberry pi. (Was adding additional fan support at the time.) Purchased an st link device and was able to reinstall the bootloader. But the pi will still not communicate with the board, verified the pi will communicate with other boards.

not sure if this has occurred to anyone else but any advice on how to get the board to communicate again would be appreciated.

Thread 123 (2022-07-24):

install of the BTT ESP32 install on Octopus v1.1 needed also....

WesMcGee68, 2022-07-24:
install of the BTT ESP32 install on Octopus v1.1 needed also....

_Originally posted by @WesMcGee68 in https://github.com/bigtreetech/BIGTREETECH-OCTOPUS-V1.0/issues/109#issuecomment-1191590801_

lukasloetkolben, 2022-08-31:
Had you found a way to connect ESP to your Octopus Board?

Hman32, 2022-09-11:
Same for me, I've buy the BTT ESP32U and there's no documentation on how to install it.

lukasloetkolben, 2022-09-11:
> Same for me, I've buy the BTT ESP32U and there's no documentation on how to install it.

I got it working:
https://github.com/bigtreetech/BIGTREETECH-OCTOPUS-V1.0/issues/109#issuecomment-1236359375

Hman32, 2022-09-12:
Hi @lukasloetkolben  could you describe all the step needed to compile and  flash it ?
I've already buy the BTT Writer but I must look how I can connect it to the ESP32
The documentation from BTT is nearly inexistent :(

aaronse, 2023-01-26:
Also trying to get BTT ESP32U module (purchased from BIQU) working on my Octopus v1.1.  This is for my V1 Engineering Lowrider 3 CNC.  More details available at https://forum.v1e.com/t/firmware-for-bigtreetech-esp32u-esp32e-module-for-octopus-or-skr3-skr-3-ez-skr-2/36403

My current plan is to use my ESP01s programmer with bunch of dupont wiring to the ESP32U module based on the ESP-07S pinout, and try to flash ESP3D compiled to ESP32 firmware. Wanted to check in here incase someone’s been down this path already?

Wondering if there's an easier way.  For example I stumbled onto (last update 2022/9/6) https://github.com/bigtreetech/BTT-Expansion-module/blob/master/ESP-WIFI/ESP%20WIFI%20Module%20Instruction.pdf , so maybe there's a way to update ESP32U module firmware via SD card reader on the mother board, Octopus in this case.  Didn't see anything in Octopus User Guide https://github.com/bigtreetech/BIGTREETECH-OCTOPUS-V1.0/blob/master/BIGTREETECH_Octopus_EN_updated_0719.pdf

WesMcGee68, 2023-01-29:
I did get my Esp32 working that same way.  It was fairly easy with platform io

Sent from my iPad

On Jan 25, 2023, at 7:42 PM, aaron GitHub ***@***.***> wrote:

Also trying to get BTT ESP32U module (purchased from BIQU) working on my Octopus v1.1. This is for my V1 Engineering Lowrider 3 CNC. More details available at https://forum.v1e.com/t/firmware-for-bigtreetech-esp32u-esp32e-module-for-octopus-or-skr3-skr-3-ez-skr-2/36403

My current plan is to use my ESP01s programmer with bunch of dupont wiring to the ESP32U module based on the ESP-07S pinout, and try to flash ESP3D compiled to ESP32 firmware. Wanted to check in here incase someone’s been down this path already?

Wondering if there's an easier way. For example I stumbled onto (last update 2022/9/6) https://github.com/bigtreetech/BTT-Expansion-module/blob/master/ESP-WIFI/ESP%20WIFI%20Module%20Instruction.pdf , so maybe there's a way to update ESP32U module firmware via SD card reader on the mother board, Octopus in this case. Didn't see anything in Octopus User Guide https://github.com/bigtreetech/BIGTREETECH-OCTOPUS-V1.0/blob/master/BIGTREETECH_Octopus_EN_updated_0719.pdf

—
Reply to this email directly, view it on GitHub<https://github.com/bigtreetech/BIGTREETECH-OCTOPUS-V1.0/issues/123#issuecomment-1404413510>, or unsubscribe<https://github.com/notifications/unsubscribe-auth/AY3IX6ZPML6LBA7AS7UD42LWUHB7BANCNFSM54QCB6BQ>.
You are receiving this because you were mentioned.Message ID: ***@***.***>

Thread 124 (2022-07-27):

Unable to update Octopus v1 bootloader

dsplendido, 2022-07-27:
Hi, I'm unable to connect to the board and update the bootloader via STM32 programmer, I get the error "no debug probe detected". I'm trying to run Reprap on the octopus and the board chip is STM32F446ZE

12Testing3, 2022-08-05:
did you follow gadgets angels guide?

dsplendido, 2022-08-05:
Not familiar with that, can you post a link? I followed BTT's guide but that left me stuck at the debug probe error. I should preface that I do little to no "programming" per se.

12Testing3, 2022-08-05:
https://github.com/GadgetAngel/BTT_SKR_13_14_14T_SD-DFU-Bootloader/blob/main/bootloader_bin/backed_up_original_bootloaders/Octopus%20V1.1/Guide%20ST-LINK%20Utility%2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

Thread 125 (2022-08-09):

Missing pinout for stepper drivers

Dakkaron, 2022-08-09:
There is no documentation on the pinout of the stepper driver sockets.

This is not an issue for TMC2209 drivers, which have two extra pins, but for TMC2208, A4988 and others, it is a massive issue, since they have a symmetrical physical layout. And putting a stepper driver in the wrong way, will blow up the board and the driver.

The EN pin needs to go to the top left corner (the corner where the two red pin headers meet, opposite from the jumpers).

GND is on the bottom right, next to the jumpers.

Thread 126 (2022-08-10):

BigTreeTech TFT TouchScreen Touchscreen mode possible? Or add that mode please.

Trackhe, 2022-08-10:
BigTreeTech TFT TouchScreen Touchscreen mode possible? Or add that mode please.

When i want to run the BT TFT with my Octopus v1.1 and Klipper i only find to use that with

```
[display]
lcd_type: emulated_st7920
spi_software_miso_pin: PA6
spi_software_mosi_pin: EXP1_3
spi_software_sclk_pin: EXP1_5
en_pin: EXP1_4
encoder_pins: ^EXP2_5, ^EXP2_3
click_pin: ^!EXP1_2

[output_pin beeper]
pin: EXP1_1
```

but this is buggy and ugly. i dont want to send this nice display back and buy another one for the raspberry. for klipperscreen.

So i want a solution to use the touchmode with klipper.

Hman32, 2022-09-11:
Which TFT are you using, the TFT35? there so many at BTT...

Could be the issue is with Klipper:
https://github.com/Klipper3d/klipper/issues/2546

Trackhe, 2022-09-11:
Jea clearly, i m talking about the [BIGTREETECH TFT28 V3.0 & TFT43 V3.0 & TFT50 V3.0 & TFT70 V3.0 Displays](https://biqu.equipment/collections/lcd/products/btt-tft43-v3-0-tft50-v3-0-tft70-v3-0-display-touch-screen-two-working-modes)

Thread 127 (2022-08-14):

Can't compile because the Z-Endstop inverting requires it to be false

FortnitePs5, 2022-08-14:

FortnitePs5, 2022-08-14:
[{
	"resource": "/f:/3d printer/BIGTREETECH-OCTOPUS-V1.0-master/BIGTREETECH-OCTOPUS-V1.0-master/Firmware/Marlin-bugfix-2.0.9.3.x/Marlin/src/inc/Conditionals_LCD.h",
	"owner": "cpp",
	"severity": 8,
	"message": "#error \"BLTOUCH requires Z_MIN_PROBE_ENDSTOP_INVERTING set to false. Please update your Configuration.h file.\"",
	"startLineNumber": 1035,
	"startColumn": 6,
	"endLineNumber": 1035,
	"endColumn": 6
}]

Closed 2022-08-15.

Thread 128 (2022-08-26):

Octopus V1.1 - Z_MULTI_ENDSTOPS - Not working

lukasloetkolben, 2022-08-26:
Hi,
i am trying to configure my Octopus V1.1 with two independent Z-Axis Motors and two Endstops.
I defined these endstops:
```
#define USE_XMAX_PLUG
#define USE_YMAX_PLUG
#define USE_ZMAX_PLUG
#define USE_IMAX_PLUG
```
Drivers:
```
#define X_DRIVER_TYPE  TMC2209
#define Y_DRIVER_TYPE  TMC2209
#define Z_DRIVER_TYPE  TMC2209
#define Z2_DRIVER_TYPE TMC2209
#define E0_DRIVER_TYPE TMC2209
```

And enabled Multi Endstops:
```
#ifdef Z2_DRIVER_TYPE
  #define Z_MULTI_ENDSTOPS          // Other Z axes have their own endstops
  #if ENABLED(Z_MULTI_ENDSTOPS)
    #define Z2_USE_ENDSTOP   _IMAX_   // Z2 endstop board plug. Don't forget to enable USE_*_PLUG.
    #define Z2_ENDSTOP_ADJUSTMENT 0   // Z2 offset relative to Y endstop
  #endif
  [...]
```
  When i am compiling like this M119 does not show the z2_max status.
  If i change `#define Z2_USE_ENDSTOP   _IMAX_` to -> `#define Z2_USE_ENDSTOP   _XMAX_`
  It does show z2_max with M119.

  Can anyone help me with this issue?

Closed 2022-09-03.

Thread 129 (2022-08-30):

No USB Connection possible

cwagenl, 2022-08-30:
I have taken the marlin Firmware from this repository, compiled it with Visual Studio Code and uploaded it via SD card. The firmware file is sucessfully renamed to firmware.cur.

The is not connected to any periphials, except a riprap discount display and a 24v power supply. The power jumper is disconnected, so the board does not start up upon usb connection. There are no steppers installed, but their jumpers are set to the TBC2209 setting.

On my Windows 10 PC, the STM Cube Programmer Software has successfully been installed.

Here comes the issue: If power up the board after the firmware update and plug the board into the PC with the cable delivered with the board, there is no additional COM-port detected. Therefore, I cannot connect to the board. The issue remains in the following scenarios:
- same PC, Board powered up via USB with the power-jumper set and the 24v power supply off
- same PC, Board powered up via USB with the power-jumper disconnected and the 24v power supply off
- same PC, Board powered up via 24v power supply with the power-jumper disconnected and the 24v power supply on
- Different Windows 10 PC w/o the drivers from STM installed, Board powered up via 24v power supply with the power-jumper disconnected and the 24v power supply on

The firmware used is exactly the one distributed here with the configuration.h-file unchanged.

In all cases, no COM-port is being added to the device manager and there is no connection sound when plugging the board in.

Appreciate any help!

Hman32, 2022-09-11:
Did you compiled the enviroment version that end with "btt_USB" ?

mlee12382, 2022-09-20:
Flip the usb C end over 180degrees and try again, also try a different cable.

Patm91, 2022-11-16:
Was this issue ever resolved?

jgbby, 2025-03-05:
^^, would love to know

Thread 131 (2022-09-18):

Raspberry Pi J26 no serial connectivity (Marlin)

westhedge, 2022-09-18:
I have tried everything I can think of, but I cannot get this board to communicate to a Raspberry Pi over the J26 PD5/PD6 pins. I have jumpered them to the GPIO 14/15 pins on the Pi (tx to rx and rx to tx) and I have tried:
#define SERIAL_PORT_3 2
#define BAUDRATE_3 115200

and
#define SERIAL_PORT_3 3

Right now I have SERIAL_PORT -1 (for a USB connection) and SERIAL_PORT_2 1 (for the TFT screen)

But it is not working. What is the correct setting for this or is it just a feature that doesn't work? I can't find any useful information online about this anywhere

westhedge, 2022-09-18:
I discovered my issue.
First: these lines are must be in Marlin:
#define SERIAL_PORT_3 2
#define BAUDRATE_3 115200

Next, you must connect with /dev/TTYAMA0. I had mistakenly connected with with /dev/TTYS0.
The board now works correctly!

Hman32, 2022-10-15:
Thanks for your research and  advice @westhedge

Thread 133 (2022-10-26):

COmpilation issue

DaLiV, 2022-10-26:
# installed stm32duino library
arduino-cli config add board_manager.additional_urls https://github.com/stm32duino/BoardManagerFiles/raw/main/package_stmicroelectronics_index.json
arduino-cli update
arduino-cli core install STMicroelectronics:stm32

# defined build options for Octopus Pro on F429ZGT
STMOPTS='--build-property build.series=STM32F4xx'
STMOPTS+=' --build-property build.product_line=STM32F429xx'
STMOPTS+=' --build-property build.board=GENERIC_F429ZGTX'
STMOPTS+=' --build-property build.variant.path=''/home/user/.arduino15/packages/STMicroelectronics/hardware/stm32/2.3.0/variants/STM32F4xx/F427Z(G-I)T_F429ZET_F429Z(G-I)(T-Y)_F437Z(G-I)T_F439Z(G-I)(T-Y)/'''
STMOPTS+=' --build-property build.variant=''STM32F4xx/F427Z(G-I)T_F429ZET_F429Z(G-I)(T-Y)_F437Z(G-I)T_F439Z(G-I)(T-Y)'''
STMOPTS+=' --build-property build.variant_h=variant_generic.h'
STMOPTS+=' --build-property upload.maximum_size=1048576'
STMOPTS+=' --build-property upload.maximum_data_size=196608'
# starting commpilation
arduino-cli compile -b STMicroelectronics:stm32:GenF4 $STMOPTS --verbose

-------
result :
/home/user/.arduino15/packages/STMicroelectronics/hardware/stm32/2.3.0/cores/arduino/stm32/stm32_def.h:64:17: error: the value of 'SystemCoreClock' is not usable in a constant expression
   64 |   #define F_CPU SystemCoreClock
      |                 ^~~~~~~~~~~~~~~
/home/3d/BTT-Octo/Firmware/Marlin-bugfix-2.0.9.3.x/Marlin/src/HAL/STM32/HAL.cpp:71:27: note: in expansion of macro 'F_CPU'
   71 |   constexpr int cpuFreq = F_CPU;
      |                           ^~~~~
...
/home/user/.arduino15/packages/STMicroelectronics/hardware/stm32/2.3.0/system/Drivers/CMSIS/Device/ST/STM32F4xx/Include/system_stm32f4xx.h:57:17: note: 'uint32_t SystemCoreClock' is not const
   57 | extern uint32_t SystemCoreClock;          /*!< System Clock Frequency (Core Clock) */
      |                 ^~~~~~~~~~~~~~~

==============
at the end sketch is not compiled.

DaLiV, 2022-10-26:
additionaly :
firstly was error about serial port
- commented in "Configuration.h"
// #define SERIAL_PORT_2 -1

other settings at this point was untouched

DaLiV, 2022-10-26:
+ Win version of compilation - same F_CPU issue
compilation command :
D:\3D\arduino-nightly\arduino-builder -dump-prefs -logger=machine -hardware D:\3D\arduino-nightly\hardware -hardware C:\Users\User\AppData\Local\Arduino15\packages -tools D:\3D\arduino-nightly\tools-builder -tools D:\3D\arduino-nightly\hardware\tools\avr -tools C:\Users\User\AppData\Local\Arduino15\packages -built-in-libraries D:\3D\arduino-nightly\libraries -libraries D:\Users\User\Documents\Arduino\libraries -fqbn=STMicroelectronics:stm32:GenF4:pnum=GENERIC_F429ZGTX,upload_method=hidMethod,xserial=generic,usb=CDCgen,xusb=FS,opt=osstd,dbg=none,rtlib=nano -vid-pid=0483_5740 -ide-version=10820 -build-path t:\Temp -warnings=default -build-cache D:\Temp\arduino_cache_572847 -prefs=build.warn_data_percentage=75 -prefs=runtime.tools.CMSIS.path=C:\Users\User\AppData\Local\Arduino15\packages\STMicroelectronics\tools\CMSIS\5.7.0 -prefs=runtime.tools.CMSIS-5.7.0.path=C:\Users\User\AppData\Local\Arduino15\packages\STMicroelectronics\tools\CMSIS\5.7.0 -prefs=runtime.tools.xpack-arm-none-eabi-gcc.path=C:\Users\User\AppData\Local\Arduino15\packages\STMicroelectronics\tools\xpack-arm-none-eabi-gcc\10.3.1-2.3 -prefs=runtime.tools.xpack-arm-none-eabi-gcc-10.3.1-2.3.path=C:\Users\User\AppData\Local\Arduino15\packages\STMicroelectronics\tools\xpack-arm-none-eabi-gcc\10.3.1-2.3 -prefs=runtime.tools.STM32Tools.path=C:\Users\User\AppData\Local\Arduino15\packages\STMicroelectronics\tools\STM32Tools\2.1.1 -prefs=runtime.tools.STM32Tools-2.1.1.path=C:\Users\User\AppData\Local\Arduino15\packages\STMicroelectronics\tools\STM32Tools\2.1.1 -verbose D:\3D\Marlin\Marlin-BTT\Marlin\Marlin.ino
D:\3D\arduino-nightly\arduino-builder -compile -logger=machine -hardware D:\3D\arduino-nightly\hardware -hardware C:\Users\User\AppData\Local\Arduino15\packages -tools D:\3D\arduino-nightly\tools-builder -tools D:\3D\arduino-nightly\hardware\tools\avr -tools C:\Users\User\AppData\Local\Arduino15\packages -built-in-libraries D:\3D\arduino-nightly\libraries -libraries D:\Users\User\Documents\Arduino\libraries -fqbn=STMicroelectronics:stm32:GenF4:pnum=GENERIC_F429ZGTX,upload_method=hidMethod,xserial=generic,usb=CDCgen,xusb=FS,opt=osstd,dbg=none,rtlib=nano -vid-pid=0483_5740 -ide-version=10820 -build-path t:\Temp -warnings=default -build-cache D:\Temp\arduino_cache_572847 -prefs=build.warn_data_percentage=75 -prefs=runtime.tools.CMSIS.path=C:\Users\User\AppData\Local\Arduino15\packages\STMicroelectronics\tools\CMSIS\5.7.0 -prefs=runtime.tools.CMSIS-5.7.0.path=C:\Users\User\AppData\Local\Arduino15\packages\STMicroelectronics\tools\CMSIS\5.7.0 -prefs=runtime.tools.xpack-arm-none-eabi-gcc.path=C:\Users\User\AppData\Local\Arduino15\packages\STMicroelectronics\tools\xpack-arm-none-eabi-gcc\10.3.1-2.3 -prefs=runtime.tools.xpack-arm-none-eabi-gcc-10.3.1-2.3.path=C:\Users\User\AppData\Local\Arduino15\packages\STMicroelectronics\tools\xpack-arm-none-eabi-gcc\10.3.1-2.3 -prefs=runtime.tools.STM32Tools.path=C:\Users\User\AppData\Local\Arduino15\packages\STMicroelectronics\tools\STM32Tools\2.1.1 -prefs=runtime.tools.STM32Tools-2.1.1.path=C:\Users\User\AppData\Local\Arduino15\packages\STMicroelectronics\tools\STM32Tools\2.1.1 -verbose D:\3D\Marlin\Marlin-BTT\Marlin\Marlin.ino

Result:

In file included from D:\3D\Marlin\Marlin-BTT\Marlin\src\MarlinCore.cpp:33:
D:\3D\Marlin\Marlin-BTT\Marlin\src\MarlinCore.cpp: In function 'void minkill(bool)':
D:\3D\Marlin\Marlin-BTT\Marlin\src\HAL\shared\Delay.h:103:50: error: expected primary-expression before ')' token
  103 |   #define DELAY_US(x) DelayCycleFnc((x) * ((F_CPU) / 1000000UL))
      |                                                  ^
D:\3D\Marlin\Marlin-BTT\Marlin\src\MarlinCore.cpp:920:28: note: in expansion of macro 'DELAY_US'
  920 |   for (int i = 1000; i--;) DELAY_US(600);
      |                            ^~~~~~~~
D:\3D\Marlin\Marlin-BTT\Marlin\src\HAL\shared\Delay.h:103:50: error: expected primary-expression before ')' token
  103 |   #define DELAY_US(x) DelayCycleFnc((x) * ((F_CPU) / 1000000UL))
      |                                                  ^
D:\3D\Marlin\Marlin-BTT\Marlin\src\MarlinCore.cpp:925:28: note: in expansion of macro 'DELAY_US'
  925 |   for (int i = 1000; i--;) DELAY_US(250);
      |                            ^~~~~~~~

GrossoRoberto, 2023-02-05:
Hi did you get some new result ?  i'm in the same point

DaLiV, 2023-02-06:
i'm ended up onto platformio (also moved all compilations to the linux box) ...
+ can say - big plus on "pio" is next : no each time full recompile for every support library

Thread 134 (2022-10-30):

Maximum Heater Wattage

serenewaffles, 2022-10-30:
I am using the Octopus v1.1 board.

What is the maximum wattage I can supply to a single heater (not the bed heater)? Will I be able to run a 70W heater cartridge on my extruder?

Is there also a known maximum total heater wattage (not counting the bed heater)?

Thanks in advance!

radek8, 2022-11-05:
Look in the diagram for the switching element used.
The source is also quite important. The 24 V power supply will have 2 times more power for 12V.

Thread 137 (2022-12-07):

Octopus Pro 429 Thermistor problem

reinharm1959, 2022-12-07:
Octopus pro thermistors are not recording proper temperature nor does the temp change when heating bed, etc. The same thermistors type works perfectly on the original MCU (rambo 1.4).

Thread 138 (2022-12-13):

Add 128Kib bootloader for STM32H723 board

trevor-pfeil, 2022-12-13:
I am trying to reflash the bootloader for an Octopus Pro V1.0 with the STM32H723 chip. The files in this repo only contain 32Kib bootloaders for STM32F446, STM32F429, and STM32F407. There is no bootloader.hex file for the STM32H723 chip so it should be added to increase support for this processor

Raymond3D, 2023-08-19:
Did you ever get the bootloader for the STM32H723?

Seem to have messed up my board

trevor-pfeil, 2023-09-05:
Yeah - they added it to the bootloader folder
https://github.com/bigtreetech/BIGTREETECH-OCTOPUS-V1.0/tree/master/Firmware/DFU%20Update%20bootloader/bootloader

Closed 2022-12-15.

Thread 139 (2022-12-18):

missing documentation for Pro variant

power-max, 2022-12-18:
The arrangement of the connectors and the pinouts are different between the base model and the pro model. most of the documentation on this repository appears to be for the base model and not the pro model, making it difficult to identify what is what on the pro model and forcing me to make some assumptions of how things were shuffled about.

power-max, 2022-12-18:
I'm dumb and I didn't see there indeed was a separate repository for the pro variant! 🤦 A link to it in the this vastly more popular repo would be helpful, since [this](https://github.com/bigtreetech/BIGTREETECH-OCTOPUS-Pro) one gets lost in the noise.

maxholgasson, 2023-02-22:
Thanks I was looking for the same. Indeen the documentation is so important for a product and hope it will be improved soon

Thread 140 (2022-12-22):

Octoboard 1 407 bootlader

Ct87, 2022-12-22:
Hello

I have put on canboot on the octoboard. But canbus is not working right . So I want to put stock bootloader on but I have not copied the Orginal . Can you send me ?

Closed 2022-12-22.

Thread 141 (2023-01-12):

Problems with Octopus v1.1

ctra0031, 2023-01-12:
Hi, I have several problems going on with the Octopus v1.1 board:

1. When I try to restart the board with a new firmware.bin by pressing the restart button, nothing happens.

- I tried powering up the board with both external power supply and via the USB-C port.
- The LEDs indicating board power (top left red LED) and microSD Card plugged in (right blue LED) are on with no flashing.
- I tried with both 32GB and 16GB microSD (FAT32) but there's no difference.

2. When I connect the board with a TFT50 v3.0.1 LCD Screen, it works normally with the reset wire not plugged in, but once I use the reset wire, the whole screen black out.

- With 4 wires plugged in, only the GND -> Reset on the TFT side shorts, with 5 wires, the GND -> Reset on the Octopus side shorts as well.
- I notice that there's a continuity on GND -> 5V (and the other pins -> 5V as well), but not in reverse, not sure if this is a diode behaviour or there's something wrong.

3. When I connect with a stepper motor, the motor is locked and I can't rotate it. I've tried manually turning the shaft, using the LCD board, and on pronterface, but no luck at all.

All of these has been tested on another Octopus v1.1 board (which is not available to me) and no problem occurs. Is there a bug I can fix by myself or is it simply a broken board? Any help would be much appreciated. Thanks.

aingez, 2023-05-22:
Hi, is there any solution . I'm having the same problem as your first one.

Arnie3d, 2023-12-12:
I have the same and it doesn't look like there are any solutions....why ?

bigblocknova454, 2023-12-26:
exact same issue. connect the BTT mini 12864 display board wont boot/install firmware/enter dfu mode nada. unplug display works fine for all the things. Cannot for the life of me figure out what is causing this.

Thread 142 (2023-01-13):

Idex system not homing 2nd extruder

polamoros, 2023-01-13:
Hello!

I've been setting up a Sigma r19 with an octopus motherboard.

Everything is working properly except the homing of the second extruder (X2), which is not moving to the homing position, causing an offset when printing with both extruders. (Both working properly while printing).

Not sure if I have something wrong with the configuration files or if there is a bug..

Any help will be appreciated!

[Archive.zip](https://github.com/bigtreetech/BIGTREETECH-OCTOPUS-V1.0/files/10409803/Archive.zip)

Thread 143 (2023-01-29):

E0 Motor4 non functional

HillDweller117, 2023-01-29:
I’m running the latest marlin with an octopus v1.1. I have two z steppers on motors 2 and 3 and e0 is set to 4. Everything works perfectly except that I cannot get e0 to move, I have tried setting DISABLE_INACTIVE_E to false and swapping the e0/e1 pins but neither have fixed it. Motor and wires are both functional so not sure if it’s a board hardware issue or if I’m missing something.

Djonker83, 2023-04-23:
I had trouble with the E0 as well and spent much time learning to use marlin autobuild and building from the 2.1.x branch instead of bugfix branch that is provided by BTT and finally got it working, however my issue appeared to be a simple mistake of using motor 3 port not knowing the configs i started with used 2 Z axis motors (plus one parallel Z in hardware) and simply  skipping motor 3 might have been the solution, I am now second guessing that after reading this. Perhaps changing branch may help you like me. To be thorough I would suggest double checking your configured UART or SPI pins and jumpers for your drivers.

Thread 145 (2023-03-18):

Flashing bootloader and firmware after MCU replacement

Ancharas, 2023-03-18:
Hello!

My MCU died a heroic death after short circuit to 5 V. I replaced it to the same model (STM32F446ZET6). I flashed  bootloader as desribed here: https://github.com/bigtreetech/BIGTREETECH-OCTOPUS-V1.0/tree/master/Firmware/DFU%20Update%20bootloader

After this I used my SD card (2 GB, FAT32) to flash firmware. But the file firmware.bin didn't rename to firmware.cur, and my PC didn't define my Octopus board as COM-port.

Later I found a complete image with bootloader and firmware here: https://github.com/GadgetAngel/BTT_SKR_13_14_14T_SD-DFU-Bootloader/tree/main/bootloader_bin/backed_up_original_bootloaders/Octopus%20V1.1/Bootloader_and_Firmware

After flashing the same way my board was defined as COM-port, and started answer to Gcode commands. E.g., answer to M115:

_>>> M115
SENDING:M115
FIRMWARE_NAME:Marlin bugfix-2.0.x (May 13 2021 14:16:08) SOURCE_CODE_URL:github.com/MarlinFirmware/Marlin PROTOCOL_VERSION:1.0 MACHINE_TYPE:OCTOPUS_V1_0 EXTRUDER_COUNT:4 UUID:cede2a2f-41a2-4748-9b12-c55c62f367ff
..._

But I still have no possibility to flash firmware via SD card. I checked wiring to MCU and short circuits between MCU pins - it's OK. Also I can see a blue indicator flashes up when I insert SD card. I used anothes SD card with no result.

Here is M20 answer:

_>>> M20
SENDING:M20
echo:No media_

I saw the Status indicator is blinking after power up on some videos, but it shines constantly on my board.

So I have two questions:
1) How can I fix bootloader?
2) How can I flash firmware without SD card?

Thread 146 (2023-03-31):

Can't establish a serial communication

lucaguida39, 2023-03-31:
Hi, i'm trying to establish a serial communication with the board but, when i connect to my computer using the usb-c cable, the board is not seen. (I use arduino IDE to send commands and no port is shown).
The firmware is Marlin and i have this settings for serial communication:

#define SERIAL_PORT -1
#define BAUDRATE 115200

#define SERIAL_PORT_2 1
#define BAUDRATE_2 115200

How can i solve the problem?

cameronsocialhardware, 2023-06-01:
Did you solve this issue as I'm also facing the same problem. Thanks.

Lorenzo1205, 2023-06-19:
having the same issue ... GRRRRrrr
Now about one week constantly compiling en testing...
Nothing works....

lucaguida39, 2023-07-05:
>

Didn't solve, I'm sorry

Thread 147 (2023-04-01):

Bl touch sensor not triggering when Z homing

mikedattolo, 2023-04-01:
Hi, I recently bought a BL touch sensor AE5YK v3.1 and connected it to my BTT octopus using the dedicated BL touch sensor slot (J43 on pin diagram) and made sure that I have z homing enabled with probe and Z_min_probe_pin set to PB7, however, when I go and home it doesn't trigger at all, and I have to stop it before it can ram into the bed, please help me

PZrk73, 2023-04-02:
You have and BL touch, and end-stop Z sensor? PB7 -- used to  BL touch sensor. If I understand you correctly, you must or disconnect end-stop Z sensor, or connect it to other pin.

FREAKASAS, 2024-04-22:
same issue

Thread 148 (2023-04-02):

Octopus 1.1 won't flash firmware

TamyraT, 2023-04-02:
I've been trying for days now, it says FIRMWARE.CUR on the card. though I click the button on the screen to go to Marlin and there's NOTHING there. I placed the usb in the card, I've connected it to my computer with the usbc cord, the first few times my PC didn't recognize it. then Magically it finally found it about the 10th time. I can control the printer motors with Pronterface.  the screen still tells me there's no printer attached. What am I missing? how do I get the printer to be recognized by the card?

TamyraT, 2023-04-02:
I should add, I move the firmware.bin to the card and put it in and it comes out saying FIRMWARE.CUR, I also am not getting it to say that now. and I'm not getting the flashing status light, only the blue light, a green light and a red light.

Thread 149 (2023-04-24):

octopus v1.1 cant control heater independently

rds11080, 2023-04-24:
when i turn on heater 2 using "M42 P26 S255" if also turn on heater 0 ("P2"), same as turn on heater 3 also turn on heater 1 ("P3"), im using marlin firmware bug fix
when i turn on heater 0 or heater 1, "it not turn on heater 2 or 3"
anyone know how to fix this issues?

Thread 151 (2023-07-14):

Stock firmware for octopus pro v1.1 does not compile

ElfyShort, 2023-07-14:
I am trying to compile stock firmware for octopus pro v1.1 in Platformio.
Getting the error:
'PinMap_SD' was not declared in this scope; did you mean 'PinMap_USB'?

Clean Marlin 2.1.2.1 compiles on my setup with no problem.

Any help will be appreciated!

Here is the full build log:

Compiling .pio\build\STM32H723Zx_btt\src\src\HAL\STM32\sdio.cpp.o
Marlin\src\HAL\STM32\sdio.cpp: In function 'void HAL_SD_MspInit(SD_HandleTypeDef*)':
Marlin\src\HAL\STM32\sdio.cpp:91:26: error: 'PinMap_SD' was not declared in this scope; did you mean 'PinMap_USB'?
   91 |     pinmap_pinout(PC_12, PinMap_SD);
      |                          ^~~~~~~~~
      |                          PinMap_USB
Compiling .pio\build\STM32H723Zx_btt\src\src\inc\Warnings.cpp.o
Marlin\src\inc\Warnings.cpp:724:6: warning: #warning "Motherboard DIAG jumpers must be removed when SENSORLESS_HOMING is disabled. (Define DIAG_JUMPERS_REMOVED to suppress this warning.)" [-Wcpp]
  724 |     #warning "Motherboard DIAG jumpers must be removed when SENSORLESS_HOMING is disabled. (Define DIAG_JUMPERS_REMOVED to suppress this warning.)"
      |      ^~~~~~~
*** [.pio\build\STM32H723Zx_btt\src\src\HAL\STM32\sdio.cpp.o] Error 1

ruturajshinde, 2023-11-04:
hey, @ElfyShort, were you able to find a solution for this one. I'm facing similar issue and need to compile it for one of my machine. based of 723H

dblatt87, 2024-01-03:
Same problem here, is there a known workaround?

dblatt87, 2024-01-08:
Hello
I try to use a BTT Octopus Pro V1.1 with the STM32H723Z.
I spend hours in back-tracing and also other platform versions in the STM32H723Zx.ini but unfortunately I'm shot out of ideas.
Any help would be very appreciated.

Here the build logs, normal and in verbose mode:
[build_log.txt](https://github.com/bigtreetech/BIGTREETECH-OCTOPUS-V1.0/files/13861121/build_log.txt)
[build_log-v.txt](https://github.com/bigtreetech/BIGTREETECH-OCTOPUS-V1.0/files/13861123/build_log-v.txt)

Developer-Expsol, 2024-09-29:
Hello
I got a workaround this error.
You have to add the below line
extern const PinMap PinMap_SD[];
after "//*** SD ***", in the following file
.platformio\packages\framework-arduinoststm32\libraries\SrcWrapper\inc\PeripheralPins.h

After this change, the firmware get compiled without error, but there is still one problem, the onbaord SD card adapter does not read SD card.

I was able to update the firmware using onboard SD card adapter, but cannot read gcode files from it.
When I use M20, I get the below response

12:34:23.165 : N19 M20*41
12:34:23.165 : echo:No media

Thread 152 (2023-07-23):

Marlin Fails to Auto-Build in Visual Studio

SmokinPete55, 2023-07-23:
This is what I get. I have been working on this since May and still no resolution. I get my screen to update but it does not recognize my motherboard at all. TFT35 E3 V3.0 screen and Octopus V1.1

PS C:\BigTreeTech\Motherboard\BIGTREETECH-OCTOPUS-V1.0\Firmware\Marlin-bugfix-2.0.9.3.x> echo "done" >"C:\Users\gr8rs\AppData\Local\Temp\ipc"
PS C:\BigTreeTech\Motherboard\BIGTREETECH-OCTOPUS-V1.0\Firmware\Marlin-bugfix-2.0.9.3.x> platformio run --target clean --silent -e STM32F407ZE_btt_USB
Warning! Ignore unknown configuration option `monitor_flags` in section [env]
Warning! `src_filter` configuration option in section [env:include_tree] is deprecated and will be removed in the next release! Please use `build_src_filter` instead
Warning! `src_filter` configuration option in section [env:DUE] is deprecated and will be removed in the next release! Please use `build_src_filter` instead
Warning! `src_filter` configuration option in section [env:esp32] is deprecated and will be removed in the next release! Please use `build_src_filter` instead
Warning! `src_build_flags` configuration option in section [env:linux_native] is deprecated and will be removed in the next release! Please use `build_src_flags` instead
Warning! `src_filter` configuration option in section [env:linux_native] is deprecated and will be removed in the next release! Please use `build_src_filter` instead
Warning! `src_build_flags` configuration option in section [env:simulator_windows] is deprecated and will be removed in the next release! Please use `build_src_flags` instead
Warning! `src_filter` configuration option in section [env:SAMD51_grandcentral_m4] is deprecated and will be removed in the next release! Please use `build_src_filter` instead
Warning! `src_filter` configuration option in section [env:malyan_M300] is deprecated and will be removed in the next release! Please use `build_src_filter` instead
Warning! `src_filter` configuration option in section [env:STM32F103CB_malyan] is deprecated and will be removed in the next release! Please use `build_src_filter` instead
Warning! `src_filter` configuration option in section [env:teensy31] is deprecated and will be removed in the next release! Please use `build_src_filter` instead
Warning! `src_filter` configuration option in section [env:teensy35] is deprecated and will be removed in the next release! Please use `build_src_filter` instead
Warning! `src_filter` configuration option in section [env:teensy36] is deprecated and will be removed in the next release! Please use `build_src_filter` instead
Warning! `src_filter` configuration option in section [env:teensy41] is deprecated and will be removed in the next release! Please use `build_src_filter` instead
PS C:\BigTreeTech\Motherboard\BIGTREETECH-OCTOPUS-V1.0\Firmware\Marlin-bugfix-2.0.9.3.x> echo "done" >"C:\Users\gr8rs\AppData\Local\Temp\ipc"
PS C:\BigTreeTech\Motherboard\BIGTREETECH-OCTOPUS-V1.0\Firmware\Marlin-bugfix-2.0.9.3.x> platformio run --silent -e STM32F407ZE_btt
Warning! Ignore unknown configuration option `monitor_flags` in section [env]
Warning! `src_filter` configuration option in section [env:include_tree] is deprecated and will be removed in the next release! Please use `build_src_filter` instead
Warning! `src_filter` configuration option in section [env:DUE] is deprecated and will be removed in the next release! Please use `build_src_filter` instead
Warning! `src_filter` configuration option in section [env:esp32] is deprecated and will be removed in the next release! Please use `build_src_filter` instead
Warning! `src_build_flags` configuration option in section [env:linux_native] is deprecated and will be removed in the next release! Please use `build_src_flags` instead
Warning! `src_filter` configuration option in section [env:linux_native] is deprecated and will be removed in the next release! Please use `build_src_filter` instead
Warning! `src_build_flags` configuration option in section [env:simulator_windows] is deprecated and will be removed in the next release! Please use `build_src_flags` instead
Warning! `src_filter` configuration option in section [env:SAMD51_grandcentral_m4] is deprecated and will be removed in the next release! Please use `build_src_filter` instead
Warning! `src_filter` configuration option in section [env:malyan_M300] is deprecated and will be removed in the next release! Please use `build_src_filter` instead
Warning! `src_filter` configuration option in section [env:STM32F103CB_malyan] is deprecated and will be removed in the next release! Please use `build_src_filter` instead
Warning! `src_filter` configuration option in section [env:teensy31] is deprecated and will be removed in the next release! Please use `build_src_filter` instead
Warning! `src_filter` configuration option in section [env:teensy35] is deprecated and will be removed in the next release! Please use `build_src_filter` instead
Warning! `src_filter` configuration option in section [env:teensy36] is deprecated and will be removed in the next release! Please use `build_src_filter` instead
Warning! `src_filter` configuration option in section [env:teensy41] is deprecated and will be removed in the next release! Please use `build_src_filter` instead
In file included from Marlin\src\HAL\STM32\../../inc/MarlinConfigPre.h:39,
                 from Marlin\src\HAL\STM32\HAL_MinSerial.cpp:27:
Marlin\src\HAL\STM32\../../inc/../../Configuration.h:2002: warning: "PREHEAT_1_LABEL" redefined
 2002 | #define PREHEAT_1_LABEL       "TPU"
      |
Marlin\src\HAL\STM32\../../inc/../../Configuration.h:1996: note: this is the location of the previous definition
 1996 | #define PREHEAT_1_LABEL       "PLA"
      |
Marlin\src\HAL\STM32\../../inc/../../Configuration.h:2003: warning: "PREHEAT_1_TEMP_HOTEND" redefined
 2003 | #define PREHEAT_1_TEMP_HOTEND 270
      |
Marlin\src\HAL\STM32\../../inc/../../Configuration.h:1997: note: this is the location of the previous definition
 1997 | #define PREHEAT_1_TEMP_HOTEND 230
      |
Marlin\src\HAL\STM32\HAL_SPI.cpp:137:3: warning: "/*" within comment [-Wcomment]
  137 |   /**
      |
Marlin\src\HAL\STM32\HAL_SPI.cpp:149:19: error: missing binary operator before token "("
  149 |     #if PIN_EXISTS(SD_SS)
      |                   ^
Marlin\src\HAL\STM32\HAL_SPI.cpp:155:16: error: variable or field 'spiInit' declared void
  155 |   void spiInit(uint8_t spiRate) {
      |                ^~~~~~~
Marlin\src\HAL\STM32\HAL_SPI.cpp:155:16: error: 'uint8_t' was not declared in this scope
Marlin\src\HAL\STM32\HAL_SPI.cpp:184:3: error: 'uint8_t' does not name a type
  184 |   uint8_t spiRec() {
      |   ^~~~~~~
Marlin\src\HAL\STM32\HAL_SPI.cpp:198:16: error: variable or field 'spiRead' declared void
  198 |   void spiRead(uint8_t *buf, uint16_t nbyte) {
      |                ^~~~~~~
Marlin\src\HAL\STM32\HAL_SPI.cpp:198:16: error: 'uint8_t' was not declared in this scope
Marlin\src\HAL\STM32\HAL_SPI.cpp:198:25: error: 'buf' was not declared in this scope
  198 |   void spiRead(uint8_t *buf, uint16_t nbyte) {
      |                         ^~~
Marlin\src\HAL\STM32\HAL_SPI.cpp:198:30: error: 'uint16_t' was not declared in this scope
  198 |   void spiRead(uint8_t *buf, uint16_t nbyte) {
      |                              ^~~~~~~~
Marlin\src\HAL\STM32\HAL_SPI.cpp:211:16: error: variable or field 'spiSend' declared void
  211 |   void spiSend(uint8_t b) {
      |                ^~~~~~~
Marlin\src\HAL\STM32\HAL_SPI.cpp:211:16: error: 'uint8_t' was not declared in this scope
Marlin\src\HAL\STM32\HAL_SPI.cpp:223:21: error: variable or field 'spiSendBlock' declared void
  223 |   void spiSendBlock(uint8_t token, const uint8_t *buf) {
      |                     ^~~~~~~
Marlin\src\HAL\STM32\HAL_SPI.cpp:223:21: error: 'uint8_t' was not declared in this scope
Marlin\src\HAL\STM32\HAL_SPI.cpp:223:36: error: expected primary-expression before 'const'
  223 |   void spiSendBlock(uint8_t token, const uint8_t *buf) {
      |                                    ^~~~~
Marlin\src\HAL\STM32\HAL_SPI.cpp:232:3: error: expected unqualified-id before '/' token
  232 |  */
      |   ^
In file included from Marlin\src\HAL\STM32\../../inc/MarlinConfigPre.h:39,
                 from Marlin\src\HAL\STM32\../../inc/MarlinConfig.h:28,
                 from Marlin\src\HAL\STM32\MarlinSerial.cpp:27:
Marlin\src\HAL\STM32\../../inc/../../Configuration.h:2002: warning: "PREHEAT_1_LABEL" redefined
 2002 | #define PREHEAT_1_LABEL       "TPU"
      |
Marlin\src\HAL\STM32\../../inc/../../Configuration.h:1996: note: this is the location of the previous definition
 1996 | #define PREHEAT_1_LABEL       "PLA"
      |
Marlin\src\HAL\STM32\../../inc/../../Configuration.h:2003: warning: "PREHEAT_1_TEMP_HOTEND" redefined
 2003 | #define PREHEAT_1_TEMP_HOTEND 270
      |
Marlin\src\HAL\STM32\../../inc/../../Configuration.h:1997: note: this is the location of the previous definition
 1997 | #define PREHEAT_1_TEMP_HOTEND 230
      |
*** [.pio\build\STM32F407ZE_btt\src\src\HAL\STM32\HAL_SPI.cpp.o] Error 1
In file included from Marlin\src\HAL\STM32\../../inc/MarlinConfigPre.h:39,
                 from Marlin\src\HAL\STM32\../../inc/MarlinConfig.h:28,
                 from Marlin\src\HAL\STM32\Servo.cpp:27:
Marlin\src\HAL\STM32\../../inc/../../Configuration.h:2002: warning: "PREHEAT_1_LABEL" redefined
 2002 | #define PREHEAT_1_LABEL       "TPU"
      |
Marlin\src\HAL\STM32\../../inc/../../Configuration.h:1996: note: this is the location of the previous definition
 1996 | #define PREHEAT_1_LABEL       "PLA"
      |
Marlin\src\HAL\STM32\../../inc/../../Configuration.h:2003: warning: "PREHEAT_1_TEMP_HOTEND" redefined
 2003 | #define PREHEAT_1_TEMP_HOTEND 270
      |
Marlin\src\HAL\STM32\../../inc/../../Configuration.h:1997: note: this is the location of the previous definition
 1997 | #define PREHEAT_1_TEMP_HOTEND 230
      |
In file included from Marlin\src\HAL\STM32\../../inc/MarlinConfigPre.h:39,
                 from Marlin\src\HAL\STM32\../../inc/MarlinConfig.h:28,
                 from Marlin\src\HAL\STM32\eeprom_bl24cxx.cpp:32:
Marlin\src\HAL\STM32\../../inc/../../Configuration.h:2002: warning: "PREHEAT_1_LABEL" redefined
 2002 | #define PREHEAT_1_LABEL       "TPU"
      |
Marlin\src\HAL\STM32\../../inc/../../Configuration.h:1996: note: this is the location of the previous definition
 1996 | #define PREHEAT_1_LABEL       "PLA"
      |
Marlin\src\HAL\STM32\../../inc/../../Configuration.h:2003: warning: "PREHEAT_1_TEMP_HOTEND" redefined
 2003 | #define PREHEAT_1_TEMP_HOTEND 270
      |
Marlin\src\HAL\STM32\../../inc/../../Configuration.h:1997: note: this is the location of the previous definition
 1997 | #define PREHEAT_1_TEMP_HOTEND 230
      |
In file included from Marlin\src\HAL\STM32\../../inc/MarlinConfigPre.h:39,
                 from Marlin\src\HAL\STM32\../../inc/MarlinConfig.h:28,
                 from Marlin\src\HAL\STM32\eeprom_if_iic.cpp:32:
Marlin\src\HAL\STM32\../../inc/../../Configuration.h:2002: warning: "PREHEAT_1_LABEL" redefined
 2002 | #define PREHEAT_1_LABEL       "TPU"
      |
Marlin\src\HAL\STM32\../../inc/../../Configuration.h:1996: note: this is the location of the previous definition
 1996 | #define PREHEAT_1_LABEL       "PLA"
      |
Marlin\src\HAL\STM32\../../inc/../../Configuration.h:2003: warning: "PREHEAT_1_TEMP_HOTEND" redefined
 2003 | #define PREHEAT_1_TEMP_HOTEND 270
      |
Marlin\src\HAL\STM32\../../inc/../../Configuration.h:1997: note: this is the location of the previous definition
 1997 | #define PREHEAT_1_TEMP_HOTEND 230
      |
In file included from Marlin\src\HAL\STM32\../../inc/MarlinConfigPre.h:39,
                 from Marlin\src\HAL\STM32\../../inc/MarlinConfig.h:28,
                 from Marlin\src\HAL\STM32\eeprom_flash.cpp:27:
Marlin\src\HAL\STM32\../../inc/../../Configuration.h:2002: warning: "PREHEAT_1_LABEL" redefined
 2002 | #define PREHEAT_1_LABEL       "TPU"
      |
Marlin\src\HAL\STM32\../../inc/../../Configuration.h:1996: note: this is the location of the previous definition
 1996 | #define PREHEAT_1_LABEL       "PLA"
      |
Marlin\src\HAL\STM32\../../inc/../../Configuration.h:2003: warning: "PREHEAT_1_TEMP_HOTEND" redefined
 2003 | #define PREHEAT_1_TEMP_HOTEND 270
      |
Marlin\src\HAL\STM32\../../inc/../../Configuration.h:1997: note: this is the location of the previous definition
 1997 | #define PREHEAT_1_TEMP_HOTEND 230
      |
In file included from Marlin\src\HAL\STM32\../../inc/MarlinConfigPre.h:39,
                 from Marlin\src\HAL\STM32\MarlinSerial.h:24,
                 from Marlin\src\HAL\STM32\HAL.h:34,
                 from Marlin\src\HAL\STM32\HAL.cpp:27:
Marlin\src\HAL\STM32\../../inc/../../Configuration.h:2002: warning: "PREHEAT_1_LABEL" redefined
 2002 | #define PREHEAT_1_LABEL       "TPU"
      |
Marlin\src\HAL\STM32\../../inc/../../Configuration.h:1996: note: this is the location of the previous definition
 1996 | #define PREHEAT_1_LABEL       "PLA"
      |
Marlin\src\HAL\STM32\../../inc/../../Configuration.h:2003: warning: "PREHEAT_1_TEMP_HOTEND" redefined
 2003 | #define PREHEAT_1_TEMP_HOTEND 270
      |
Marlin\src\HAL\STM32\../../inc/../../Configuration.h:1997: note: this is the location of the previous definition
 1997 | #define PREHEAT_1_TEMP_HOTEND 230
      |
=============================================================================================== [FAILED] Took 25.83 seconds ===============================================================================================

Environment      Status    Duration
---------------  --------  ------------
STM32F407ZE_btt  FAILED    00:00:25.835
========================================================================================== 1 failed, 0 succeeded in 00:00:25.835 ==========================================================================================

Thread 153 (2023-09-27):

No connection over usb-c ant uart

Afrem444, 2023-09-27:
I have the problem that i want to set up an octopus v1.1 with klipper and I wont get a response from the board. When Inster the firmware.bin with the micro-sd  and take it out again the file changed to FIRMWARE.cur.

Please help Marlon

Drake143Jack, 2023-10-04:
same issue here
firmware changes to FIRMWARE.cur but octoprint reports "mcu 'mcu': Unable to connect"
tried DFU mode flashing too, but didn't help either

PZrk73, 2023-10-04:
In most cases you was not correctly defined port in configuration of klipper. Or it was not set correctly in the firmware settings.
In firmware it must "Communication interface (USB (on PA11/PA12))" for usb-c for STM32F429.
In config printer.cfg for my system it "serial: /dev/serial/by-id/usb-Klipper_stm32f429xx_XXXXXXXXXXXXXXXXXXXXXXXX-XXXX"
FIRMWARE.cut -- it means all right flashed.

Drake143Jack, 2023-10-04:
lsusb correctly shows "Bus 001 Device 003: ID 1d50:614e OpenMoko, Inc. stm32f446xx"
but "ls /dev/serial/by-id/*" says "ls: cannot access '/dev/serial/by-id/*': No such file or directory"

PZrk73, 2023-10-04:
look at "ls /dev" with and without a connected device and compare. maybe there will be. when connected as COM, it was defined as /dev/ttyS0 or something like that...

Drake143Jack, 2023-10-04:
> look at "ls /dev" with and without a connected device and compare. maybe there will be. when connected as COM, it was defined as /dev/ttyS0 or something like that...

yes /dev/ttyACM0 showed up
added that instead to klipper printer config serial port

and the solution for me was that i had added the wrong user to the dialout and tty groups and hence weren't able to access the serial

thanks for your help

PZrk73, 2023-10-04:
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

Oh, yeah... I forgot about the rights to dialout. I have already encountered this, but I forgot. But I was glad to help find the right way to solve the problem.

Thread 154 (2023-10-07):

BTT Octopus v1.1BLtouch J43

Jarewa, 2023-10-07:
Is it only me who has this problem of poor design? optoisolation LE357C.  In tests it receives
`probe accuracy results: maximum 0.046484, minimum -0.431641, range 0.478125, average -0.148594, median -0.144531, standard deviation 0.147996`

And it's not a mechanical fault or a damaged sensor, but a poorly designed optocoupler. Because if I use a different pin (PB7 - PG12), the results are fantastic.

How to repair to obtain good optocoupler times?

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

Jarewa, 2023-10-12:
I'll answer it myself, maybe it will be useful to someone. PB7 There isn't pullup, that's why it floats because the sensors are too small pullup BLtouch/CRtouch. The solution to the problem was simple, just make a jumper in J40 (set J38 5V) jumper DC-PB7. It causes pullup 3.3V R187 on PB7.

The results now are very satisfactory

Thread 156 (2023-10-11):

help needed, to make work accelerometer on SPI3

Escrich, 2023-10-11:
Dear all, this is my Klipper, printer.cfg configuration for my Octopus v1.1 referring input shaping:

[adxl345]
cs_pin: PA15
spi_bus: spi3

[resonance_tester]
accel_chip: adxl345
probe_points:
    110,110,100

And everytime I try to make an adjustment, I get this message:

Invalid adxl345 id (got 79 vs e5). This is generally indicative of connection problems (e.g. faulty wiring) or a faulty adxl345 chip.

But I bet the chip is totally operative, I´m using the Creality sensor for Sonic pad, anyway, my connections are as follows, using connector J74, named SPI3, I'm using those connections:

1  GND
2  3v3
3  MISO (SDO)
4  MOSI (SDA)
5  SCK (SCL, SCLK)
6  CS

Am I doing something wrong?

PZrk73, 2023-10-12:
May be very long wires? Try to connect short wires and what massage it will give.

Thread 157 (2023-10-20):

Robotics

YeetParry, 2023-10-20:
I am trying to use my V1.1 bot for a robotics project, what should I do in order to install the firmware into the board? Thanks

PZrk73, 2023-10-21:
> I am trying to use my V1.1 bot for a robotics project, what should I do in order to install the firmware into the board? Thanks

The same as for the 3D-printer: rename you firmware file to "firmware.bin", write it to SD-card, put it SD-card to slot on your board and press reset button. LEDs blink few times and after a few seconds all be done.

YeetParry, 2023-10-23:
What environment can I write the code in? I am not planning to use
Marlin/Klipper for this project, does the board support custom codes?
Thanks

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

JannikWilhelm, 2024-12-08:
I recently found a way to program it with arduino-code using PlatformIO:
https://github.com/maxgerhardt/nucleo-f446ze-with-arduino

Thread 158 (2023-12-03):

Manual doesn't actually tell you how to set STEP/DIR mode

spyderdyne, 2023-12-03:
[The manual](https://github.com/bigtreetech/BIGTREETECH-OCTOPUS-V1.0/blob/master/BIGTREETECH_Octopus_EN_updated_0719.pdf) shows how to set UART and SPI modes, but offers no clue how one would go about setting STEP/DIR mode for a driver like the TMC2208, for example.

It offers a handy table that doesn't show what the results mean, vaguely discusses the caveats of STEP/DIR mode, but never actually tells the user how to set the mode.

usama0300854, 2024-02-10:
u need to put jumper on all bottom sides.. just skip the first row.

Thread 159 (2023-12-20):

Issue with communication in UART mode (more than 4 TMC2209 drivers)

Coatl1987, 2023-12-20:
Good evening.

Apologies if the topic has been resolved already but I couldn't find anything regarding my issue.

I'm building a robotic arm based on MOVEO open source project but with 6 axis control (plus extruder) and want to use it as a 3d printer. It's a project for my engineer degree. For my project I'm using TMC2209 drivers with Octopus v1.1 board and marlin version from BTT Octopus GitHub as Kipper didn't work for more than 3 axes.

Managed to add all axes to marlin software so I'm able to move each of them separately but sensor less homing isn't working and I think what's the issue.

As marlin introduced by BTT can setup up to 4 drivers on one port in #define n_SLAVE section and the software requires a port for each driver on LOW I can't communicate with all drivers.

Got some solutions but none of the ones that I found worked for me.

Can anyone let me know either how to solve communication error or how to setup 3 additional drivers for axis I, J and K so they will use the stallguard setting as well.

Much appreciate any advice on this.

Thread 161 (2024-01-06):

more than 2 Z-Endstops not homing with Marlin on Octopus 1.1

tu77, 2024-01-06:
recently I did upgrade my DIY CoreXY Printer with a 3rd Z axis.

i figured that all 3 motors are functioning correctly and all end switches get triggered as supposed.

I don't use a Z-Probe, the Print bed gets leveled on 3 points by the 3 Z-dives (that was the plan)

The Behavior:

- all 3 axis are moving normal before homing,
- X and Y axis home normally
- If I home the Z axis, all 3 axis are moving towards the end switches as usually
- the switches get triggered and the print bed gets even leveled (this is visible)
- Z moves away form the switches a bit and moves than back to the trigger point witch is usually the "0"
- in this moment the printer gets halted "Homing Failed" "Printer halted. kill"

at the moment I downgraded to 2 Z axis again.. very disappointing ..
With 2 Z Axis it`s working fine.

attached you find the configuration files..

My setup:
BTT Octopus 1.1 + TFT50

TMC2208 drivers for Z + Extr.
TMC2209 drivers for X+Y
Marlin 2.1.2.1 same problem with Latest 2.1.x with Hotfixes
no Z-Probe, no BLtouch
each Z motor has its own driver and are moving freely

the major changes i made for the 3rd Z axis:
Configuration.h.:
_#define Z3_DRIVER_TYPE TMC2208      // 3. Z Achse
#define USE_XMAX_PLUG_
#define USE_YMAX_PLUG_

Configuration_adv.h:
_#define Z_MULTI_ENDSTOPS_

pins_BTT_OCTOPUS_V1_common.h:
_#define FIL_RUNOUT_PIN                      PG14
//#define FIL_RUNOUT2_PIN                     PG13
//#define FIL_RUNOUT3_PIN                     PG14
#define FIL_RUNOUT4_PIN                     PG15_

Conclusion:
The homing works correctly but if the Z Axis moves to the Z"0" after homing something strange happens

[Configuration.h.txt](https://github.com/bigtreetech/BIGTREETECH-OCTOPUS-V1.0/files/13849128/Configuration.h.txt)
[Configuration_adv.h.txt](https://github.com/bigtreetech/BIGTREETECH-OCTOPUS-V1.0/files/13849129/Configuration_adv.h.txt)
[pins_BTT_OCTOPUS_V1_common.h.txt](https://github.com/bigtreetech/BIGTREETECH-OCTOPUS-V1.0/files/13849130/pins_BTT_OCTOPUS_V1_common.h.txt)

Thread 163 (2024-02-10):

BIGTREETECH Octopus - SCH.pdf NO U6 chip mentioned

usama0300854, 2024-02-10:
please tell us which ic is U6..

SwiftingSpeed, 2024-04-25:
It's a typo, U6 on the board/pin layout is called U5 in the schematics. You can tell by the surrounding components such as L9 and C105.
U5/U6 is the 5V DC-DC converter, SY8368AQQC.

Thread 165 (2024-04-22):

Driver drv8825 plugged in the wrong way, board defective?

Skippydi, 2024-04-22:
I accidentally plugged the drv8825 driver into my Octopus V1.1 board the wrong way round. Now the board is neither recognized via USB nor can I flash it. What could be wrong? Shouldn't the board be able to withstand something like that?

Daneild, 2024-05-07:
I have the same board, there are some fuses on it, check them.  Also, try and use the jumper to be powered on from usb and do not connect the power to it. Hope it will help..somehow.

looxonline, 2024-05-13:
> Hi Daneild, i have all Fußes checked, all are OK . Jumper on powered in USB has No effect.I don't know why such a small problem can cause such a serious error. Even a request to BTT was ignored. For me, BTT has extremely bad hardwareVon meinem/meiner Galaxy gesendet -------- Ursprüngliche Nachricht --------Von: Daneild ***@***.***> Datum: 07.05.24 23:35 (GMT+03:00) An: "bigtreetech/BIGTREETECH-OCTOPUS-V1.0" ***@***.***> Cc: Skippydi ***@***.***>, Author ***@***.***> Betreff: Re: [bigtreetech/BIGTREETECH-OCTOPUS-V1.0] Driver drv8825 plugged in the wrong way, board defective? (Issue #165) I have the same board, there are some fuses on it, check them. Also, try and use the jumper to be powered on from usb and do not connect the power to it. Hope it will help..somehow. —Reply to this email directly, view it on GitHub, or unsubscribe.You are receiving this because you authored the thread.Message ID: ***@***.***>

Unfortunately this sort of error connection is difficult to protect against and does indeed cause damage to the motherboard. We included protection against in in earlier motherboards but it unfortunately can cause other issues due to increased resistance in the ground path. Our solution was to introduce the EZ range of drivers which completely prevent incorrectly inserting the drivers by keying them. You will struggle to find any motherboard on the market that uses stepstick drivers and can effectively protect against reverse insertion.

Closed 2024-05-13.

Thread 166 (2024-05-23):

Board Not Connecting to COM Port

filsh, 2024-05-23:
I am experiencing an issue with my board. After several firmware flashes with Marlin, the board no longer connects to the COM port on my Windows PC. I have tried various solutions, including updating the bootloader and installing firmware from the official repository, but the board still is not recognized by my computer.
Could you please assist me in resolving this issue?

Motherboard: BIGTREETECH Octopus PRO V1.0 (Octopus Pro-F429)

Thread 167 (2024-05-25):

A small mistake on electronic drawings

Escrich, 2024-05-25:
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

The symbol PWR-DET has been wrongly used at PROBE input.

Thread 169 (2024-08-24):

cannot flash firmware.bin and cannot update bootloader?

spikar85, 2024-08-24:
I’m reaching out for assistance with my BTT Octopus Board. I’ve been encountering some issues flashing the firmware.

Specifically:

When attempting to flash firmware.bin via the SD card, the file does not seem to change to FIRMWARE.CUR.

A suggestion from an online forum indicated that this might be related to the bootloader.

I followed the steps outlined in the DFU update guide to update the bootloader (link: [DFU Update Bootloader Guide](https://github.com/bigtreetech/BIGTREETECH-OCTOPUS-V1.0/blob/master/Firmware/DFU%20Update%20bootloader/Octopus-DFU%20Update%20bootloader%20-%20en.pdf)). However, I am now unable to establish a connection via USB-C. Despite trying multiple USB cables and ports, I keep receiving a "No DFU Detected" error.

Could you provide guidance on the following:

• Any troubleshooting steps for the "No DFU Detected" issue?
• Possible reasons why the firmware is not switching to FIRMWARE.CUR?
![Uploading PXL_20240823_235137970.MP.jpg…]()

takemeplaces, 2025-01-08:
I have had the exact same issue twice now. I started with an F446 and now a H7 pro. Was able to flash the bootloader from Bigtreetechs Github for this. still showed usb port correctly. flashed firmware via sd card. nothing changed and no change from Bin to CUR. flashed via STM Programmer and now am unable to comm to the card entirely.

Thread 170 (2024-10-10):

Octopus HE0 PIN discrepancy?

DevlshOne, 2024-10-10:
I believe there is an error on the PIN diagram here https://github.com/bigtreetech/BIGTREETECH-OCTOPUS-V1.0/blob/master/Hardware/BIGTREETECH%20Octopus%20-%20PIN.pdf where it says that HE0 is PA2.  It seems this might be PA0.

Thanks

Thread 172 (2024-11-18):

Steppers getting mixed up

Roboter32, 2024-11-18:
My printer is an old custom bedslinger, that I'm trying to upgrade  with the Octopus  1.1. So after flashing the firmware I created a printer.cfg based on the one from the Voron 2.4.
I made sure multiple times that all the pins and everything else is configured correctly.

I was using this image as the pinout reference: https://teamgloomy.github.io/images/btt_octopus_1.1_pins.png

The stepsticks are alle inserted into the first 5 slots from the left of the board in the following order:
Z1, Z0, Y, X, E

The models of stepsticks are:
2x Lerdge TMC 2225 1.0 for the Z axes
2x MKS TMC 2225 1.0 for X and Y
TMC 2209 BTT? - the pins are black-yellow rater than black-red but the layot is the same

All the jumpers under those 5 slots are set to uart mode

The issues:

When I try to home X the extruder motor moves. when I manually press the endstop it "homes" and then i can move the E motor with the X axis controls in Mainsail.

When I try to home Y both the X and Y motors move in the negative direction as if the printer was configured as a CoreXY (It's not)

Z homing works in step/dir mode only, the stepsticks are from Lerdge so could work after adding the connection for the RX pins

Otherwise the issues persist in step/dir mode

my printer.cfg:

[include mainsail.cfg]

# This file contains common pin mappings for the BigTreeTech OctoPus V1.
# To use this config, the firmware should be compiled for the STM32F446 with a "32KiB bootloader"
# Enable "extra low-level configuration options" and select the "12MHz crystal" as clock reference

# after running "make", copy the generated "klipper/out/klipper.bin" file to a
# file named "firmware.bin" on an SD card and then restart the OctoPus with that SD card.

# See docs/Config_Reference.md for a description of parameters.

[mcu]
##	[X in MOTOR0] - B Motor
##	[Y in MOTOR1] - A Motor
##	[E in MOTOR6] - Extruder
##	Obtain definition by "ls -l /dev/serial/by-id/" then unplug to verify
##--------------------------------------------------------------------
serial: /dev/serial/by-id/usb-Klipper_stm32f446xx_2F0008000650534E4E313120-if00
#restart_method: command
##--------------------------------------------------------------------

#####################################################################
# 	X/Y Stepper Settings
#####################################################################

## X Stepper on MOTOR3
[stepper_x]
step_pin: PG4
dir_pin: !PC1
enable_pin: !PA0
rotation_distance: 40
microsteps: 16
full_steps_per_rotation:200  #set to 400 for 0.9 degree stepper
endstop_pin: ^PG6
position_min: 0
##--------------------------------------------------------------------

position_endstop: 0
position_max: 200

##--------------------------------------------------------------------
homing_speed: 25   #Max 100
homing_retract_dist: 5
homing_positive_dir: false

#[tmc2208 stepper_x]
#uart_pin: PC7
#interpolate: True
#run_current: 0.8
#sense_resistor: 0.110

## Y Stepper on MOTOR2
[stepper_y]
step_pin: PF11
dir_pin: PG3
enable_pin: !PG5
rotation_distance: 40
microsteps: 16
full_steps_per_rotation:200  #set to 400 for 0.9 degree stepper
endstop_pin: ^PG9
position_min: 0
##--------------------------------------------------------------------

position_endstop: 0
position_max: 160

##--------------------------------------------------------------------
homing_speed: 25  #Max 100
homing_retract_dist: 5
homing_positive_dir: false

#[tmc2208 stepper_y]
#uart_pin: PC6
#interpolate: True
#run_current: 0.8
#sense_resistor: 0.110

#####################################################################
# 	Z Stepper Settings
#####################################################################

## Z0 Stepper - Left - on MOTOR1
[stepper_z]
step_pin: PG0
dir_pin: !PG1
enable_pin: !PF15
microsteps: 16
rotation_distance: 8
endstop_pin: PG10
position_endstop: 0
position_max: 260
homing_speed: 5

#[tmc2208 stepper_z]
#uart_pin: PD11
#run_current: 0.8
#sense_resistor: 0.110

##	Z1 Stepper - Right - on MOTOR0
[stepper_z1]
step_pin: PF13
dir_pin: !PF12
enable_pin: !PF14
microsteps: 16
rotation_distance: 8
endstop_pin: PG11

#[tmc2208 stepper_z1]
#uart_pin: PC4
#run_current: 0.8
#sense_resistor: 0.110

#####################################################################
# 	Extruder
#####################################################################

#	E0 on MOTOR4
[extruder]
step_pin: PF9
dir_pin: PF10
enable_pin: !PG2
##	Update value below when you perform extruder calibration
##	If you ask for 100mm of filament, but in reality it is 98mm:
##	rotation_distance = <previous_rotation_distance> * <actual_extrude_distance> / 100
##  22.6789511 is a good starting point
rotation_distance: 22.6789511	#Bondtech 5mm Drive Gears
microsteps: 16
full_steps_per_rotation: 200	#200 for 1.8 degree, 400 for 0.9 degree
nozzle_diameter: 0.400
filament_diameter: 1.75
heater_pin: PA2
##	Validate the following thermistor type to make sure it is correct
sensor_type: EPCOS 100K B57560G104F
sensor_pin: PF4
min_temp: 10
max_temp: 270
max_power: 1.0
min_extrude_temp: 170
control = pid
pid_kp = 26.213
pid_ki = 1.304
pid_kd = 131.721
##	Try to keep pressure_advance below 1.0
pressure_advance: 0.05
##	Default is 0.040, leave stock
pressure_advance_smooth_time: 0.040

#[tmc2209 extruder]
#uart_pin: PF2
#uart_address: 0
#interpolate: True
#run_current: 0.8
#sense_resistor: 0.110

[printer]
kinematics: cartesian
max_velocity: 300
max_accel: 3000    			#Max 4000
max_z_velocity: 15 			#Max 15 for 12V TMC Drivers, can increase for 24V
max_z_accel: 350
square_corner_velocity: 5.0

#####################################################################
# 	Bed Heater
#####################################################################

[heater_bed]
##	SSR Pin - BED_OUT
heater_pin: PA1
sensor_type: EPCOS 100K B57560G104F
sensor_pin: PF3
##	Adjust Max Power so your heater doesn't warp your bed
max_power: 0.6
min_temp: 0
max_temp: 120
control: pid
pid_kp: 58.437
pid_ki: 2.347
pid_kd: 363.769

#####################################################################
# 	Fan Control
#####################################################################

[fan]
##	Print Cooling Fan - CNC_FAN0
pin: PA8
kick_start_time: 0.5
##	Depending on your fan, you may need to increase this value
##	if your fan will not start. Can change cycle_time (increase)
##	if your fan is not able to slow down effectively
off_below: 0.10

[heater_fan hotend_fan]
##	Hotend Fan - CNC_FAN1
pin: PE5
max_power: 1.0
kick_start_time: 0.5
heater: extruder
heater_temp: 50.0
##	If you are experiencing back flow, you can reduce fan_speed
#fan_speed: 1.0

#[heater_fan exhaust_fan]
##	Exhaust fan - CNC_FAN3
#pin: PD13
#max_power: 1.0
#shutdown_speed: 0.0
#kick_start_time: 5.0
#heater: heater_bed
#heater_temp: 60
#fan_speed: 1.0

#####################################################################
# 	LED Control
#####################################################################

#[output_pin caselight]
# Chamber Lighting - HE1 Connector (Optional)
#pin: PA3
#pwm:true
#shutdown_value: 0
#value:1
#cycle_time: 0.01

#####################################################################
# 	Homing and Gantry Adjustment Routines
#####################################################################

[idle_timeout]
timeout: 1800

########################################
# EXP1 / EXP2 (display) pins
########################################

[board_pins]
aliases:
    # EXP1 header
    EXP1_1=PE8, EXP1_2=PE7,
    EXP1_3=PE9, EXP1_4=PE10,
    EXP1_5=PE12, EXP1_6=PE13,    # Slot in the socket on this side
    EXP1_7=PE14, EXP1_8=PE15,
    EXP1_9=<GND>, EXP1_10=<5V>,

    # EXP2 header
    EXP2_1=PA6, EXP2_2=PA5,
    EXP2_3=PB1, EXP2_4=PA4,
    EXP2_5=PB2, EXP2_6=PA7,      # Slot in the socket on this side
    EXP2_7=PC15, EXP2_8=<RST>,
    EXP2_9=<GND>, EXP2_10=<5V>

#####################################################################
# 	Displays
#####################################################################

## 	Uncomment the display that you have
#--------------------------------------------------------------------

#[display]
##	RepRapDiscount 128x64 Full Graphic Smart Controller
#lcd_type: st7920
#cs_pin: EXP1_4
#sclk_pin: EXP1_5
#sid_pin: EXP1_3
#menu_timeout: 40
#encoder_pins: ^EXP2_5, ^EXP2_3
#click_pin: ^!EXP1_2

#[output_pin beeper]
#pin: EXP1_1

#--------------------------------------------------------------------

#[display]
##	mini12864 LCD Display
#lcd_type: uc1701
#cs_pin: EXP1_3
#a0_pin: EXP1_4
#rst_pin: EXP1_5
#encoder_pins: ^EXP2_5, ^EXP2_3
#click_pin: ^!EXP1_2
#contrast: 63
#spi_software_miso_pin: EXP2_1
#spi_software_mosi_pin: EXP2_6
#spi_software_sclk_pin: EXP2_2

#[neopixel btt_mini12864]
##	To control Neopixel RGB in mini12864 display
#pin: EXP1_6
#chain_count: 3
#initial_RED: 0.1
#initial_GREEN: 0.5
#initial_BLUE: 0.0
#color_order: RGB

##	Set RGB values on boot up for each Neopixel.
##	Index 1 = display, Index 2 and 3 = Knob
#[delayed_gcode setdisplayneopixel]
#initial_duration: 1
#gcode:
#        SET_LED LED=btt_mini12864 RED=1 GREEN=1 BLUE=1 INDEX=1 TRANSMIT=0
#        SET_LED LED=btt_mini12864 RED=1 GREEN=0 BLUE=0 INDEX=2 TRANSMIT=0
#        SET_LED LED=btt_mini12864 RED=1 GREEN=0 BLUE=0 INDEX=3

#--------------------------------------------------------------------

#####################################################################
# 	Macros
#####################################################################

## 	Thermistor Types
##   "EPCOS 100K B57560G104F"
##   "ATC Semitec 104GT-2"
##   "NTC 100K beta 3950"
##   "Honeywell 100K 135-104LAG-J01"
##   "NTC 100K MGB18-104F39050L32" (Keenovo Heater Pad)
##   "AD595"
##   "PT100 INA826"

Roboter32, 2024-11-30:
I just realised that there is one more motor connector than there are stepstick sockets. The X and Y motors were connected to the one driver with two connectors and the E motor was plugged into the actual X driver.

Closed 2024-11-30.

Thread 173 (2024-12-07):

motors not moving

pl96andy, 2024-12-07:
Hi
i am trying to set up marlin on Octopus 1.1 with TMC2209 motor drivers over uart
and for some reason motors seems like does not receive power
Extruder driver even not responds:
M122 :
`Driver registers:
		X	0xC0:0C:00:00
		Y	0xC0:0C:00:00
		Z	0xC0:0C:00:00
		E	0x00:00:00:00	 Bad response!
Testing X connection... OK
Testing Y connection... OK
Testing Z connection... OK
Testing E connection... Error: All LOW`

I turned off input shaping in hope that this causes problem but no success
i have board connected also to external power (not only USB)
I changed order of drivers but extruder still did not respond
For now i have only connected endstops and motors
Endstops when not connected and not pressed has state open

Maybye my board is just faulty? Or i messed up config?

Those are my config files (i changed extension from .h to .txt):
[Configuration_adv.txt](https://github.com/user-attachments/files/18050123/Configuration_adv.txt)
[Configuration.txt](https://github.com/user-attachments/files/18050124/Configuration.txt)

Thank you in advance

Thread 174 (2024-12-09):

Octopus Pro V1.0  Difference between STM32F429GT6 and STM32F446ZET6

motoyasu-atsumi, 2024-12-09:
Hi
My F429 has failed and I would like to replace the F446 board as is.
Will it work just by replacing the Marlin 2.1 without any changes?

The main differences are control frequency (F446:180MHz F429:168MHz), external crystal generator (F446:12MHz F429 8MHz),
Flash memory size (F446:512K F429 1MB)

Thread 176 (2025-03-23):

Minimal firmware.bin using platformIO for Octopus 1.1

unrealwill, 2025-03-23:
I succeeded to flash Marlin on my octopus 1.1 board, by copying the generated firmware.bin to the SD card, where it automatically gets renamed to FIRMWARE.cur and it works with pronterface.

I am new to platformIO.

My board is an Octopus 1.1, with a STM32F446ZET6 chip.

I am now trying to blink the on board LED, which according to the schematic is on PA_13.

I tried https://github.com/maxgerhardt/nucleo-f446ze-with-arduino/tree/main and selecting octopus or octopus_min environment in platformIO environment selector.

It generates a firmware.bin successfully, which I copy to the SD card where it automatically gets renamed to FIRMWARE.cur, so I think the flashing is occurring successfully, but the LED doesn't blink.

**Could you to create a minimal boilerplate so that people can use their board with custom firmware more easily ?**

I spent all afternoon yesterday battling with build flags, and configuration, doing SD uploads, but without success.

I have not yet tried the DFU upload procedure, and would rather not, as I don't want to have to play with jumpers for every upload, and don't want to brick my board which can currently load Marlin.

Thanks

PS:
I have searched the internet a lot to solve this issue, and I'm not the only one facing this issue. I can't understand the logic of selling an open-source board, but not providing the bare minimum to get started with custom code, please forgive me I must be missing something.

futurexdesign, 2025-03-31:
@unrealwill Please try this: https://github.com/futurexdesign/Octopus_Minimal

I have been using this board for awhile with platform.io, so i put this together to hopefully get you bootstrapped.   There was a bunch of odd stuff around the custom variant and board definition to get it to work correctly with pio.  That stuff should all be in that sample project for you.

It will build a firmware.bin that will work with the stock BTT supplied boot loader if you but it on a card and boot it.

unrealwill, 2025-03-31:
@futurexdesign Thanks a lot ! 👍 👍 👍

I had to fix three minor problems to your code to make it work :

This line  ` pinMode(LED,` FAN_OUTPUT);` was wrong (see https://www.arduino.cc/reference/fr/language/functions/digital-io/pinmode/ ), which was making the code crashed. But the device was still detected on USB.

The LEDPIN on my device is PA13 and not PD13.

I also added a counter to check that the delay function wait the correct time, and it works fine :) counting to 50 in 25s.

Add to platformio.ini :
`monitor_speed = 115200`

```
#include <Arduino.h>
#define LEDPIN                            PA13

bool LED = false;

void setup() {
    Serial.begin(115200);
    pinMode(LEDPIN, OUTPUT);
    Serial.println("Hello From Octopus");
}
int co = 0;

void loop() {

    Serial.println("Hello From Octopus");
    Serial.println( co );
    co++;
    digitalWrite(LEDPIN, LED);
    LED = !LED;

    delay(500);
}
```

futurexdesign, 2025-03-31:
Glad it helped.  I through that together in like 3 minutes, sorry I goofed it up.  Could you make an MR back to the example repo?

Good luck with your project!

Thread 177 (2025-05-01):

[OCTOPUS 1.1] Temp sensor configuration

djdjocker, 2025-05-01:
Hello,

I'm configuring a new board with Marlyn 2.1.2 and a 12v power supply.

According to my old motherboard settings a use number 5 value for sensor 0.

When I run a PID Auto-tune Marlyn measured until 105°C and Stop with the following error :

Error:Heating failed, system stopped! Heater_ID: E0

Before eating the sensor got a résistance of 104kohms with ambiant temp of 24°C

After : 600ohms with 200°C measured with an external sensor.

What don't have I correctly configurer ?

What can I do to solve my problem ?

Thread 179 (2025-07-11):

Schematic Errata - U8, U15

louisrousseau, 2025-07-11:
The package and model information for the two 5V to 3.3V voltage regulators in the schematic is incorrect:

U8 is an AMS1117 regulator in a SOT223-3L package
U15 is an AP2127 regulator in a SOT23-5 package

Thread 180 (2025-07-21):

Homing x and z

Thijsnieuwenhuijs, 2025-07-21:
Hi there, I have a small issue when homing my printer. After the X-axis hits the endstop, it suddenly moves forward at high speed. I want the X-axis to stop immediately after triggering the endstop. The Z-axis behaves correctly, and I made the same changes for both axes. Hopefully someone can help me with this!
