bigtreetech/BIGTREETECH-OCTOPUS-V1.0/Hardware/BIGTREETECH Octopus - SIZE.pdf

# ART FILM - TOP_SIZE

# MOTOR0

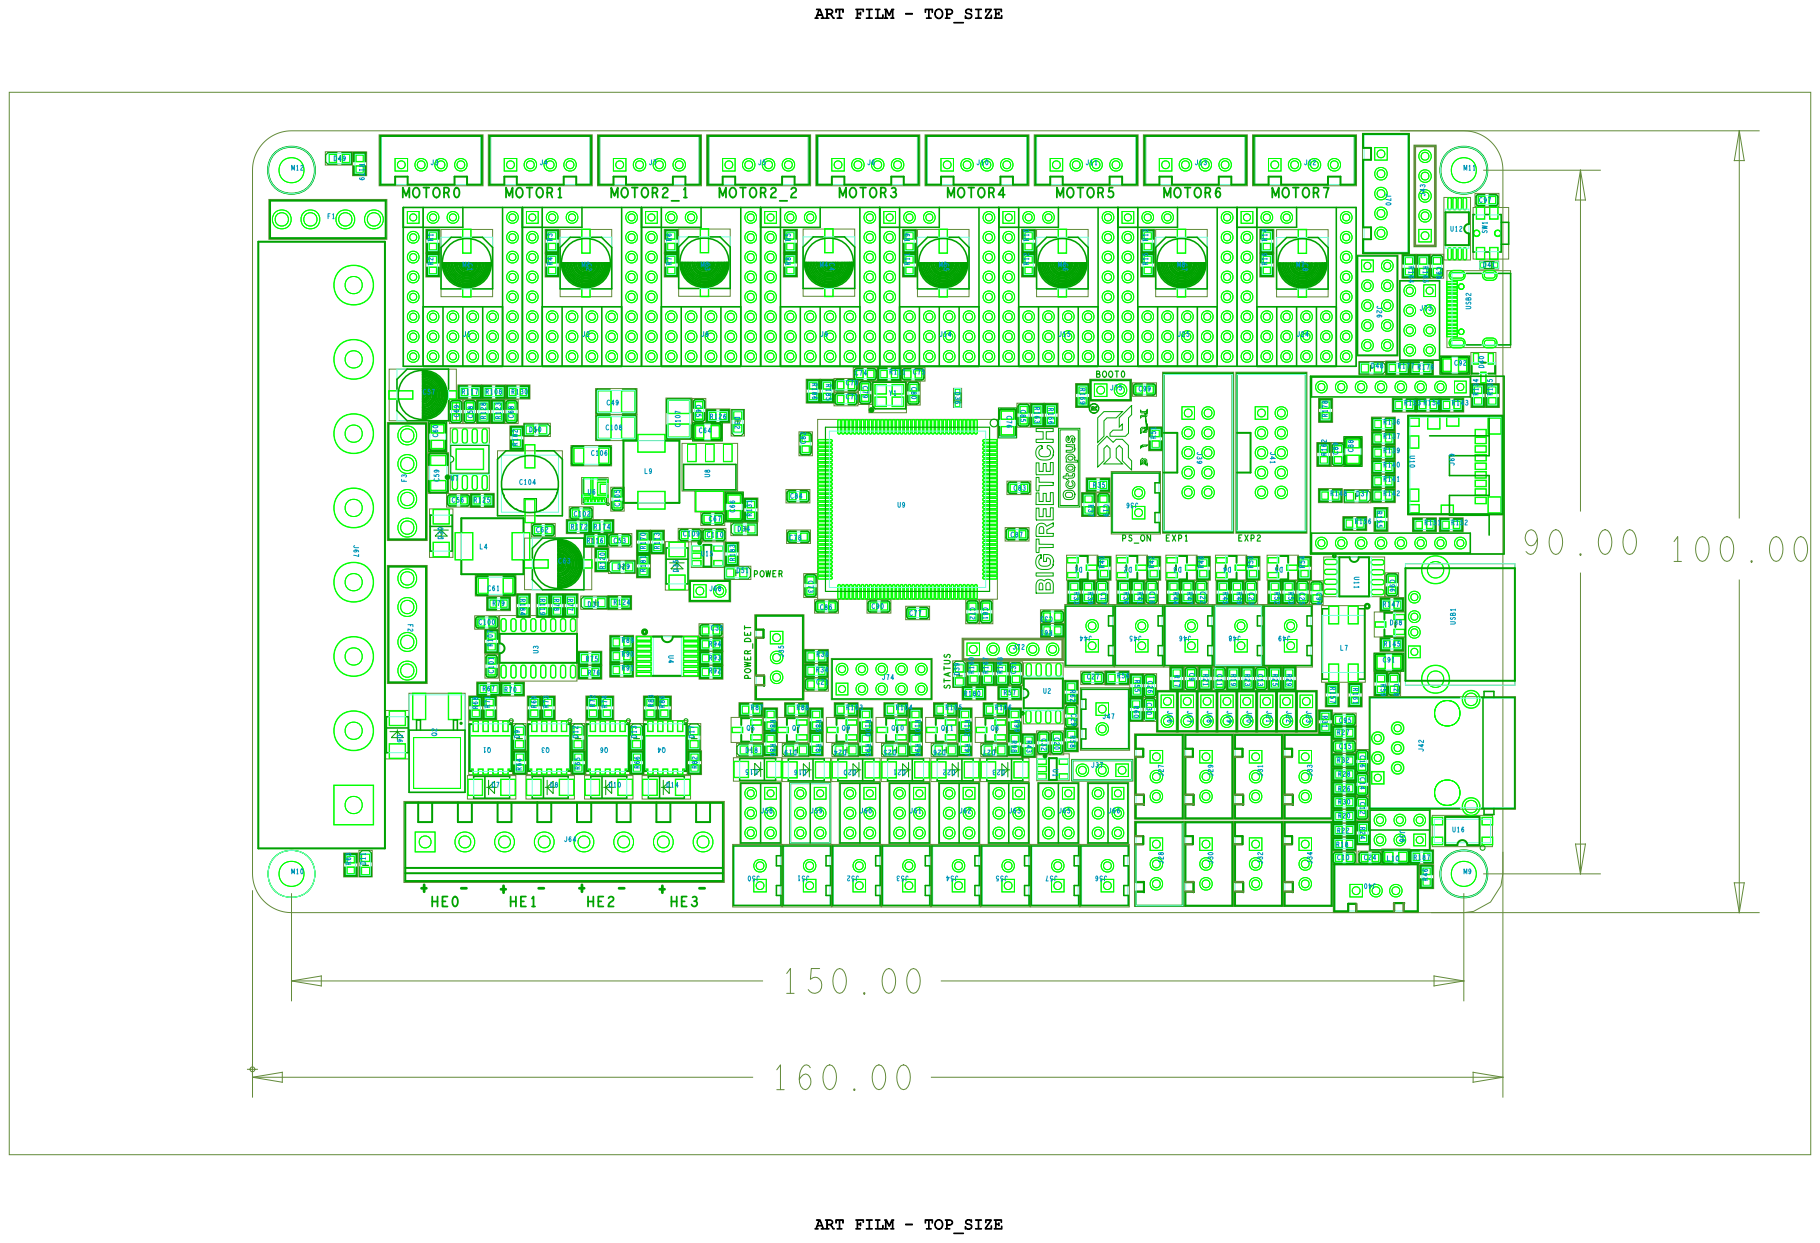
[picture p75: page 1]
