bigtreetech/BIGTREETECH-OCTOPUS-V1.0/Firmware/RepRapFirmware/RRFBuild-SourceCode/CoreN2G/src/STM32F4/HardwareSerial.cpp

/*
  HardwareSerial.cpp - Hardware serial library for Wiring
  Copyright (c) 2006 Nicholas Zambetti.  All right reserved.

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
  Modified 23 November 2006 by David A. Mellis
  Modified 28 September 2010 by Mark Sproul
  Modified 14 August 2012 by Alarus
  Modified 3 December 2013 by Matthijs Kooijman
*/

#include <stdio.h>
#include <CoreImp.h>
#include "HardwareSerial.h"

#if defined(HAL_UART_MODULE_ENABLED)
#if defined(HAVE_HWSERIAL1) || defined(HAVE_HWSERIAL2) || defined(HAVE_HWSERIAL3) ||\
    defined(HAVE_HWSERIAL4) || defined(HAVE_HWSERIAL5) || defined(HAVE_HWSERIAL6) ||\
    defined(HAVE_HWSERIAL7) || defined(HAVE_HWSERIAL8) || defined(HAVE_HWSERIAL9) ||\
    defined(HAVE_HWSERIAL10) || defined(HAVE_HWSERIALLP1)
// SerialEvent functions are weak, so when the user doesn't define them,
// the linker just sets their address to 0 (which is checked below).
#if defined(HAVE_HWSERIAL1)
TASKMEM HardwareSerial Serial1(USART1);
void serialEvent1() __attribute__((weak));
#endif

#if defined(HAVE_HWSERIAL2)
TASKMEM HardwareSerial Serial2(USART2);
void serialEvent2() __attribute__((weak));
#endif

#if defined(HAVE_HWSERIAL3)
TASKMEM HardwareSerial Serial3(USART3);
void serialEvent3() __attribute__((weak));
#endif

#if defined(HAVE_HWSERIAL4)
#if defined(USART4)
TASKMEM HardwareSerial Serial4(USART4);
#else
HardwareSerial Serial4(UART4);
#endif
void serialEvent4() __attribute__((weak));
#endif

#if defined(HAVE_HWSERIAL5)
#if defined(USART5)
TASKMEM HardwareSerial Serial5(USART5);
#else
HardwareSerial Serial5(UART5);
#endif
void serialEvent5() __attribute__((weak));
#endif

#if defined(HAVE_HWSERIAL6)
TASKMEM HardwareSerial Serial6(USART6);
void serialEvent6() __attribute__((weak));
#endif

#if defined(HAVE_HWSERIAL7)
#if defined(USART7)
TASKMEM HardwareSerial Serial7(USART7);
#else
TASKMEM HardwareSerial Serial7(UART7);
#endif
void serialEvent7() __attribute__((weak));
#endif

#if defined(HAVE_HWSERIAL8)
#if defined(USART8)
TASKMEM HardwareSerial Serial8(USART8);
#else
TASKMEM HardwareSerial Serial8(UART8);
#endif
void serialEvent8() __attribute__((weak));
#endif

#if defined(HAVE_HWSERIAL9)
TASKMEM HardwareSerial Serial9(UART9);
void serialEvent9() __attribute__((weak));
#endif

#if defined(HAVE_HWSERIAL10)
TASKMEM HardwareSerial Serial10(UART10);
void serialEvent10() __attribute__((weak));
#endif

#if defined(HAVE_HWSERIALLP1)
TASKMEM HardwareSerial SerialLP1(LPUART1);
void serialEventLP1() __attribute__((weak));
#endif
#endif // HAVE_HWSERIALx

// Constructors ////////////////////////////////////////////////////////////////
HardwareSerial::HardwareSerial(uint32_t _rx, uint32_t _tx) noexcept
{
  _serial.pin_rx = (PinName)_rx;
  _serial.pin_tx = (PinName)_tx;
  init();
}

HardwareSerial::HardwareSerial(PinName _rx, PinName _tx) noexcept
{
  _serial.pin_rx = (PinName)_rx;
  _serial.pin_tx = (PinName)_tx;
  init();
}

HardwareSerial::HardwareSerial(void *peripheral) noexcept
{
  // If Serial is defined in variant set
  // the Rx/Tx pins for com port if defined
#if defined(Serial) && defined(PIN_SERIAL_RX) && defined(PIN_SERIAL_TX)
  if ((void *)this == (void *)&Serial) {
    setRx(PIN_SERIAL_RX);
    setTx(PIN_SERIAL_TX);
  } else
#endif
#if defined(PIN_SERIAL1_RX) && defined(PIN_SERIAL1_TX) && defined(USART1_BASE)
    if (peripheral == USART1) {
      setRx(PIN_SERIAL1_RX);
      setTx(PIN_SERIAL1_TX);
    } else
#endif
#if defined(PIN_SERIAL2_RX) && defined(PIN_SERIAL2_TX) && defined(USART2_BASE)
      if (peripheral == USART2) {
        setRx(PIN_SERIAL2_RX);
        setTx(PIN_SERIAL2_TX);
      } else
#endif
#if defined(PIN_SERIAL3_RX) && defined(PIN_SERIAL3_TX) && defined(USART3_BASE)
        if (peripheral == USART3) {
          setRx(PIN_SERIAL3_RX);
          setTx(PIN_SERIAL3_TX);
        } else
#endif
#if defined(PIN_SERIAL4_RX) && defined(PIN_SERIAL4_TX) &&\
   (defined(USART4_BASE) || defined(UART4_BASE))
#if defined(USART4_BASE)
          if (peripheral == USART4)
#elif defined(UART4_BASE)
          if (peripheral == UART4)
#endif
          {
            setRx(PIN_SERIAL4_RX);
            setTx(PIN_SERIAL4_TX);
          } else
#endif
#if defined(PIN_SERIAL5_RX) && defined(PIN_SERIAL5_TX) &&\
   (defined(USART5_BASE) || defined(UART5_BASE))
#if defined(USART5_BASE)
            if (peripheral == USART5)
#elif defined(UART5_BASE)
            if (peripheral == UART5)
#endif
            {
              setRx(PIN_SERIAL5_RX);
              setTx(PIN_SERIAL5_TX);
            } else
#endif
#if defined(PIN_SERIAL6_RX) && defined(PIN_SERIAL6_TX) && defined(USART6_BASE)
              if (peripheral == USART6) {
                setRx(PIN_SERIAL6_RX);
                setTx(PIN_SERIAL6_TX);
              } else
#endif
#if defined(PIN_SERIAL7_RX) && defined(PIN_SERIAL7_TX) &&\
   (defined(USART7_BASE) || defined(UART7_BASE))
#if defined(USART7_BASE)
                if (peripheral == USART7)
#elif defined(UART7_BASE)
                if (peripheral == UART7)
#endif
                {
                  setRx(PIN_SERIAL7_RX);
                  setTx(PIN_SERIAL7_TX);
                } else
#endif
#if defined(PIN_SERIAL8_RX) && defined(PIN_SERIAL8_TX) &&\
   (defined(USART8_BASE) || defined(UART8_BASE))
#if defined(USART8_BASE)
                  if (peripheral == USART8)
#elif defined(UART8_BASE)
                  if (peripheral == UART8)
#endif
                  {
                    setRx(PIN_SERIAL8_RX);
                    setTx(PIN_SERIAL8_TX);
                  } else
#endif
#if defined(PIN_SERIAL9_RX) && defined(PIN_SERIAL9_TX) && defined(UART9)
                    if (peripheral == UART9) {
                      setRx(PIN_SERIAL9_RX);
                      setTx(PIN_SERIAL9_TX);
                    } else
#endif
#if defined(PIN_SERIAL10_RX) && defined(PIN_SERIAL10_TX) && defined(UART10)
                      if (peripheral == UART10) {
                        setRx(PIN_SERIAL10_RX);
                        setTx(PIN_SERIAL10_TX);
                      } else
#endif
#if defined(PIN_SERIALLP1_RX) && defined(PIN_SERIALLP1_TX) && defined(LPUART1_BASE)
                        if (peripheral == LPUART1) {
                          setRx(PIN_SERIALLP1_RX);
                          setTx(PIN_SERIALLP1_TX);
                        } else
#endif
                          // else get the pins of the first peripheral occurence in PinMap
                        {
                          _serial.pin_rx = pinmap_pin(peripheral, PinMap_UART_RX);
                          _serial.pin_tx = pinmap_pin(peripheral, PinMap_UART_TX);
                        }
  init();
}

void HardwareSerial::init(void) noexcept
{
  _serial.rx_buff = _rx_buffer;
  _serial.rx_head = 0;
  _serial.rx_tail = 0;
  _serial.tx_buff = _tx_buffer;
  _serial.tx_head = 0;
  _serial.tx_tail = 0;
}

void HardwareSerial::configForLowPower(void) noexcept
{
#if defined(HAL_PWR_MODULE_ENABLED) && defined(UART_IT_WUF)
  // Reconfigure properly Serial instance to use HSI as clock source
  end();
  uart_config_lowpower(&_serial);
  begin(_baud, _config);
#endif
}


// Public Methods //////////////////////////////////////////////////////////////

void HardwareSerial::begin(unsigned long baud, uint8_t config) noexcept
{
  uint32_t databits = 0;
  uint32_t stopbits = 0;
  uint32_t parity = 0;

  _baud = baud;
  _config = config;

  // Manage databits
  switch (config & 0x07) {
    case 0x02:
      databits = 6;
      break;
    case 0x04:
      databits = 7;
      break;
    case 0x06:
      databits = 8;
      break;
    default:
      databits = 0;
      break;
  }

  if ((config & 0x30) == 0x30) {
    parity = UART_PARITY_ODD;
    databits++;
  } else if ((config & 0x20) == 0x20) {
    parity = UART_PARITY_EVEN;
    databits++;
  } else {
    parity = UART_PARITY_NONE;
  }

  if ((config & 0x08) == 0x08) {
    stopbits = UART_STOPBITS_2;
  } else {
    stopbits = UART_STOPBITS_1;
  }

  switch (databits) {
#ifdef UART_WORDLENGTH_7B
    case 7:
      databits = UART_WORDLENGTH_7B;
      break;
#endif
    case 8:
      databits = UART_WORDLENGTH_8B;
      break;
    case 9:
      databits = UART_WORDLENGTH_9B;
      break;
    default:
    case 0:
      Error_Handler();
      break;
  }

  uart_init(&_serial, (uint32_t)baud, databits, parity, stopbits);
  uart_start_rx(&_serial);
}

void HardwareSerial::end() noexcept
{
  // wait for transmission of outgoing data
  flush();

  uart_deinit(&_serial);

  // clear any received data
  _serial.rx_head = _serial.rx_tail = 0;

}

int HardwareSerial::available(void) noexcept
{
  return ((unsigned int)(SERIAL_RX_BUFFER_SIZE + _serial.rx_head - _serial.rx_tail)) % SERIAL_RX_BUFFER_SIZE;
}

int HardwareSerial::peek(void) noexcept
{
  if (_serial.rx_head == _serial.rx_tail) {
    return -1;
  } else {
    return _serial.rx_buff[_serial.rx_tail];
  }
}

int HardwareSerial::read(void) noexcept
{
  // if the head isn't ahead of the tail, we don't have any characters
  if (_serial.rx_head == _serial.rx_tail) {
    return -1;
  } else {
    unsigned char c = _serial.rx_buff[_serial.rx_tail];
    _serial.rx_tail = (_serial.rx_tail + 1) % SERIAL_RX_BUFFER_SIZE;
    return c;
  }
}

int HardwareSerial::availableForWrite(void) noexcept
{
  uint32_t head = _serial.tx_head;
  uint32_t tail = _serial.tx_tail;

  if (head >= tail) {
    return SERIAL_TX_BUFFER_SIZE - 1 - head + tail;
  }
  return tail - head - 1;
}

void HardwareSerial::flush() noexcept
{
  // wait for the buffer to empty
  while ((_serial.tx_head != _serial.tx_tail)) {
    // nop, the interrupt handler will free up space for us
  }
  // and for the hardware to complete sending
  while (serial_tx_active(&_serial)) {
  }
}

size_t HardwareSerial::write(uint8_t c) noexcept
{
  uint32_t i = (_serial.tx_head + 1) % SERIAL_TX_BUFFER_SIZE;
  // If the output buffer is full, there's nothing for it other than to
  // wait for the interrupt handler to empty it a bit
  while (i == _serial.tx_tail) {
    // nop, the interrupt handler will free up space for us
  }

  _serial.tx_buff[_serial.tx_head] = c;
  _serial.tx_head = i;

  if (!serial_tx_active(&_serial)) {
    uart_start_tx(&_serial);
  }

  return 1;
}

size_t HardwareSerial::writeBlock(const uint8_t *buffer, size_t size) noexcept
{
  uint32_t head = _serial.tx_head;
  uint32_t tail = _serial.tx_tail;
  size_t toCopy = (SERIAL_TX_BUFFER_SIZE - 1 - head + tail) % SERIAL_TX_BUFFER_SIZE;

  if (toCopy > size) toCopy = size;
  if (toCopy > 0)
  {
    size_t toCopyNext;
    if (head >= tail)
    {
      size_t toCopyFirst = SERIAL_TX_BUFFER_SIZE - head;
      if (toCopy < toCopyFirst)
      {
        memcpy(&(_serial.tx_buff[head]), buffer, toCopy);
        _serial.tx_head = head + toCopy;
        return toCopy;
      }
      memcpy(&(_serial.tx_buff[head]), buffer, toCopyFirst);
      head = 0;
      toCopyNext = toCopy - toCopyFirst;
      buffer += toCopyFirst;
    }
    else
			toCopyNext = toCopy;
		memcpy(&(_serial.tx_buff[head]), buffer, toCopyNext);
		_serial.tx_head = head + toCopyNext;
  }
  return toCopy;
}

size_t HardwareSerial::write(const uint8_t *buffer, size_t size) noexcept
{
  size_t ret = size;
  while (size > 0)
  {
    size_t len = writeBlock(buffer, size);
    size -= len;
    buffer += len;
    if (len && !serial_tx_active(&_serial))
      uart_start_tx(&_serial);    
  }
  return ret;
}


void HardwareSerial::setRx(uint32_t _rx) noexcept
{
  _serial.pin_rx = (PinName)_rx;
}

void HardwareSerial::setTx(uint32_t _tx) noexcept
{
  _serial.pin_tx = (PinName)_tx;
}

void HardwareSerial::setRx(PinName _rx) noexcept
{
  _serial.pin_rx = _rx;
}

void HardwareSerial::setTx(PinName _tx) noexcept
{
  _serial.pin_tx = _tx;
}

void HardwareSerial::setInterruptPriority(uint32_t priority) noexcept
{
  uart_set_interrupt_priority(&_serial, priority);
}

uint32_t HardwareSerial::getInterruptPriority() noexcept
{
  // FIXME need to actually get the priority
  return 0;
}
#endif // HAL_UART_MODULE_ENABLED
