bigtreetech/BIGTREETECH-OCTOPUS-V1.0/Firmware/RepRapFirmware/RRFBuild-SourceCode/CoreN2G/src/LPC/SharedSPI/HardwareSPI.h

#ifndef HARDWARESPI_H
#define HARDWARESPI_H

#include "Core.h"
#include "chip.h"
#include "variant.h"
#include "SPI.h"
#include "DMA.h"

#include "FreeRTOS.h"
#include "task.h"

extern "C" void SSP0_IRQHandler(void) noexcept;
extern "C" void SSP1_IRQHandler(void) noexcept;

class HardwareSPI;
typedef void (*SPICallbackFunction)(HardwareSPI *spiDevice) noexcept;
class HardwareSPI: public SPI
{
public:
    HardwareSPI(LPC_SSP_T* sspDevice, Pin* spiPins) noexcept;
    spi_status_t transceivePacket(const uint8_t *tx_data, uint8_t *rx_data, size_t len) noexcept;
    bool waitForTxEmpty() noexcept;
    void configureDevice(uint32_t bits, uint32_t clockMode, uint32_t bitRate) noexcept; // Master mode
    void configureDevice(uint32_t deviceMode, uint32_t bits, uint32_t clockMode, uint32_t bitRate, bool hardwareCS) noexcept;
    void initPins(Pin sck, Pin miso, Pin mosi, Pin cs = NoPin) noexcept;
    void disable() noexcept;
    void flushRx() noexcept;
    void startTransfer(const uint8_t *tx_data, uint8_t *rx_data, size_t len, SPICallbackFunction ioComplete) noexcept;
    void stopTransfer() noexcept;
    static HardwareSPI SSP0;
    static HardwareSPI SSP1;

private:
    LPC_SSP_T* ssp;
    bool needInit;
    Pin * const pins;
    SPICallbackFunction callback;
    TaskHandle_t waitingTask;

    void configurePins(bool hardwareCS) noexcept;
    void configureMode(uint32_t deviceMode, uint32_t bits, uint32_t clockMode, uint32_t bitRate) noexcept;
    void configureBaseDevice() noexcept;
    friend void transferComplete(HardwareSPI *spiDevice) noexcept;
    friend void SSP0_IRQHandler(void) noexcept;
    friend void SSP1_IRQHandler(void) noexcept;
};

#endif
