bigtreetech/BIGTREETECH-OCTOPUS-V1.0/Firmware/RepRapFirmware/RRFBuild-SourceCode/CoreN2G/src/LPC/system/ExploreM3_lib/gpio.h

/***************************************************************************************************
                                   ExploreEmbedded	
****************************************************************************************************
 * File:   gpio.h
 * Version: 15.0
 * Author: ExploreEmbedded
 * Website: http://www.exploreembedded.com/wiki
 * Description: File contains the the gpio pin number configuration and  
                function prototypes for the gpio routines
 
The libraries have been tested on ExploreEmbedded development boards. We strongly believe that the 
library works on any of development boards for respective controllers. However, ExploreEmbedded 
disclaims any kind of hardware failure resulting out of usage of libraries, directly or indirectly.
Files may be subject to change without prior notice. The revision history contains the information 
related to updates. 
 
 
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
Errors and omissions should be reported to codelibraries@exploreembedded.com
 **************************************************************************************************/
 
 
 /***************************************************************************************************
                             Revision History
****************************************************************************************************				   
15.0: Initial version 
***************************************************************************************************/

#ifdef __cplusplus
extern "C" {
#endif
 
#ifndef _GPIO_H
#define _GPIO_H

#include"stdutils.h"


typedef enum
{
    P0_0, P0_1, P0_2, P0_3, P0_4, P0_5, P0_6, P0_7, P0_8, P0_9, P0_10,P0_11,P0_12,P0_13,P0_14,P0_15,
    P0_16,P0_17,P0_18,P0_19,P0_20,P0_21,P0_22,P0_23,P0_24,P0_25,P0_26,P0_27,P0_28,P0_29,P0_30,P0_31,

    P1_0, P1_1, P1_2, P1_3, P1_4, P1_5, P1_6, P1_7, P1_8, P1_9, P1_10,P1_11,P1_12,P1_13,P1_14,P1_15,
    P1_16,P1_17,P1_18,P1_19,P1_20,P1_21,P1_22,P1_23,P1_24,P1_25,P1_26,P1_27,P1_28,P1_29,P1_30,P1_31,

    P2_0, P2_1, P2_2, P2_3, P2_4, P2_5, P2_6, P2_7, P2_8, P2_9, P2_10,P2_11,P2_12,P2_13,P2_14,P2_15,
    P2_16,P2_17,P2_18,P2_19,P2_20,P2_21,P2_22,P2_23,P2_24,P2_25,P2_26,P2_27,P2_28,P2_29,P2_30,P2_31,

    P3_0, P3_1, P3_2, P3_3, P3_4, P3_5, P3_6, P3_7, P3_8, P3_9, P3_10,P3_11,P3_12,P3_13,P3_14,P3_15,
    P3_16,P3_17,P3_18,P3_19,P3_20,P3_21,P3_22,P3_23,P3_24,P3_25,P3_26,P3_27,P3_28,P3_29,P3_30,P3_31,

    P4_0, P4_1, P4_2, P4_3, P4_4, P4_5, P4_6, P4_7, P4_8, P4_9, P4_10,P4_11,P4_12,P4_13,P4_14,P4_15,
    P4_16,P4_17,P4_18,P4_19,P4_20,P4_21,P4_22,P4_23,P4_24,P4_25,P4_26,P4_27,P4_28,P4_29,P4_30,P4_31,
    P_END,
    P_NC = 0xff
}gpioPins_et; 



/*************************************************************************************************
                           Constants for PIN Function Selection
*************************************************************************************************/
#define PINSEL_FUNC_0 0x00u   
#define PINSEL_FUNC_1 0x01u
#define PINSEL_FUNC_2 0x02u
#define PINSEL_FUNC_3 0x03u
/*************************************************************************************************/



//Input Pin Settings
#define LPC_INPUT_PULLUP              0      //Pin has an on-chip pull-up resistor enabled (default on reset)
#define LPC_INPUT_REPEATER            1      //Repeater mode - Repeater mode enables the pull-up resistor if the pin is at a logic high and enables the
                                             //pull-down resistor if the pin is at a logic low. This causes the pin to retain its last known
                                             //state if it is configured as an input and is not driven externally.
#define LPC_INPUT_NOPULLUP_NOPULLDOWN 2      //Pin has neither pull-up nor pull-down resistor enabled.
#define LPC_INPUT_PULLDOWN            3      //Pin has an on-chip pull-down resistor enabled.
     
//opendrain modes
#define LPC_NOT_OPEN_DRAIN_MODE       4
#define LPC_OPEN_DRAIN_MODE           5
     

/***************************************************************************************************
                             Function prototypes
***************************************************************************************************/
/*inline*/ void GPIO_PinInputMode(gpioPins_et enm_pinNumber, uint8_t var_pinFunction_u8) noexcept;
/*inline*/ void GPIO_PinFunction(gpioPins_et enm_pinNumber, uint8_t var_pinFunction_u8) noexcept;
/*inline*/ void GPIO_PinDirection(gpioPins_et enm_pinNumber, uint8_t var_pinDirn_u8) noexcept;
/*inline*/ void GPIO_PinWrite(gpioPins_et enm_pinNumber, uint8_t var_pinValue_u8) noexcept;
/*inline*/ uint8_t GPIO_PinRead(gpioPins_et enm_pinNumber) noexcept;

/*inline*/ volatile uint32_t *GPIO_BB_PinDirectionPtr(gpioPins_et enm_pinNumber) noexcept;
/*inline*/ volatile uint32_t *GPIO_BB_PinValuePtr(gpioPins_et enm_pinNumber) noexcept;



/**************************************************************************************************/

//Direction
#define LPC_INPUT  0x00u
#define LPC_OUTPUT 0x01u



#endif

#ifdef __cplusplus
}
#endif
