bigtreetech/BIGTREETECH-OCTOPUS-V1.0/Firmware/RepRapFirmware/RRFBuild-SourceCode/CoreN2G/src/STM32F4/SharedSPI/HardwareSPI.h

#ifndef HARDWARESPI_H
#define HARDWARESPI_H

#include "CoreImp.h"
#include "SPI.h"

#include "FreeRTOS.h"
#include "task.h"
#include "spi_com.h"
#if SPI1DMA
extern "C" void DMA2_Stream2_IRQHandler(void) noexcept;
extern "C" void DMA2_Stream3_IRQHandler(void) noexcept;
#endif
extern "C" void DMA1_Stream3_IRQHandler(void) noexcept;
extern "C" void DMA1_Stream4_IRQHandler(void) noexcept;
extern "C" void DMA1_Stream0_IRQHandler(void) noexcept;
extern "C" void DMA1_Stream5_IRQHandler(void) noexcept;

class HardwareSPI;
typedef void (*SPICallbackFunction)(HardwareSPI *spiDevice) noexcept;
class HardwareSPI: public SPI
{
public:
    HardwareSPI(SPI_TypeDef *spi) noexcept;
    spi_status_t transceivePacket(const uint8_t *tx_data, uint8_t *rx_data, size_t len) noexcept;
    bool waitForTxEmpty() noexcept;
    void configureDevice(uint32_t bits, uint32_t clockMode, uint32_t bitRate) noexcept; // Master mode
    void configureDevice(uint32_t deviceMode, uint32_t bits, uint32_t clockMode, uint32_t bitRate, bool hardwareCS) noexcept;
    void initPins(Pin clk, Pin miso, Pin mosi, Pin cs = NoPin, DMA_Stream_TypeDef* rxStream = nullptr, uint32_t rxChan = 0, IRQn_Type rxIrq = DMA1_Stream0_IRQn,
                            DMA_Stream_TypeDef* txStream = nullptr, uint32_t txChan = 0, IRQn_Type txIrq = DMA1_Stream0_IRQn) noexcept;
    void disable() noexcept;
    void flushRx() noexcept;
    void startTransfer(const uint8_t *tx_data, uint8_t *rx_data, size_t len, SPICallbackFunction ioComplete) noexcept;
    void stopTransfer() noexcept;
    static HardwareSPI SSP1;
    static HardwareSPI SSP2;
    static HardwareSPI SSP3;

private:
    bool usingDma;
    spi_t spi;
    SPI_TypeDef *dev;
    DMA_HandleTypeDef dmaRx;
    DMA_HandleTypeDef dmaTx;
    Pin csPin;
    uint32_t curBitRate;
    uint32_t curBits;
    uint32_t curClockMode;
    bool initComplete;
    SPICallbackFunction callback;
    TaskHandle_t waitingTask;
    bool transferActive;
    void initDmaStream(DMA_HandleTypeDef& hdma, DMA_Stream_TypeDef *inst, uint32_t chan, IRQn_Type irq, uint32_t dir, uint32_t minc) noexcept;
    void startTransferAndWait(const uint8_t *tx_data, uint8_t *rx_data, size_t len) noexcept;

#if SPI1DMA
    friend void DMA2_Stream2_IRQHandler() noexcept;
    friend void DMA2_Stream3_IRQHandler() noexcept;
#endif
    friend void DMA1_Stream3_IRQHandler() noexcept;
    friend void DMA1_Stream4_IRQHandler() noexcept;
    friend void DMA1_Stream0_IRQHandler() noexcept;
    friend void DMA1_Stream5_IRQHandler() noexcept;
    friend void transferComplete(HardwareSPI *spiDevice) noexcept;
    friend void HAL_SPI_TxCpltCallback(SPI_HandleTypeDef *hspi);
    friend void HAL_SPI_TxRxCpltCallback(SPI_HandleTypeDef *hspi);
};

#endif
