bigtreetech/BIGTREETECH-OCTOPUS-V1.0/Firmware/RepRapFirmware/RRFBuild-SourceCode/CoreN2G/src/LPC/SoftwarePWM/SoftwarePWMTimer.cpp

/* mbed Microcontroller Library
* Copyright (c) 2006-2013 ARM Limited
*
* Licensed under the Apache License, Version 2.0 (the "License");
* you may not use this file except in compliance with the License.
* You may obtain a copy of the License at
*
*     http://www.apache.org/licenses/LICENSE-2.0
*
* Unless required by applicable law or agreed to in writing, software
* distributed under the License is distributed on an "AS IS" BASIS,
* WITHOUT WARRANTIES OR CONDITIONS OF ANY KIND, either express or implied.
* See the License for the specific language governing permissions and
* limitations under the License.
*/

/*
* This version rewritten by gloomyandy to simplify and improve performance.
* The interrupt handler now operates in a more predictable way with the time needed
* being linearly related to the number of active channels. Care has been taken to
* try to minimize the number of interrupts needed by allowing channels that have period
* this is a multiple of other channels to be synchronized. The following timing offers
* a comparison to previous versions. A simple test that involved running a simulation
* of the well known 3DBenchy was run with nozzle and bed heaters enabled. Two cooling
* fans were also active. Three versions are compared. The original implementation (1),
* an "improved" version of this code (2) and the current version provided here (3).
* 
* Version     no of interrupts  no of pulses    min time   max time
* 1           1712539           2363134         13uS       45uS
* 2           1708399           2283163         9uS        24uS
* 3           1079673           2159908         3uS         6uS 
*
* The slightly lower no of pulses required by the different versions is due to the overall
* elapsed time being shorter (approx 19mins, 18mins and 17mins).
* Note: The above tests were run on a system configured with no higher priority interrupts
* active. With more recent versions of RRF the software uart runs at a higher priority in
* this configuration the current code has a min time of 3uS and max time of 24uS.
*/

#include "SoftwarePWMTimer.h"
#include "SoftwarePWM.h"

#ifdef LPC_DEBUG
uint32_t pwmInts = 0;
uint32_t pwmCalls = 0;
uint32_t pwmMinTime = 0xffffffff;
uint32_t pwmMaxTime = 0;
uint32_t pwmAdjust = 0;
uint32_t pwmBad = 0;
uint32_t pwmBigDelta = 0;
#endif

// Minimum period between interrupts - in microseconds (to prevent starving other tasks)
static constexpr uint32_t MinimumInterruptDeltaUS = 20;

static constexpr int MaxPWMPins = 8;

typedef struct {
    uint32_t nextEvent;
    SoftwarePWM *pwm;
    uint32_t onOffTimes[2][2];
    uint8_t state;
    uint8_t onOffBuffer;
    bool newTimes;
    bool enabled;
} PWMState;

static PWMState States[MaxPWMPins];
static int32_t startActive = -1;
static int32_t endActive = -1;
static uint32_t ticksPerMicrosecond;
static uint32_t minimumTicks;



SoftwarePWMTimer softwarePWMTimer;

SoftwarePWMTimer::SoftwarePWMTimer()
{

    for(int i = 0; i < MaxPWMPins; i++)
        States[i].enabled = false;
    ticksPerMicrosecond = Chip_Clock_GetPeripheralClockRate(SYSCTL_PCLK_RIT)/1000000;
    minimumTicks = ticksPerMicrosecond*MinimumInterruptDeltaUS;

    //Setup RIT
    Chip_Clock_EnablePeriphClock(SYSCTL_CLOCK_RIT); //enable power and clocking
    LPC_RITIMER->MASK = 0;
    LPC_RITIMER->COUNTER = 0;
    LPC_RITIMER->CTRL = RIT_CTRL_INT | RIT_CTRL_ENBR | RIT_CTRL_TEN;
}

static void updateActive()
{
    int32_t first = -1;
    int32_t last = -1;
    for(int i = 0; i < MaxPWMPins; i++)
        if (States[i].enabled)
        {
            last = i;
            if (first < 0) first = i;
        }
    if (last >= 0)
    {
        last += 1;
        // If timer not currently running restart it
        if (endActive < 0)
        {
            LPC_RITIMER->COMPVAL = LPC_RITIMER->COUNTER + minimumTicks; 
            LPC_RITIMER->CTRL |= RIT_CTRL_INT; // Clear Interrupt
            NVIC_EnableIRQ(RITIMER_IRQn); 
        }
    }
    else
        NVIC_DisableIRQ(RITIMER_IRQn);
    startActive = first;
    endActive = last;
}

void syncAll()
{
    // briefy pause and then restart all active channels so that they are in sync.
    // this minimises the number of interrupts we need, to service the channels.
    LPC_RITIMER->CTRL &= ~RIT_CTRL_TEN; //Stop the timer
    // set all active channels so that on the next event they will all move to state 0
    for(int i = 0; i < MaxPWMPins; i++)
        if (States[i].enabled)
        {
            States[i].state = 1;
            States[i].nextEvent = LPC_RITIMER->COUNTER;
        }
    // Force an event
    LPC_RITIMER->COMPVAL = LPC_RITIMER->COUNTER + minimumTicks; 
    LPC_RITIMER->CTRL |= RIT_CTRL_TEN; // start the timer
} 

void SoftwarePWMTimer::disable(int chan)
{
    States[chan].enabled = false;
    updateActive();
}

int SoftwarePWMTimer::enable(SoftwarePWM *pwm, uint32_t onTime, uint32_t offTime)
{
    // find a free slot
    for(int i = 0; i < MaxPWMPins; i++)
        if (!States[i].enabled)
        {
            PWMState& s = States[i];
            s.pwm = pwm;
            s.onOffTimes[0][0] = onTime*ticksPerMicrosecond;
            s.onOffTimes[0][1] = offTime*ticksPerMicrosecond;
            s.onOffBuffer = 0;
            s.state = 0;
            pwm->SetHigh();
            s.nextEvent = LPC_RITIMER->COUNTER + onTime;
            s.newTimes = false;
            s.enabled = true;
            updateActive();  
            syncAll();        
            return i;
        }
    return -1;
}

void SoftwarePWMTimer::adjustOnOffTime(int chan, uint32_t onTime, uint32_t offTime)
{
    PWMState& s = States[chan];
    uint32_t buffer = s.onOffBuffer ^ 1;
    s.onOffTimes[buffer][0] = onTime*ticksPerMicrosecond;
    s.onOffTimes[buffer][1] = offTime*ticksPerMicrosecond;
    s.newTimes = true;
}

extern "C" void RIT_IRQHandler(void) __attribute__ ((hot));
void RIT_IRQHandler(void)
{ 
#ifdef LPC_DEBUG
    pwmInts++;
    const uint32_t startTime = LPC_TIMER0->TC;
#endif 
    LPC_RITIMER->CTRL |= RIT_CTRL_INT; // Clear Interrupt
    uint32_t next = 0x7fffffff;
    uint32_t now = LPC_RITIMER->COUNTER;
    for(int i = startActive; i < endActive; i++)
        if (States[i].enabled)
        {
            PWMState& s = States[i];
            int32_t delta = (s.nextEvent - now);
            if (delta <= 0)
            {
                // time has expired, move to next state
                s.state ^= 1;
                const uint32_t newState = s.state;
                // do we need to switch to a new set of timing parameters?
                if (newState == 0)
                {
                    s.pwm->SetHigh();
                    if (s.newTimes)
                    {
                        s.onOffBuffer ^= 1;
                        s.newTimes = false;
                    }
                }
                else
                    s.pwm->SetLow();
                // adjust next time by any drift to keep things in sync
                delta += s.onOffTimes[s.onOffBuffer][newState];
                s.nextEvent = now + delta;
                // don't allow correction to go too far!
                if (delta < 0)
                {
                    // If delta is still -ve then this means that the call to the int handler
                    // was so late that it has exceeded the length of time of the current pulse.
                    // This may happen with very short pulses (ones that are less than our defined
                    // minimum). In this case we will have set a nextEvent time that is in the past.
                    // this is not a problem so long as the next pulse length is long enough that it
                    // can cover the accumulated delay and allow us to catch up. This is typically
                    // the case with a PWM signal. Obviously we can't set a next event time in the
                    // past so we zero it here, but carry the delta forwards in nextEvent.
                    delta = 0;
#ifdef LPC_DEBUG
                    pwmBigDelta++;
#endif
                }
#ifdef LPC_DEBUG
                pwmCalls++;
#endif
            }
            // at this point delta >= 0, now track the smallest delta as the next target time
            if ((uint32_t)delta < next)
                next = (uint32_t)delta;
        }
    // setup the timer for the nearest event time
    if (next < minimumTicks)
    {
        // extend the time if it is less than our minimum
        next = minimumTicks;
#ifdef LPC_DEBUG
        pwmAdjust++;
#endif
    }
    // Set the new compare value
    LPC_RITIMER->COMPVAL = now + next;
    // Check to make sure that we have not just set a time that is in the past.
    // This can happen if the execution of this interrupt handler is delayed
    // significantly. If this happens we reset the event time into the future
    // and check again (just in case!).
    while((int32_t)(LPC_RITIMER->COMPVAL - LPC_RITIMER->COUNTER) <= 0)
    {
#ifdef LPC_DEBUG
        pwmBad++;
#endif
        LPC_RITIMER->COMPVAL = LPC_RITIMER->COUNTER + minimumTicks;
    }

#ifdef LPC_DEBUG
    const uint32_t dt = LPC_TIMER0->TC - startTime;
    if (dt < pwmMinTime)
        pwmMinTime = dt;
    else if (dt > pwmMaxTime)
        pwmMaxTime = dt;
#endif
}

#ifdef LPC_DEBUG_XXX
void SoftwarePWMTimer::Diagnostics(MessageType mtype)
{
    reprap.GetPlatform().MessageF(mtype, "Ints: %u; Calls %u; fast: %uuS; slow %uuS adj %u bad %u big delta %u\n", (unsigned)pwmInts, (unsigned)pwmCalls, (unsigned)pwmMinTime, (unsigned)pwmMaxTime, (unsigned)pwmAdjust, (unsigned)pwmBad, (unsigned)pwmBigDelta);
    pwmMinTime = UINT32_MAX;
    pwmMaxTime = 0;
    pwmInts = 0;
    pwmCalls = 0;
    pwmAdjust = 0;
    pwmBad = 0;
    pwmBigDelta = 0;

    reprap.GetPlatform().MessageF(mtype, "PWM Channels\n");

    /* disable interrupts for the duration of the function */
    LPC_RITIMER->CTRL &= ~RIT_CTRL_TEN; //Stop the timer
    uint32_t now = LPC_RITIMER->COUNTER;
    uint32_t delta = LPC_RITIMER->COMPVAL - now;
    for(int i = 0; i < MaxPWMPins; i++)
    {
        if (States[i].enabled)
            reprap.GetPlatform().MessageF(mtype, "state %d next %d on %u off %u pin %d.%d\n", i, (int)(States[i].nextEvent - now), (unsigned)States[i].onOffTimes[States[i].onOffBuffer][0], (unsigned)States[i].onOffTimes[States[i].onOffBuffer][1],  (States[i].pwm->GetPin() >> 5), (States[i].pwm->GetPin() & 0x1f) );
    }
    reprap.GetPlatform().MessageF(mtype, "Delta %d Start %d End %d\n", static_cast<int>(delta), static_cast<int>(startActive), static_cast<int>(endActive));
    LPC_RITIMER->CTRL |= RIT_CTRL_TEN;
}
#endif
