bigtreetech/BIGTREETECH-OCTOPUS-V1.0/Firmware/RepRapFirmware/RRFBuild-SourceCode/CoreN2G/src/LPC/variants/LPC/variant.cpp

/*
  Copyright (c) 2011 Arduino.  All right reserved.

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
  You should have received a copy of the GNU Lesser General Public
  License along with this library; if not, write to the Free Software
  Foundation, Inc., 51 Franklin St, Fifth Floor, Boston, MA  02110-1301  USA
*/
#include "CoreImp.h"
#include "variant.h"


void ConfigurePin(const PinDescription& pinDesc) noexcept
{
//UnUsed
    //pio_configure(pinDesc.pPort, pinDesc.ulPinType, pinDesc.ulPin, pinDesc.ulPinConfiguration);
}


extern const PinDescription g_APinDescription[]=
{
//   Port,      Attributes,                        ADCChannelNumber     PWM Channel,
    {0,     PIN_ATTR_DIGITAL,                               NO_ADC,     NOT_ON_PWM}, //P0_0},
    {0,     PIN_ATTR_DIGITAL,                               NO_ADC,     NOT_ON_PWM}, //P0_1},
    {0,     PIN_ATTR_DIGITAL|PIN_ATTR_ANALOG,               ADC7,       NOT_ON_PWM}, //P0_2},
    {0,     PIN_ATTR_DIGITAL|PIN_ATTR_ANALOG,               ADC6,       NOT_ON_PWM}, //P0_3},
    {0,     PIN_ATTR_DIGITAL,                               NO_ADC,     NOT_ON_PWM}, //P0_4},
    {0,     PIN_ATTR_DIGITAL,                               NO_ADC,     NOT_ON_PWM}, //P0_5},
    {0,     PIN_ATTR_DIGITAL,                               NO_ADC,     NOT_ON_PWM}, //P0_6},
    {0,     PIN_ATTR_DIGITAL,                               NO_ADC,     NOT_ON_PWM}, //P0_7},
    {0,     PIN_ATTR_DIGITAL,                               NO_ADC,     NOT_ON_PWM}, //P0_8},
    {0,     PIN_ATTR_DIGITAL,                               NO_ADC,     NOT_ON_PWM}, //P0_9},
    {0,     PIN_ATTR_DIGITAL,                               NO_ADC,     NOT_ON_PWM}, //P0_10},
    {0,     PIN_ATTR_DIGITAL,                               NO_ADC,     NOT_ON_PWM}, //P0_11},
    {0,     PIN_ATTR_DIGITAL,                               NO_ADC,     NOT_ON_PWM}, //P0_12},
    {0,     PIN_ATTR_DIGITAL,                               NO_ADC,     NOT_ON_PWM}, //P0_13},
    {0,     PIN_ATTR_DIGITAL,                               NO_ADC,     NOT_ON_PWM}, //P0_14},
    {0,     PIN_ATTR_DIGITAL,                               NO_ADC,     NOT_ON_PWM}, //P0_15},
    {0,     PIN_ATTR_DIGITAL,                               NO_ADC,     NOT_ON_PWM}, //P0_16},
    {0,     PIN_ATTR_DIGITAL,                               NO_ADC,     NOT_ON_PWM}, //P0_17},
    {0,     PIN_ATTR_DIGITAL,                               NO_ADC,     NOT_ON_PWM}, //P0_18},
    {0,     PIN_ATTR_DIGITAL,                               NO_ADC,     NOT_ON_PWM}, //P0_19},
    {0,     PIN_ATTR_DIGITAL,                               NO_ADC,     NOT_ON_PWM}, //P0_20},
    {0,     PIN_ATTR_DIGITAL,                               NO_ADC,     NOT_ON_PWM}, //P0_21},
    {0,     PIN_ATTR_DIGITAL,                               NO_ADC,     NOT_ON_PWM}, //P0_22},
    {0,     PIN_ATTR_DIGITAL|PIN_ATTR_ANALOG,               ADC0,       NOT_ON_PWM}, //P0_23},
    {0,     PIN_ATTR_DIGITAL|PIN_ATTR_ANALOG,               ADC1,       NOT_ON_PWM}, //P0_24},
    {0,     PIN_ATTR_DIGITAL|PIN_ATTR_ANALOG,               ADC2,       NOT_ON_PWM}, //P0_25},
    {0,     PIN_ATTR_DIGITAL|PIN_ATTR_ANALOG|PIN_ATTR_DAC,  ADC3,       NOT_ON_PWM}, //P0_26},
    {0,     PIN_ATTR_DIGITAL,                               NO_ADC,     NOT_ON_PWM}, //P0_27},
    {0,     PIN_ATTR_DIGITAL,                               NO_ADC,     NOT_ON_PWM}, //P0_28},
    // 0_29 & 30 USB D+ & D-
    {0,     PIN_ATTR_DIGITAL,                               NO_ADC,     NOT_ON_PWM}, //P0_29},
    {0,     PIN_ATTR_DIGITAL,                               NO_ADC,     NOT_ON_PWM}, //P0_30},
    
    {0,     PIN_ATTR_DIGITAL,                               NO_ADC,     NOT_ON_PWM}, //P0_31},
    
    {1,     PIN_ATTR_DIGITAL,                               NO_ADC,     NOT_ON_PWM}, //P1_0},
    {1,     PIN_ATTR_DIGITAL,                               NO_ADC,     NOT_ON_PWM}, //P1_1},
    {1,     PIN_ATTR_DIGITAL,                               NO_ADC,     NOT_ON_PWM}, //P1_2},
    {1,     PIN_ATTR_DIGITAL,                               NO_ADC,     NOT_ON_PWM}, //P1_3},
    {1,     PIN_ATTR_DIGITAL,                               NO_ADC,     NOT_ON_PWM}, //P1_4},
    {1,     PIN_ATTR_DIGITAL,                               NO_ADC,     NOT_ON_PWM}, //P1_5},
    {1,     PIN_ATTR_DIGITAL,                               NO_ADC,     NOT_ON_PWM}, //P1_6},
    {1,     PIN_ATTR_DIGITAL,                               NO_ADC,     NOT_ON_PWM}, //P1_7},
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
    {4,     PIN_ATTR_DIGITAL,                               NO_ADC,     NOT_ON_PWM}, //P4_18},
    {4,     PIN_ATTR_DIGITAL,                               NO_ADC,     NOT_ON_PWM}, //P4_19},
    {4,     PIN_ATTR_DIGITAL,                               NO_ADC,     NOT_ON_PWM}, //P4_20},
    {4,     PIN_ATTR_DIGITAL,                               NO_ADC,     NOT_ON_PWM}, //P4_21},
    {4,     PIN_ATTR_DIGITAL,                               NO_ADC,     NOT_ON_PWM}, //P4_22},
    {4,     PIN_ATTR_DIGITAL,                               NO_ADC,     NOT_ON_PWM}, //P4_23},
    {4,     PIN_ATTR_DIGITAL,                               NO_ADC,     NOT_ON_PWM}, //P4_24},
    {4,     PIN_ATTR_DIGITAL,                               NO_ADC,     NOT_ON_PWM}, //P4_25},
    {4,     PIN_ATTR_DIGITAL,                               NO_ADC,     NOT_ON_PWM}, //P4_26},
    {4,     PIN_ATTR_DIGITAL,                               NO_ADC,     NOT_ON_PWM}, //P4_27},
    {4,     PIN_ATTR_DIGITAL,                               NO_ADC,     NOT_ON_PWM}, //P4_28},
    {4,     PIN_ATTR_DIGITAL,                               NO_ADC,     NOT_ON_PWM}, //P4_29},
    {4,     PIN_ATTR_DIGITAL,                               NO_ADC,     NOT_ON_PWM}, //P4_30},
    {4,     PIN_ATTR_DIGITAL,                               NO_ADC,     NOT_ON_PWM}, //P4_31},
    
};



void init( void ) noexcept
{
}
