bigtreetech/BIGTREETECH-OCTOPUS-V1.0/(commit log)

2021-06-18 rebase first init
    [Configuration.h, Configuration_adv.h, Octopus klipper.cfg, bed.g, config.g, deployprobe.g, homeall.g, homex.g]
2021-06-28 Octopus stand for voron v2.4
    [Octopus stand Vertical.STEP, Octopus stand Vertical.STL, Octopus stand Horizontal.STEP, Octopus stand Horizontal.STL, Snaps.STEP, Snaps.STL]
2021-07-01 firmware & wiring works on Voron v2.4
    [BTT_OctoPus_Voron2_Config.cfg, Octopus klipper.cfg, Octopus stand Vertical.STEP, Octopus stand Vertical.STL, Octopus stand Horizontal.STEP, Octopus stand Horizontal.STL, Snaps.STEP, Snaps.STL]
2021-07-03 upload readme for klipper (have not finished)
    [BTT_OctoPus_Voron2_Config.cfg, Octopus klipper.cfg]
2021-07-05 update klipper readme(finished)
    [Octopus klipper.cfg]
2021-07-08 update Marlin to 2.0.9.1.x & add the readme of How octoprint communicates with Marlin through UART
    [Configuration.h, Configuration_adv.h]
2021-07-09 OCTOPUS wiring diagram
2021-07-15 add RRF source code
    [Configuration.h, Memory usage.ods, duet3_openocd.cfg]
2021-07-22 fix Probe PB7 config
    [BTT_OctoPus_Voron2_Config.cfg]
2021-08-12 add TFT emulated 12864 mode cfg
    [Octopus klipper.cfg]
2021-10-12 Update pins_BTT_OCTOPUS_V1_common.h (#75)
    Introduced a (quick) fix for allowing use of MKS12864A/B and MKS_MINI_12864 LCD. See issue #70. Credits for the original work to @Gleb1982
    The only small issue remaining is that FPC cables will need to be inverted (rotated by 180°) when connecting to the motherboard socket. Even tough, it's a trivial issue that mostly are familiar with.
2021-10-12 Bug: Fotek PL-05N probe (#71)
    [BTT_OctoPus_Voron2_Config.cfg]
2021-10-19 sync Voron readme
    [BTT_OctoPus_Voron2_Config.cfg]
2021-12-14 update Marlin to 2.0.9.2.x
    [Configuration.h, Configuration_adv.h, esp32.csv]
2022-05-09 update STM32F407ZE support
    [Configuration.h, Configuration_adv.h, esp32.csv]
2022-11-23 update STM32H723 support
    [Configuration.h, Configuration_adv.h]
2022-12-29 Updated DFU Update Document (#132)
    The procedure reported a wrong instruction: to enter DFU Mode on Octopus 1.1 one needs to keep pushing the "reset" button for at least 5s while connected to the board via USB-C.
2022-12-29 typo: kliiper <-> klipper (#130)
2023-04-26 add Octopus Pro V1.1 info
    [BTT_OctoPus_Pro_V1.1_Voron2_Config.cfg, Configuration.h, Octopus klipper.cfg, generic-bigtreetech-octopus-pro-v1.1.cfg, generic-bigtreetech-octopus.cfg]
2023-07-26 fix probe port
    [BTT_OctoPus_Pro_V1.1_Voron2_Config.cfg, BTT_OctoPus_Voron2_Config.cfg]
