bigtreetech/BIGTREETECH-OCTOPUS-V1.0/(notices)

Notices in the files:
Firmware/Marlin-bugfix-2.0.9.3.x/Marlin/Configuration_adv.h:
Copyright (c) 2020 MarlinFirmware [https://github.com/MarlinFirmware/Marlin]
Copyright (c) 2011 Camiel Gubbels / Erik van der Zalm
This program is free software: you can redistribute it and/or modify
it under the terms of the GNU General Public License as published by
the Free Software Foundation, either version 3 of the License, or
(at your option) any later version.
define TOUCH_UI_UTF8_COPYRIGHT // © ®
Firmware/RepRapFirmware/RRFBuild-SourceCode/CoreN2G/src/LPC/ExploreM3/ExploreM3_lib/gpio.c:
GNU GENERAL PUBLIC LICENSE: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
Firmware/RepRapFirmware/RRFBuild-SourceCode/RepRapFirmware/src/Configuration.h:
Licence: GPL
